kerteszsasa/kicad_user_lib/README.md

# kicad_user_lib

## Usage:
* Clone the repo to anywhere to your home folder
* Configure CUSTOM_SYMBOL_DIR, CUSTOM_FOOTPRINT_DIR, CUSTOM_3DMODEL_DIR paths at kicad
* Find the kicad configuration folder, mine is at /home/kerteszs/.config/kicad/9.0
* Extend the sym-lib-table with fp-lib-table-extension
* Extend the fp-lib-table table with fp-lib-table-extension
