kerteszsasa/kicad_user_lib/external_plugins/idata_release/idata_release.png

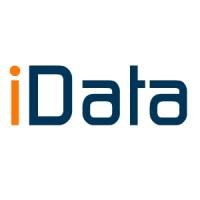
external_plugins/idata_release/idata_release.png
