kerteszsasa/kicad_user_lib/external_plugins/LCSC_import/LCSC_import.png

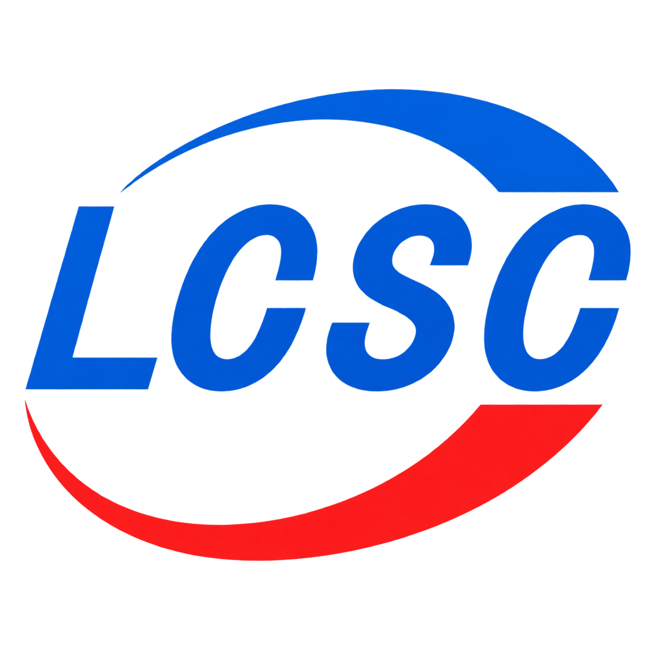
external_plugins/LCSC_import/LCSC_import.png
