kerteszsasa/kicad_user_lib/3dmodels/Rf_conn_SMB.stp

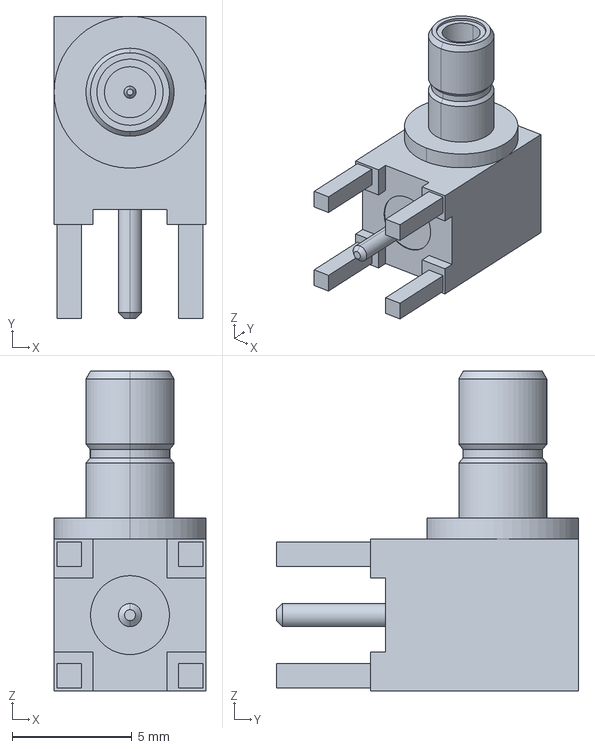
[picture p3: CAD file, 2026-07-15]
3dmodels/Rf_conn_SMB.stp
6.35 x 12.6 x 13.4 mm
