kerteszsasa/kicad_user_lib/3dmodels/CAP-SMD_L4.3-W4.3-H5.3-LS5.1.step

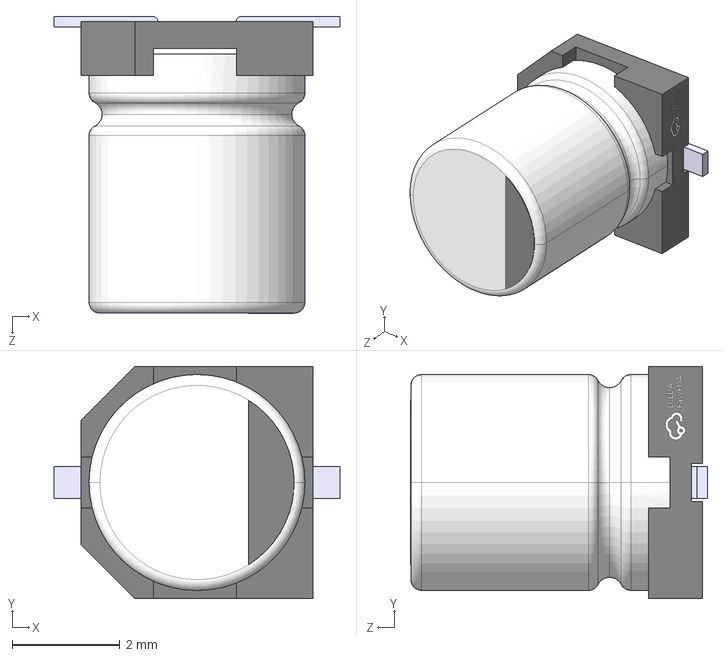
[picture p4: CAD file, 2026-04-13]
3dmodels/CAP-SMD_L4.3-W4.3-H5.3-LS5.1.step
5.30 x 4.30 x 5.51 mm
