kerteszsasa/kicad_user_lib/3dmodels/DC-IN-TH_DC-005-A200.step

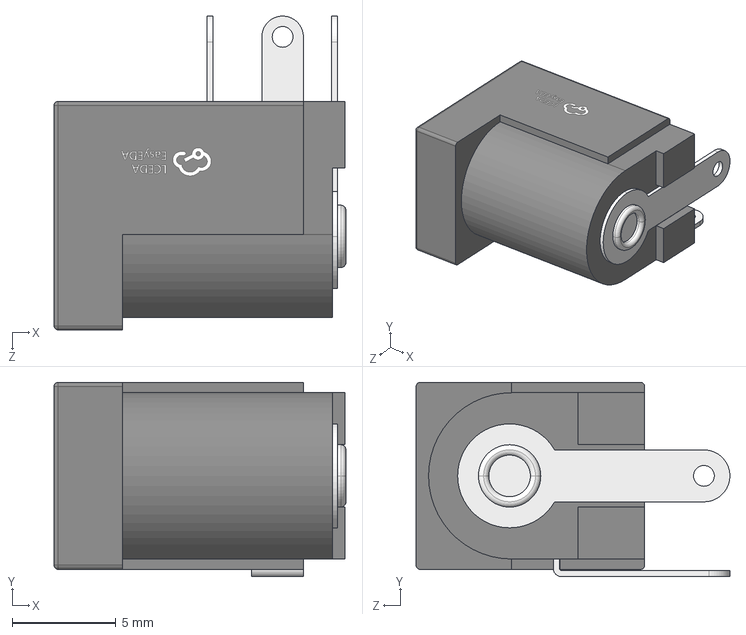
[picture p5: CAD file, 2026-04-13]
3dmodels/DC-IN-TH_DC-005-A200.step
14.1 x 9.35 x 15.1 mm
