kerteszsasa/kicad_user_lib/3dmodels/CAP-SMD_BD10.0-L10.3-W10.3-LS11.3-FD.step

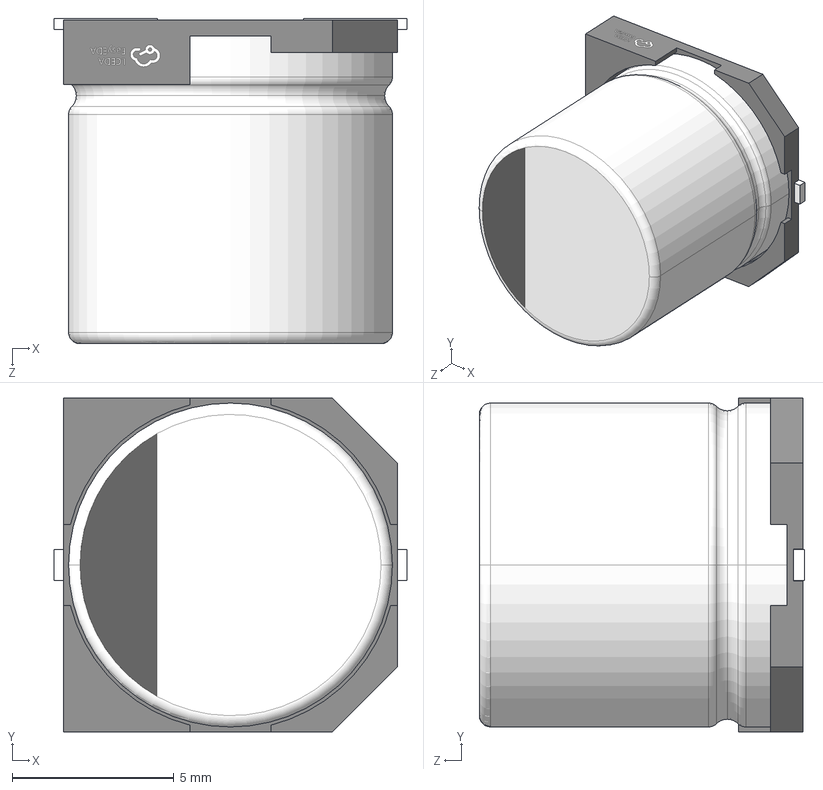
[picture p6: CAD file, 2026-04-13]
3dmodels/CAP-SMD_BD10.0-L10.3-W10.3-LS11.3-FD.step
10.9 x 10.3 x 10.1 mm
