kerteszsasa/kicad_user_lib/3dmodels/CAP-SMD_BD6.3-L6.6-W6.6-FD.step

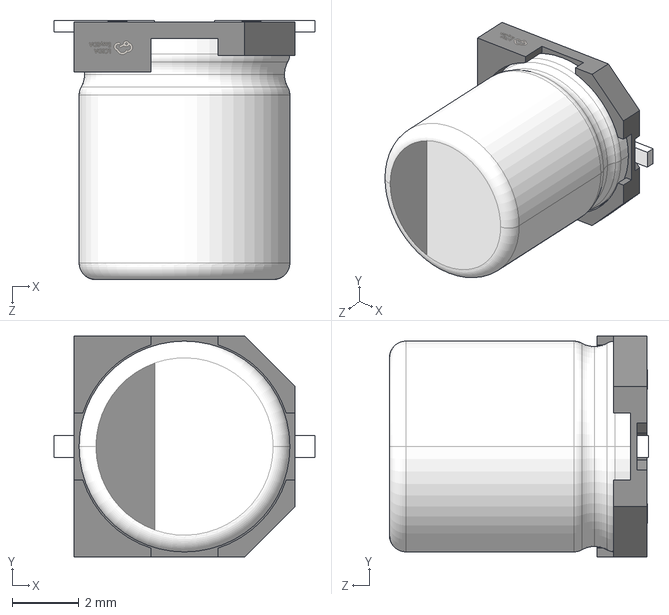
[picture p7: CAD file, 2026-04-13]
3dmodels/CAP-SMD_BD6.3-L6.6-W6.6-FD.step
7.80 x 6.60 x 7.75 mm
