kerteszsasa/kicad_user_lib/3dmodels/RJ11-TH_FRJ11008-1100K6K20.step

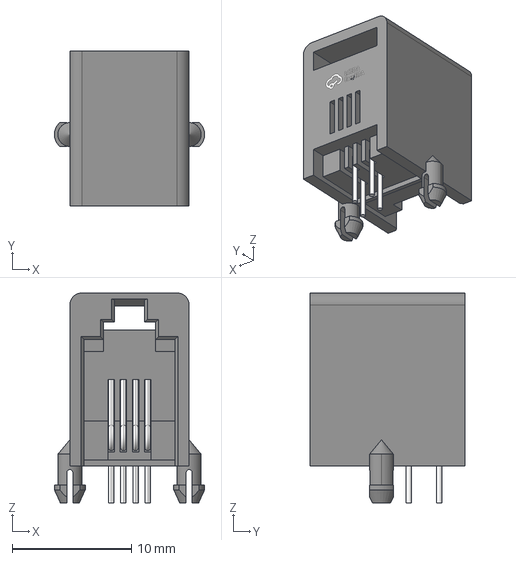
[picture p8: CAD file, 2026-04-13]
3dmodels/RJ11-TH_FRJ11008-1100K6K20.step
12.6 x 13.0 x 17.6 mm
