kerteszsasa/kicad_user_lib/3dmodels/ESP32-S3-Zero_v2.stp

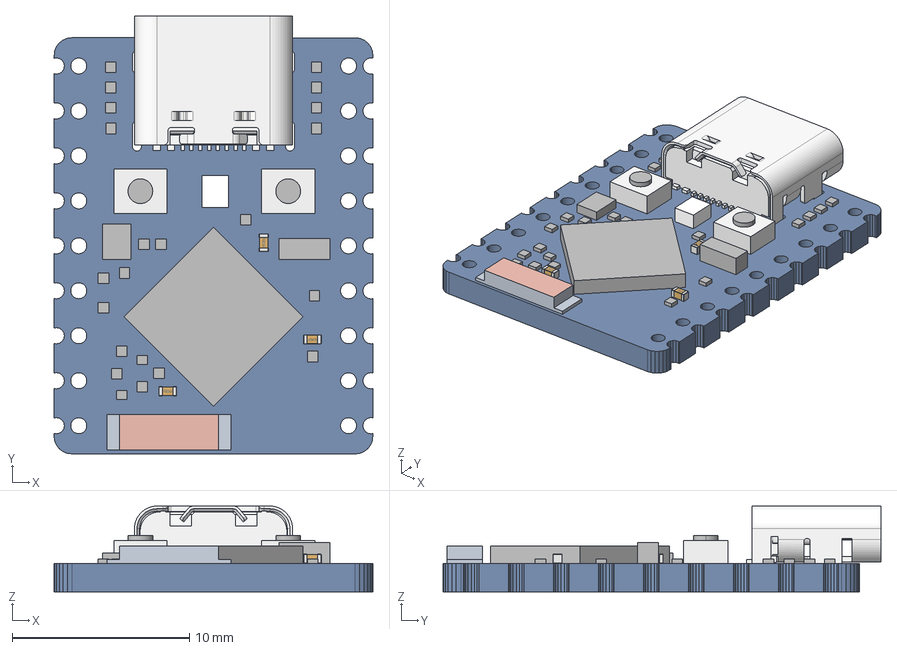
[picture p9: CAD file, 2026-02-24]
3dmodels/ESP32-S3-Zero_v2.stp
18.0 x 24.7 x 4.85 mm
BOARD
EXTRUDED-21020 x 13
EXTRUDED-21415 x 7
3_1_A x 3
EXTRUDED-58116 x 2
EXTRUDED-58651
EXTRUDED-59046
EXTRUDED-59609
TYPE-C_16PIN-9X3X7_3
PRT0001
C3
BUTTON-2X3XH1_5
