kerteszsasa/kicad_user_lib/3dmodels/Inductor_0805.step

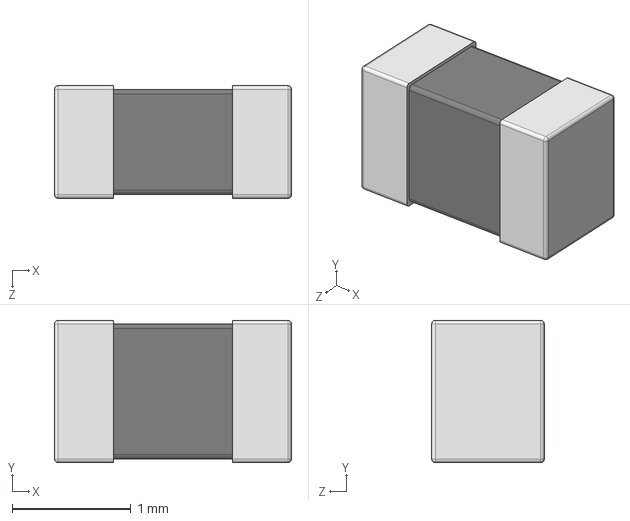
[picture p10: CAD file, 2026-02-13]
3dmodels/Inductor_0805.step
2.00 x 1.20 x 0.95 mm
