kerteszsasa/kicad_user_lib/3dmodels/SOT-23-5_L2.9-W1.6-P0.95-LS2.8-BL.step

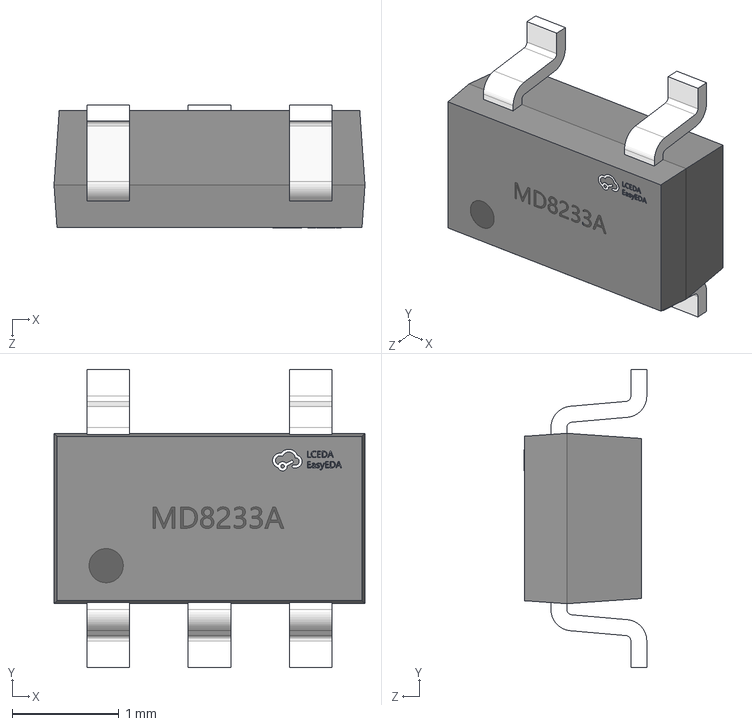
[picture p11: CAD file, 2026-02-13]
3dmodels/SOT-23-5_L2.9-W1.6-P0.95-LS2.8-BL.step
2.92 x 2.80 x 1.15 mm
