kerteszsasa/kicad_user_lib/3dmodels/P100-E2.STEP

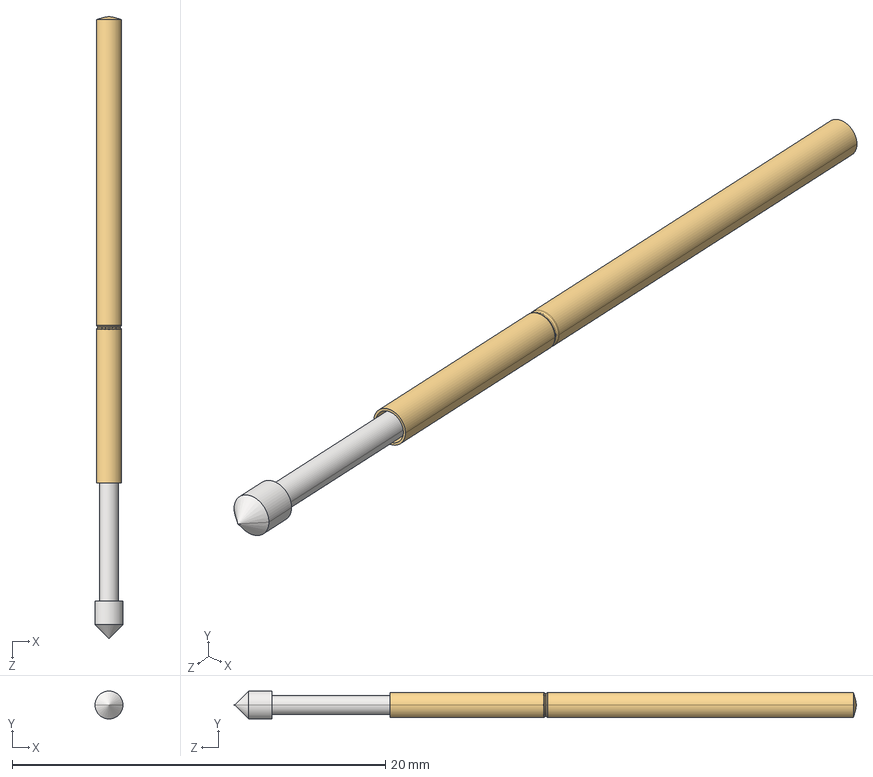
[picture p12: CAD file, 2026-01-14]
3dmodels/P100-E2.STEP
1.50 x 1.50 x 33.4 mm
Pogo_Base
Pogo_E2
Pogo_Vastago
