kerteszsasa/kicad_user_lib/3dmodels/KLS1-202E-06-S-B.step

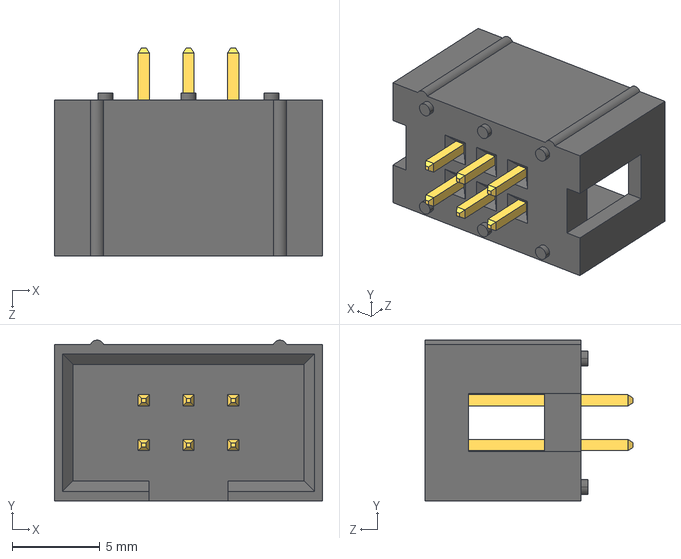
[picture p13: CAD file, 2026-01-09]
3dmodels/KLS1-202E-06-S-B.step
15.2 x 9.14 x 11.9 mm
