kerteszsasa/kicad_user_lib/3dmodels/SOP-16_L9.9-W3.9-H1.5-LS6.0-P1.27.step

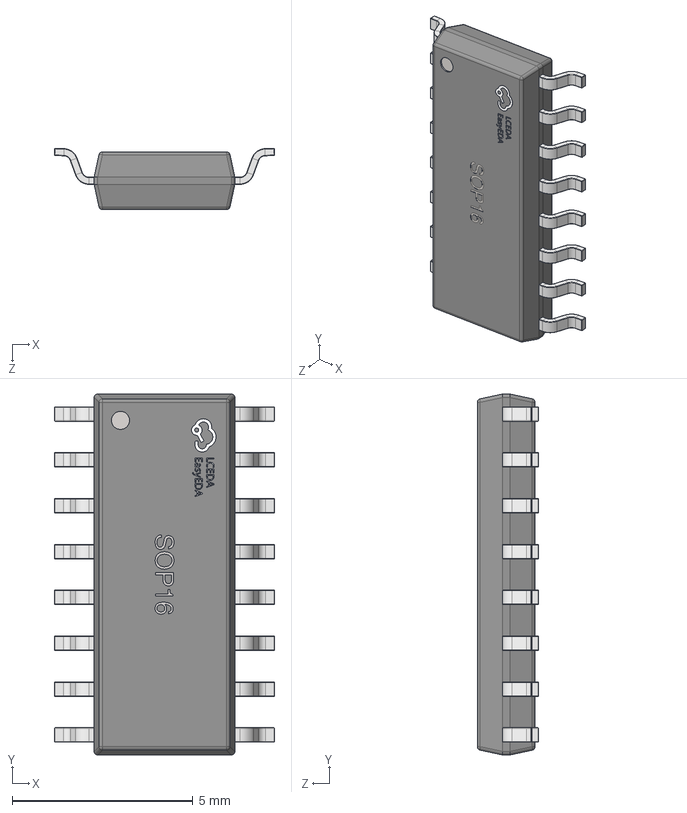
[picture p14: CAD file, 2026-01-09]
3dmodels/SOP-16_L9.9-W3.9-H1.5-LS6.0-P1.27.step
6.11 x 10.0 x 1.70 mm
