kerteszsasa/kicad_user_lib/3dmodels/SOT-23-6_L2.9-W1.6-H1.5-LS2.8-P0.95.step

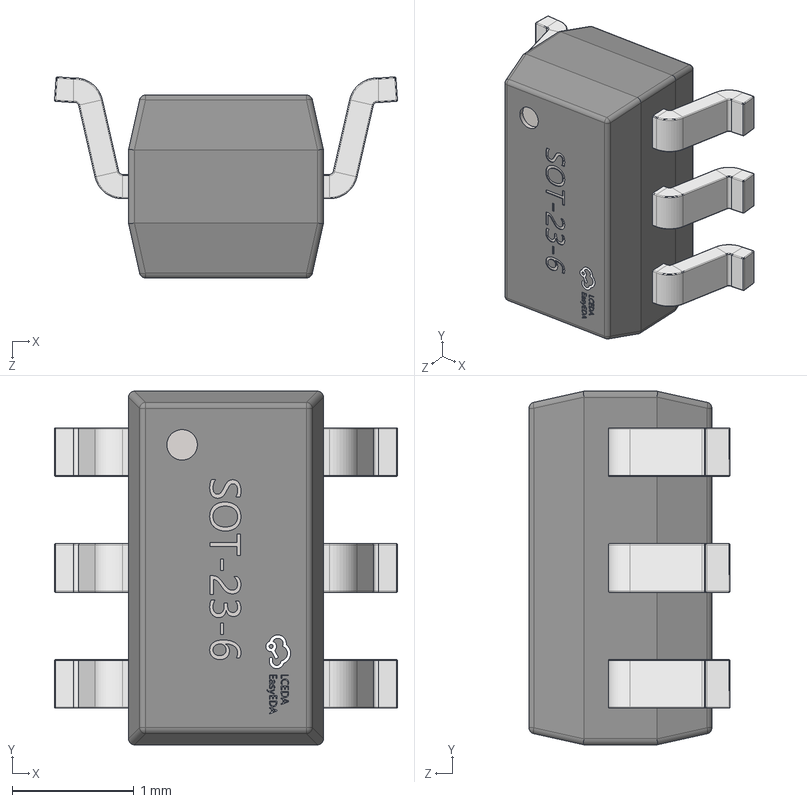
[picture p16: CAD file, 2025-12-18]
3dmodels/SOT-23-6_L2.9-W1.6-H1.5-LS2.8-P0.95.step
2.81 x 2.90 x 1.65 mm
