kerteszsasa/kicad_user_lib/3dmodels/SW-TH_EC12D1564402-L12.5-W11.7-H17.5-P11.1-LS14.1.step

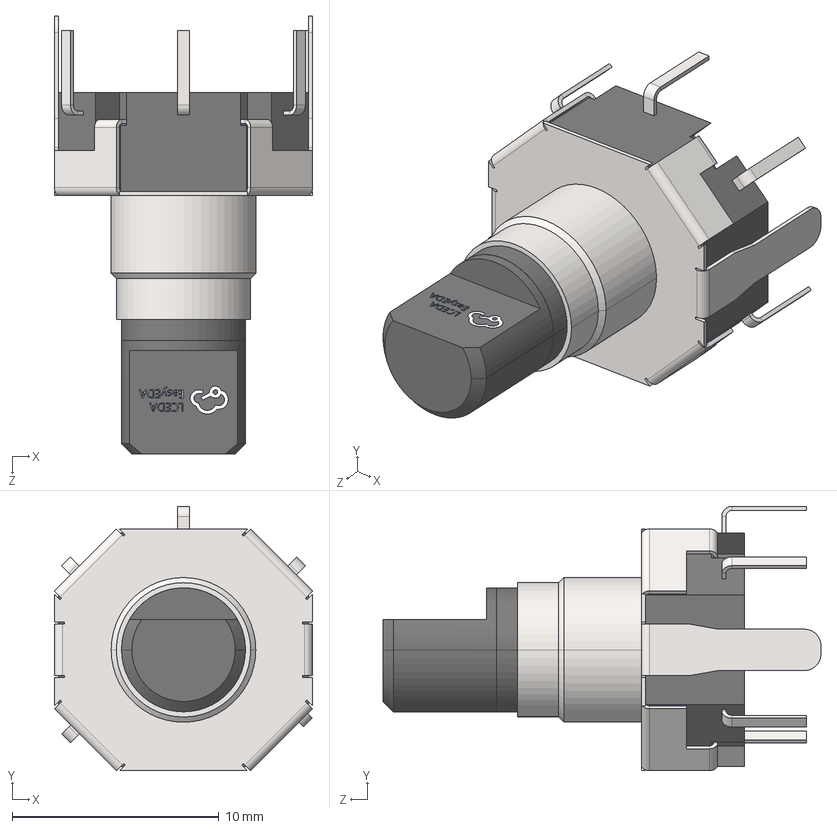
[picture p17: CAD file, 2025-12-18]
3dmodels/SW-TH_EC12D1564402-L12.5-W11.7-H17.5-P11.1-LS14.1.step
12.5 x 12.8 x 21.2 mm
