kerteszsasa/kicad_user_lib/3dmodels/SOT-23-5_L2.9-W1.6-P0.95-LS2.8-BR.step

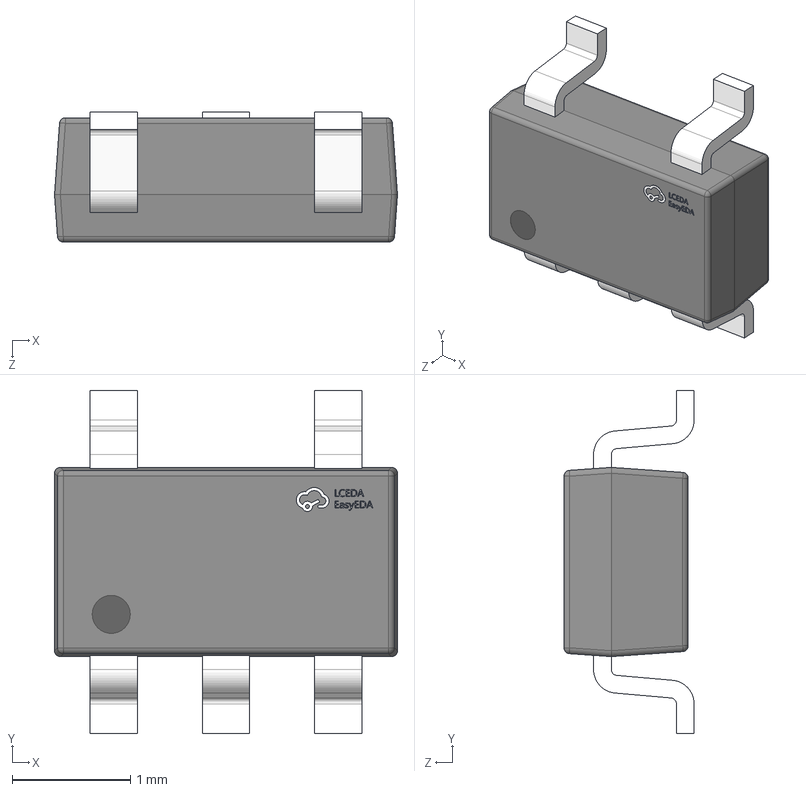
[picture p18: CAD file, 2025-12-18]
3dmodels/SOT-23-5_L2.9-W1.6-P0.95-LS2.8-BR.step
2.90 x 2.90 x 1.10 mm
