kerteszsasa/kicad_user_lib/3dmodels/ESOP-8_L4.9-W3.9-H1.6-LS6.0-P1.27.step

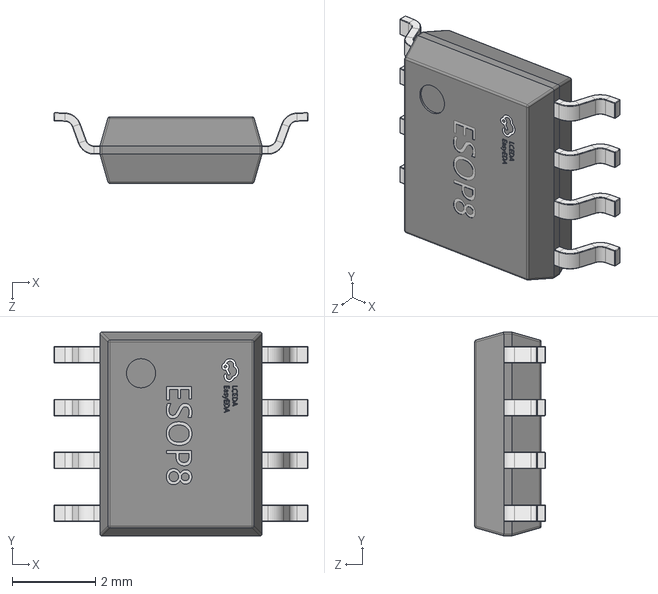
[picture p19: CAD file, 2025-12-18]
3dmodels/ESOP-8_L4.9-W3.9-H1.6-LS6.0-P1.27.step
6.11 x 4.90 x 1.70 mm
