kerteszsasa/kicad_user_lib/3dmodels/SW-TH_5P-L12.5-W13.4-P2.50-LS14.5.step

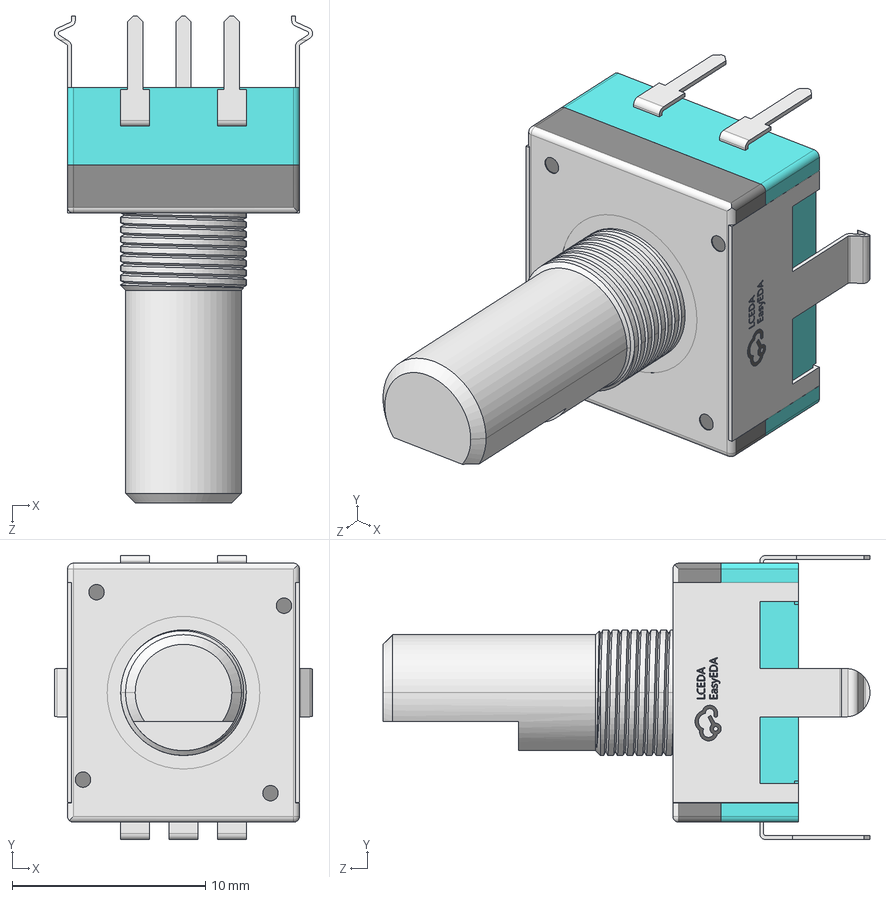
[picture p20: CAD file, 2025-12-03]
3dmodels/SW-TH_5P-L12.5-W13.4-P2.50-LS14.5.step
13.4 x 14.7 x 25.2 mm
