kerteszsasa/kicad_user_lib/3dmodels/SW-SMD_HX-TS-1101-C-W.step

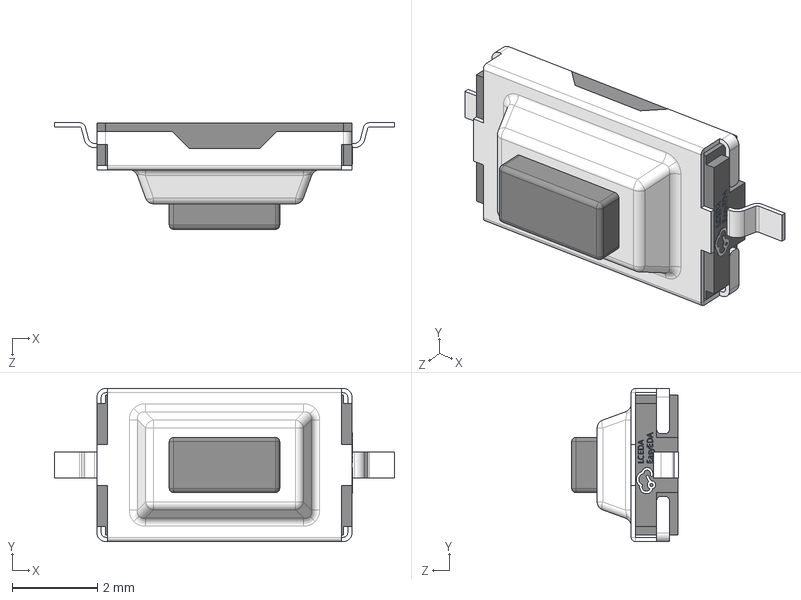
[picture p21: CAD file, 2025-12-03]
3dmodels/SW-SMD_HX-TS-1101-C-W.step
8.00 x 3.60 x 2.51 mm
