kerteszsasa/kicad_user_lib/3dmodels/LED-SMD_4P-L2.0-W1.8_XL-0807RGBC-WS2812B.step

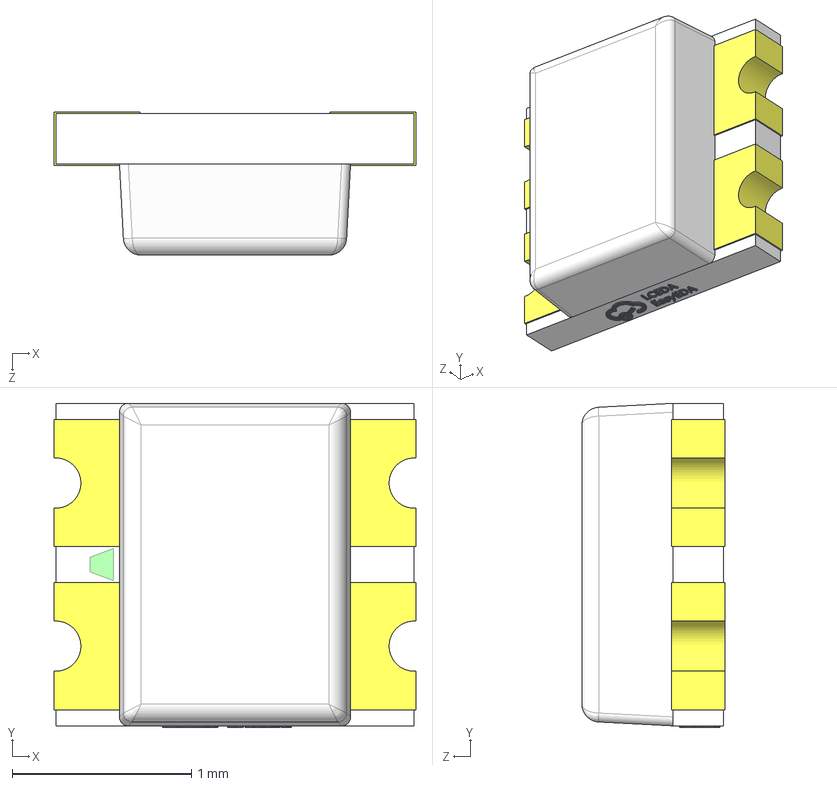
[picture p22: CAD file, 2025-12-03]
3dmodels/LED-SMD_4P-L2.0-W1.8_XL-0807RGBC-WS2812B.step
2.02 x 1.81 x 0.8 mm
