kerteszsasa/kicad_user_lib/3dmodels/CONN-TH_6P-P2.50_HC-XH-6AW-G.step

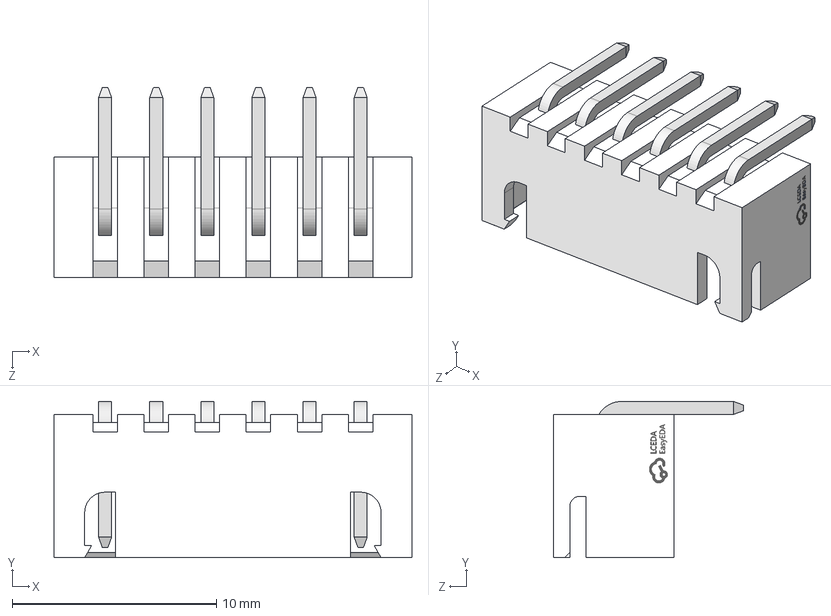
[picture p23: CAD file, 2025-10-06]
3dmodels/CONN-TH_6P-P2.50_HC-XH-6AW-G.step
17.5 x 7.64 x 9.30 mm
