kerteszsasa/kicad_user_lib/3dmodels/SOP-16_L9.9-W3.9-P1.27-LS6.1-BL.step

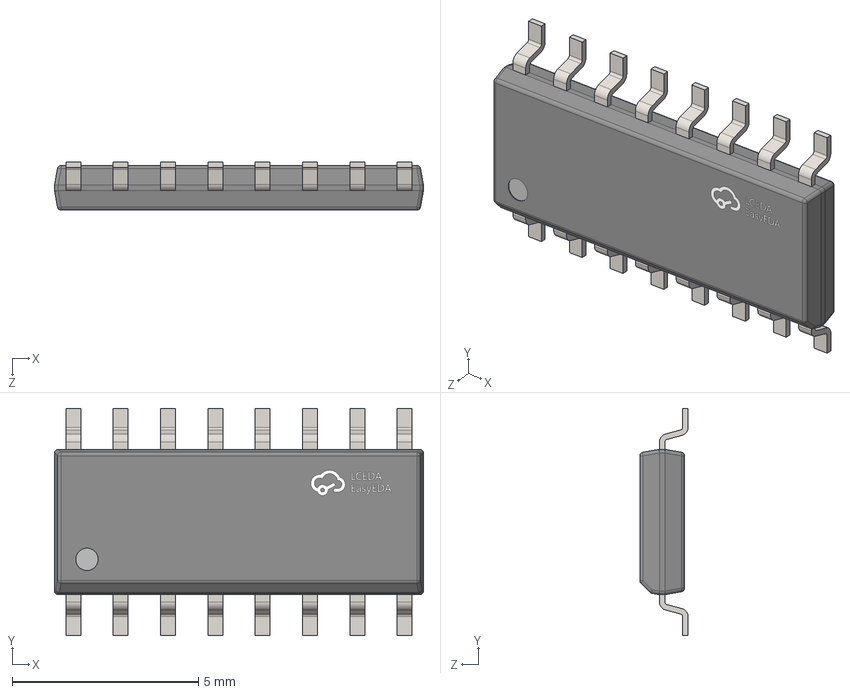
[picture p24: CAD file, 2025-08-15]
3dmodels/SOP-16_L9.9-W3.9-P1.27-LS6.1-BL.step
9.90 x 6.10 x 1.30 mm
