kerteszsasa/kicad_user_lib/3dmodels/SC-70-6_L2.0-W1.3-P0.65-LS2.1-BL.step

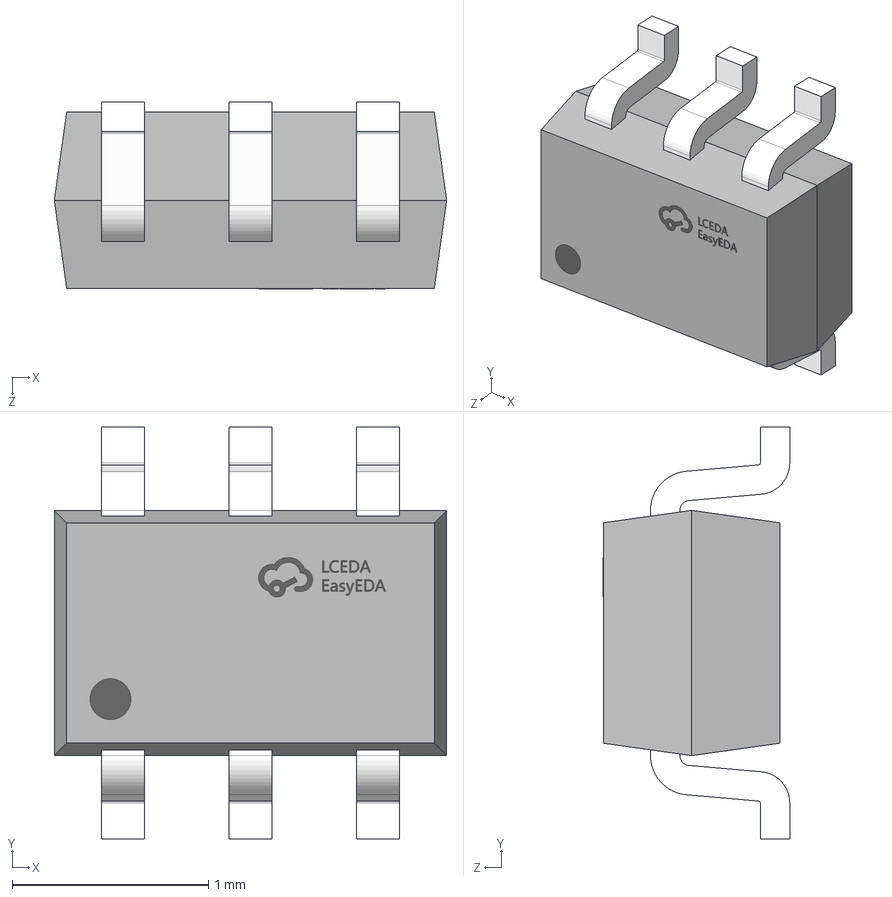
[picture p25: CAD file, 2025-08-15]
3dmodels/SC-70-6_L2.0-W1.3-P0.65-LS2.1-BL.step
2.00 x 2.10 x 0.951 mm
