kerteszsasa/kicad_user_lib/3dmodels/SOT-23-5_L2.9-W1.6-H1.1-LS2.8-P0.95.step

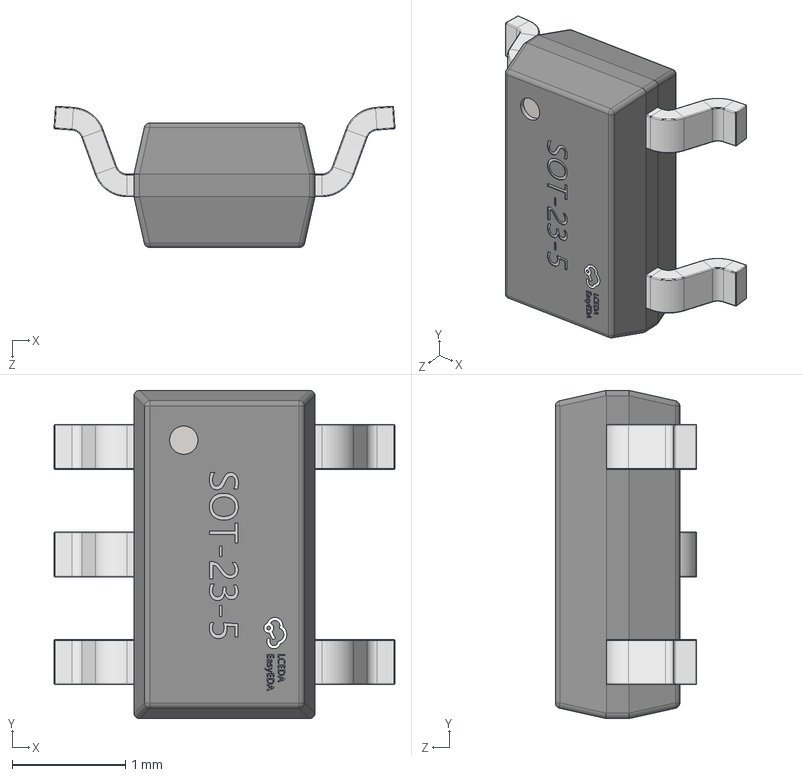
[picture p26: CAD file, 2025-08-15]
3dmodels/SOT-23-5_L2.9-W1.6-H1.1-LS2.8-P0.95.step
3.01 x 2.90 x 1.25 mm
