kerteszsasa/kicad_user_lib/3dmodels/ESP32-WROOM-32D-N4.STEP

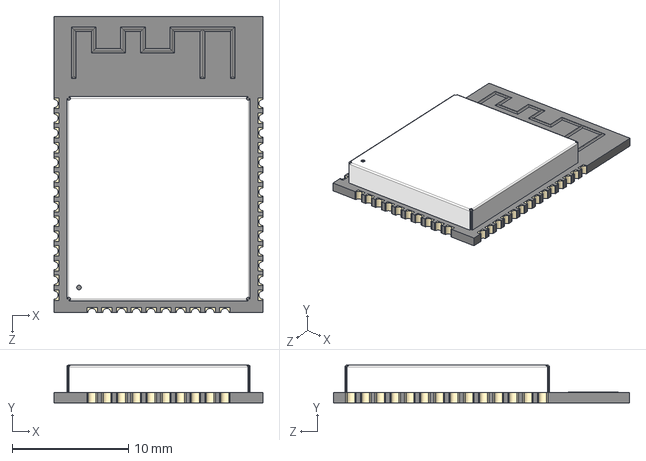
[picture p27: CAD file, 2025-07-17]
3dmodels/ESP32-WROOM-32D-N4.STEP
18.0 x 3.25 x 25.5 mm
