kerteszsasa/kicad_user_lib/3dmodels/QFN50P400X400X100-25N.STEP

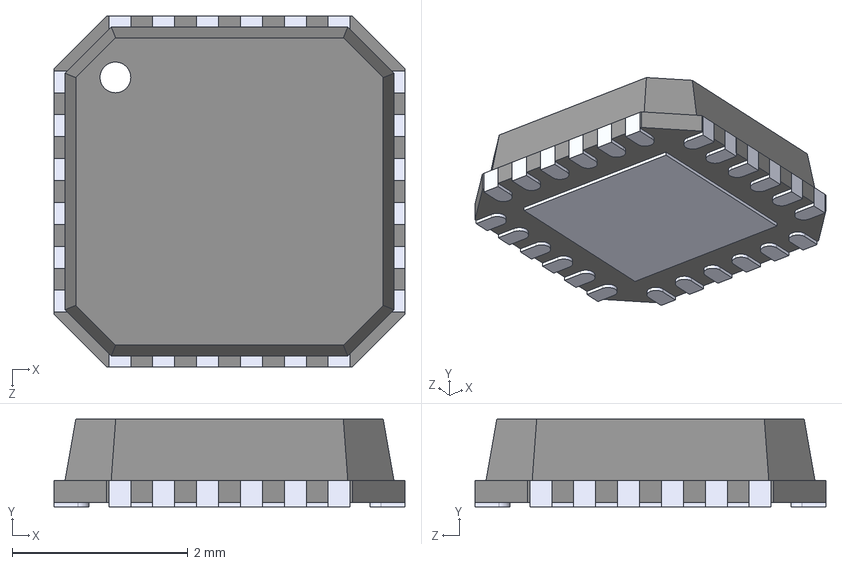
[picture p28: CAD file, 2025-07-17]
3dmodels/QFN50P400X400X100-25N.STEP
4.00 x 1.00 x 4.00 mm
