kerteszsasa/kicad_user_lib/3dmodels/CONN-SMD_4P-L6.0-W2.9-H4.3-P1.0.step

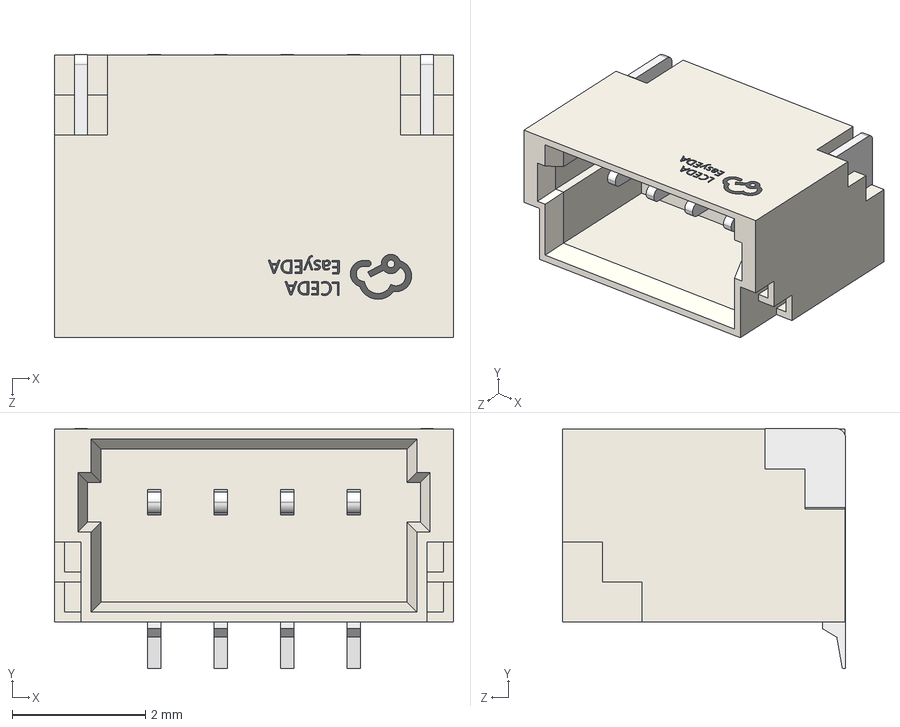
[picture p29: CAD file, 2025-07-17]
3dmodels/CONN-SMD_4P-L6.0-W2.9-H4.3-P1.0.step
6.00 x 3.61 x 4.26 mm
