kerteszsasa/kicad_user_lib/3dmodels/F1210_L3.2-W2.6-H0.6.step

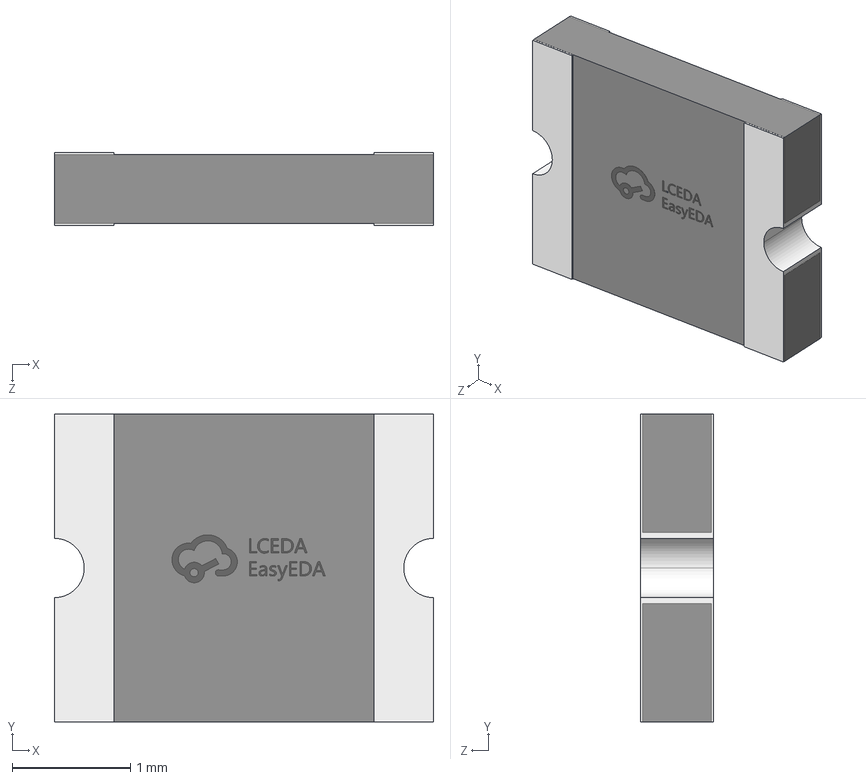
[picture p30: CAD file, 2025-07-13]
3dmodels/F1210_L3.2-W2.6-H0.6.step
3.20 x 2.60 x 0.62 mm
