kerteszsasa/kicad_user_lib/3dmodels/Ag9900.step

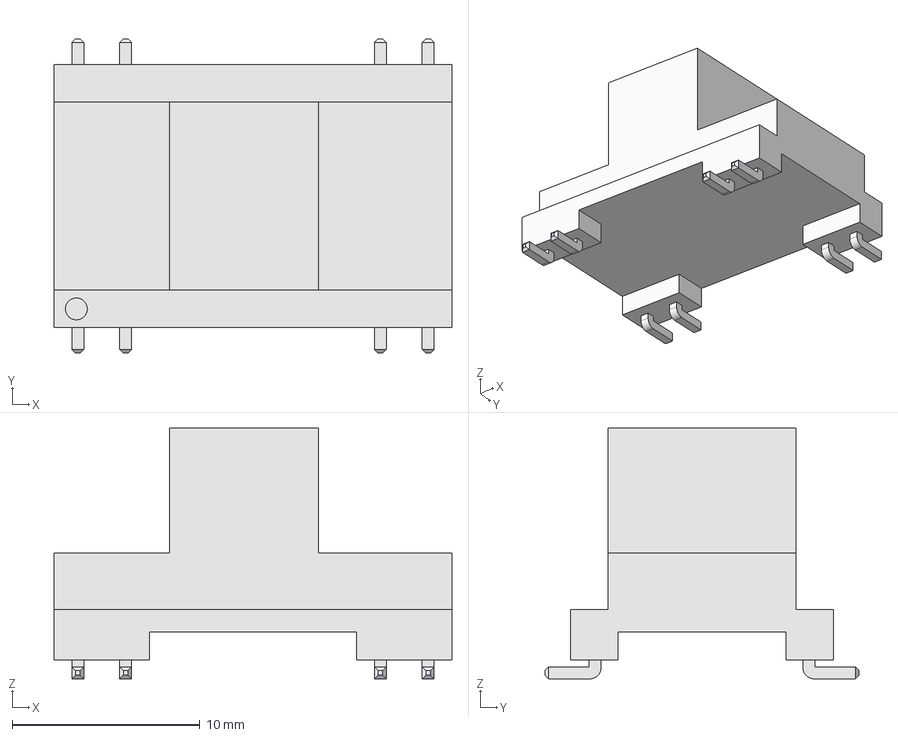
[picture p31: CAD file, 2025-07-13]
3dmodels/Ag9900.step
21.2 x 16.7 x 13.3 mm
