kerteszsasa/kicad_user_lib/3dmodels/SOD-323_L1.8-W1.3-LS2.5-RD.step

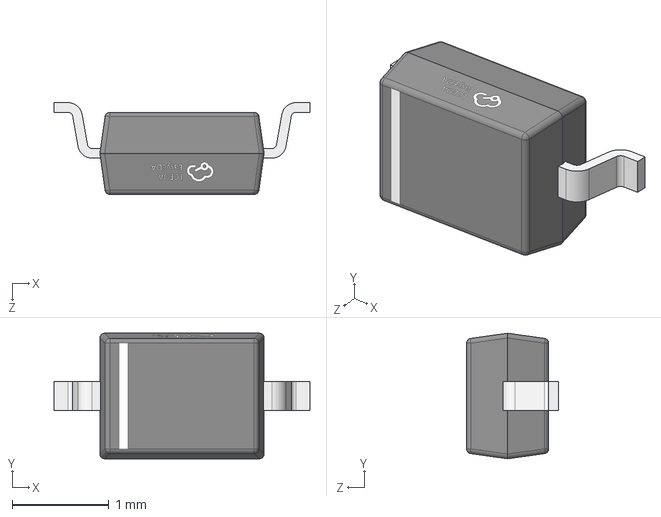
[picture p32: CAD file, 2025-07-12]
3dmodels/SOD-323_L1.8-W1.3-LS2.5-RD.step
2.65 x 1.30 x 0.95 mm
