kerteszsasa/kicad_user_lib/3dmodels/RELAY-TH_93.11.step

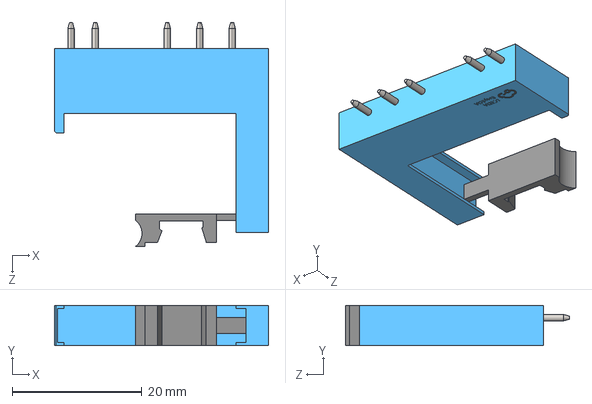
[picture p33: CAD file, 2025-07-10]
3dmodels/RELAY-TH_93.11.step
33.0 x 6.21 x 34.5 mm
