kerteszsasa/kicad_user_lib/3dmodels/LED-SMD_4P-L2.0-W1.8_CY-0807.step

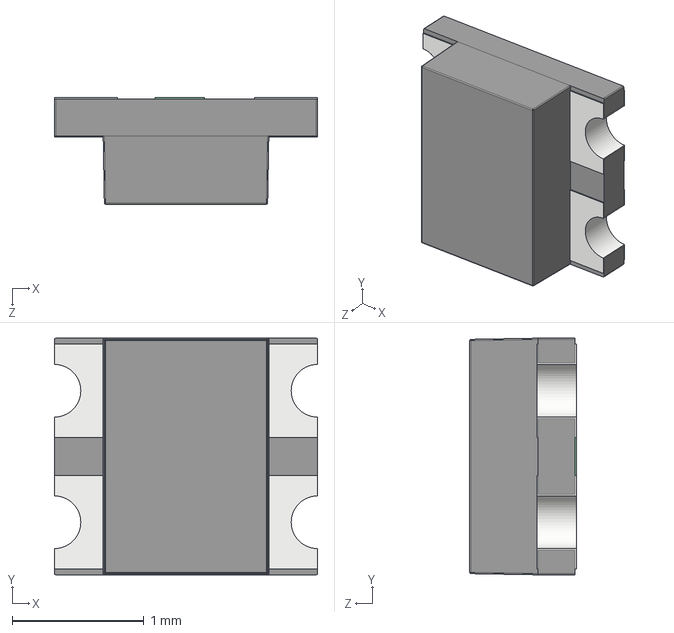
[picture p34: CAD file, 2025-07-10]
3dmodels/LED-SMD_4P-L2.0-W1.8_CY-0807.step
2.00 x 1.80 x 0.81 mm
