kerteszsasa/kicad_user_lib/3dmodels/LED-SMD_4P-L5.0-W5.0-H1.6-P3.2.step

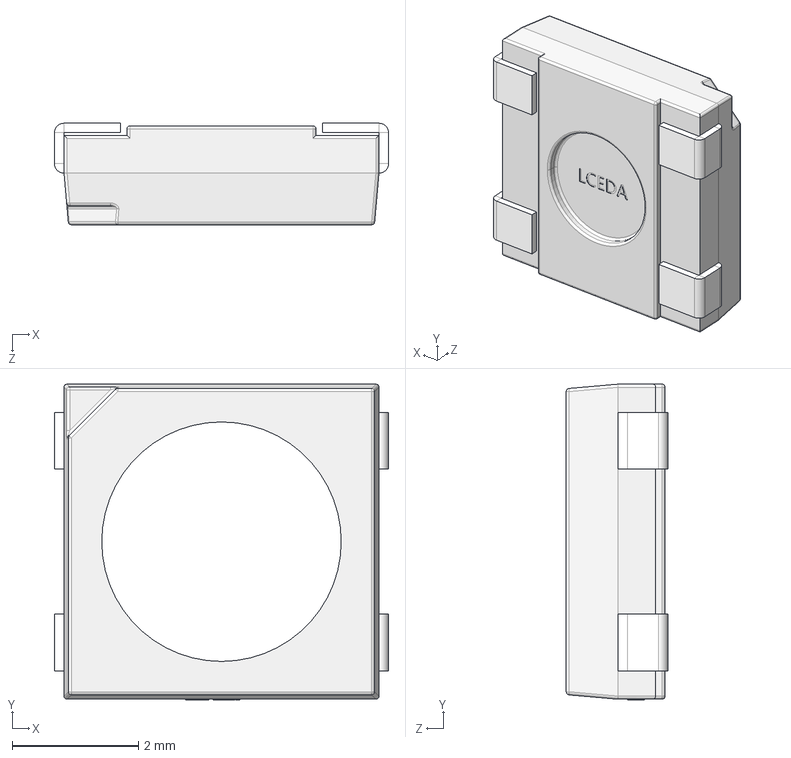
[picture p35: CAD file, 2025-07-10]
3dmodels/LED-SMD_4P-L5.0-W5.0-H1.6-P3.2.step
5.30 x 5.01 x 1.61 mm
