kerteszsasa/kicad_user_lib/3dmodels/CONN-TH_DB301V-3.5-3P-GN.step

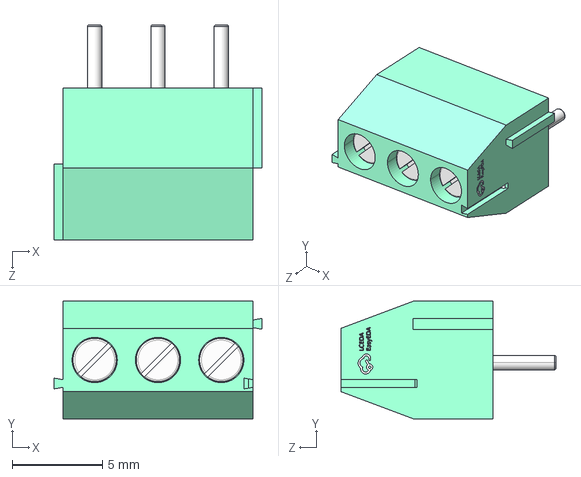
[picture p37: CAD file, 2025-07-10]
3dmodels/CONN-TH_DB301V-3.5-3P-GN.step
11.5 x 6.50 x 11.9 mm
