kerteszsasa/kicad_user_lib/3dmodels/HS91L02W2C01.stp

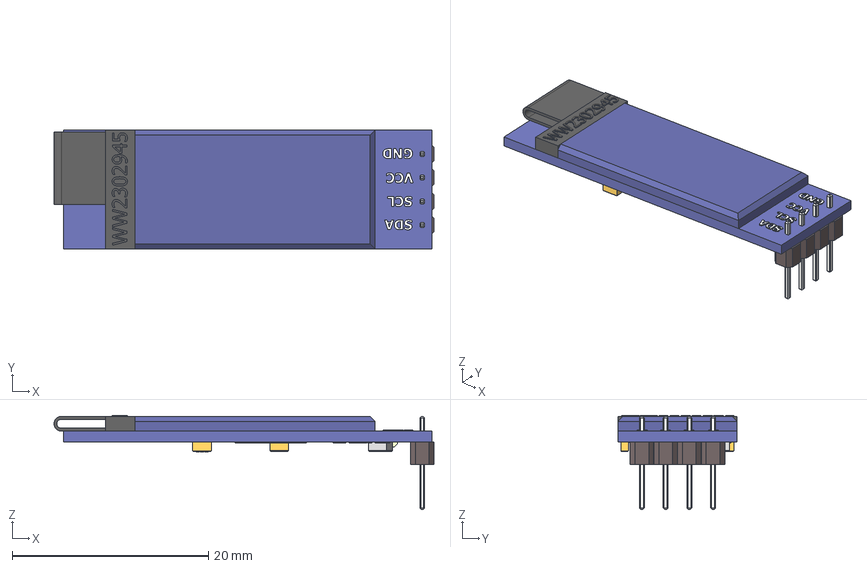
[picture p38: CAD file, 2025-07-01]
3dmodels/HS91L02W2C01.stp
38.7 x 12.1 x 9.60 mm
