kerteszsasa/kicad_user_lib/3dmodels/TF-01A.step

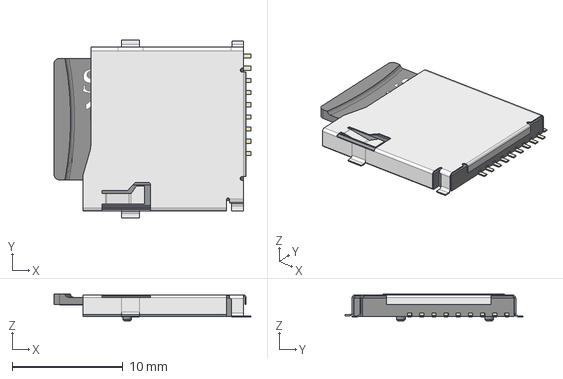
[picture p39: CAD file, 2025-06-27]
3dmodels/TF-01A.step
17.8 x 16.1 x 2.40 mm
