kerteszsasa/kicad_user_lib/3dmodels/IND-SMD_L2.5-W2.0-H1.2.step

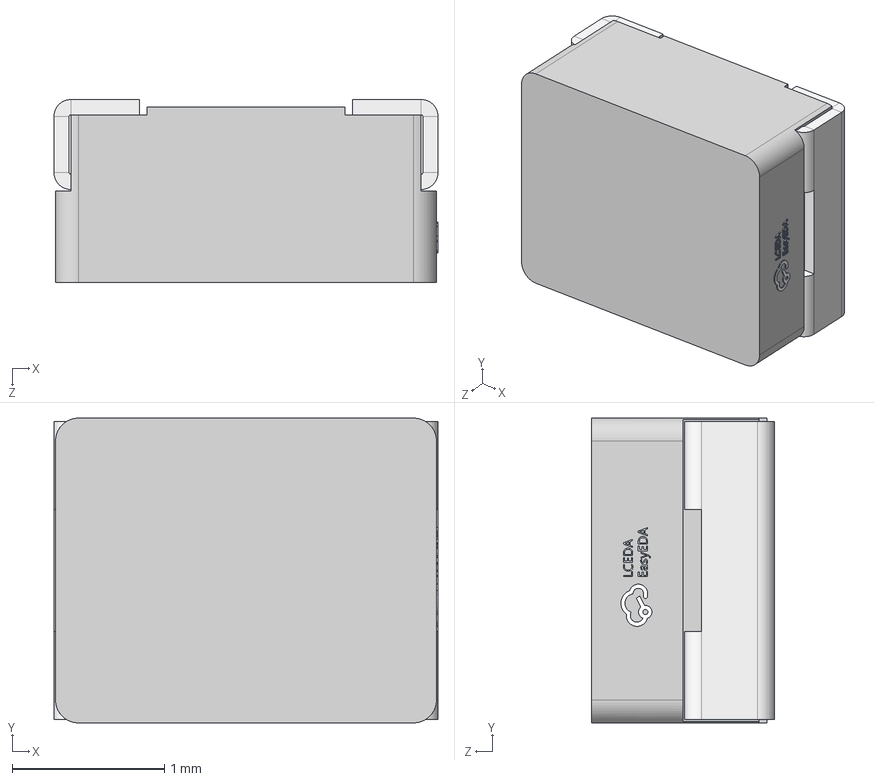
[picture p40: CAD file, 2025-06-27]
3dmodels/IND-SMD_L2.5-W2.0-H1.2.step
2.52 x 2.00 x 1.20 mm
