kerteszsasa/kicad_user_lib/3dmodels/SOT-23-3P_L2.9-W1.3-H1.0-LS2.4-P0.95.step

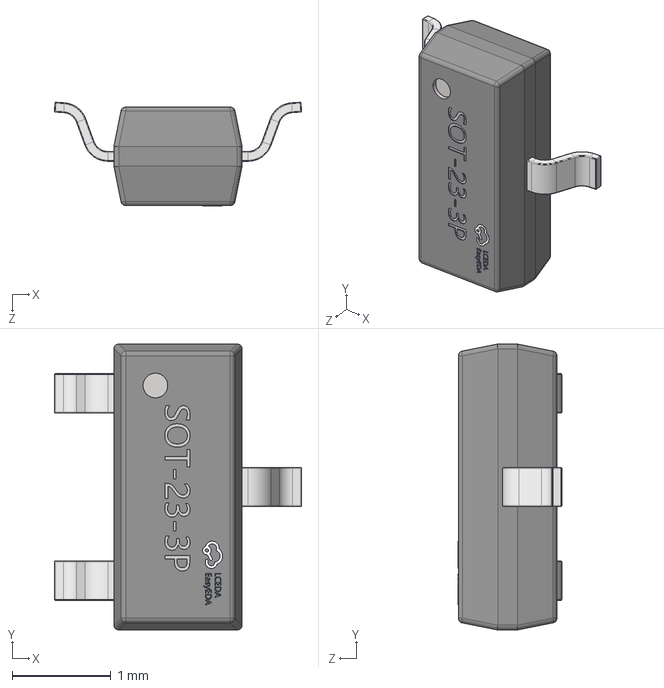
[picture p41: CAD file, 2025-06-26]
3dmodels/SOT-23-3P_L2.9-W1.3-H1.0-LS2.4-P0.95.step
2.51 x 2.90 x 1.05 mm
