kerteszsasa/kicad_user_lib/3dmodels/SOT-23-3L_L2.9-W1.6-H1.1-LS2.8-P0.95.step

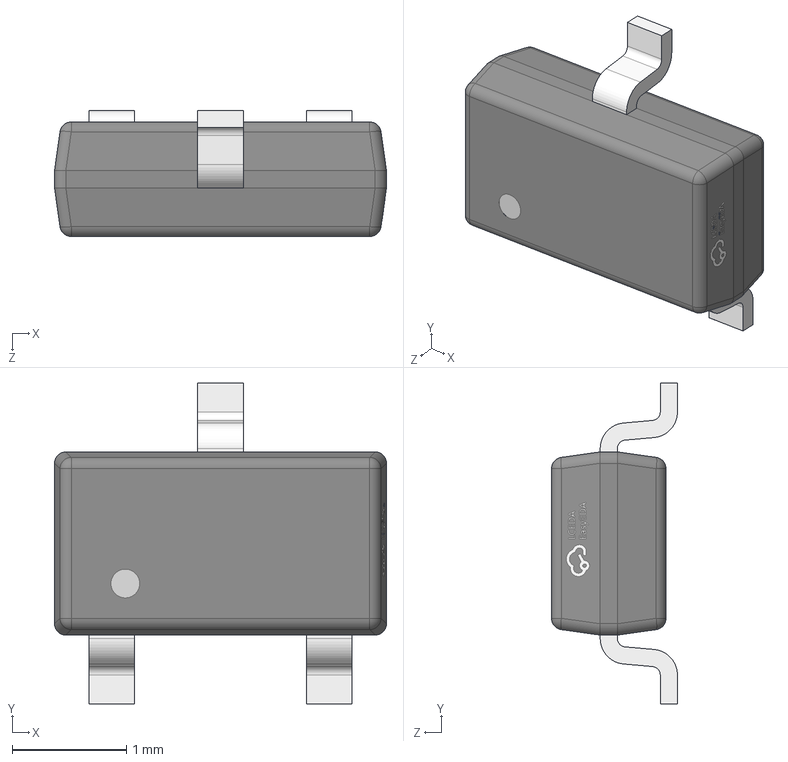
[picture p42: CAD file, 2025-06-26]
3dmodels/SOT-23-3L_L2.9-W1.6-H1.1-LS2.8-P0.95.step
2.90 x 2.80 x 1.10 mm
