kerteszsasa/kicad_user_lib/3dmodels/TSSOP-8_L3.0-W3.0-H1.1-LS4.9-P0.65.step

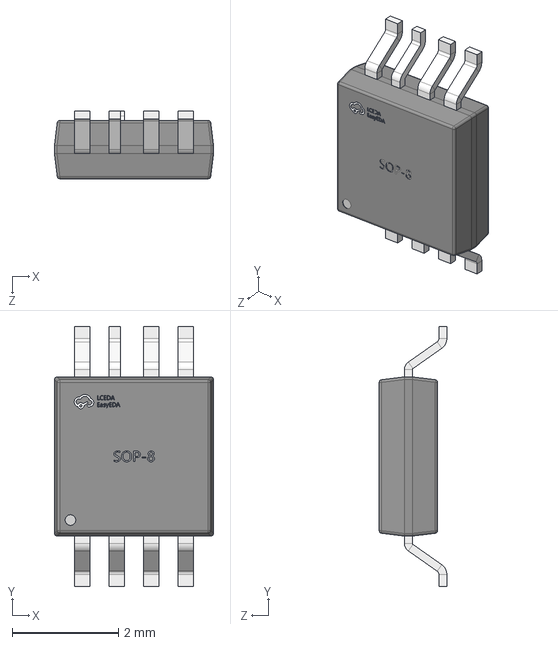
[picture p43: CAD file, 2025-06-26]
3dmodels/TSSOP-8_L3.0-W3.0-H1.1-LS4.9-P0.65.step
3.00 x 4.90 x 1.28 mm
