kerteszsasa/kicad_user_lib/3dmodels/OSC-SMD_L3.2-W1.5-H0.8.step

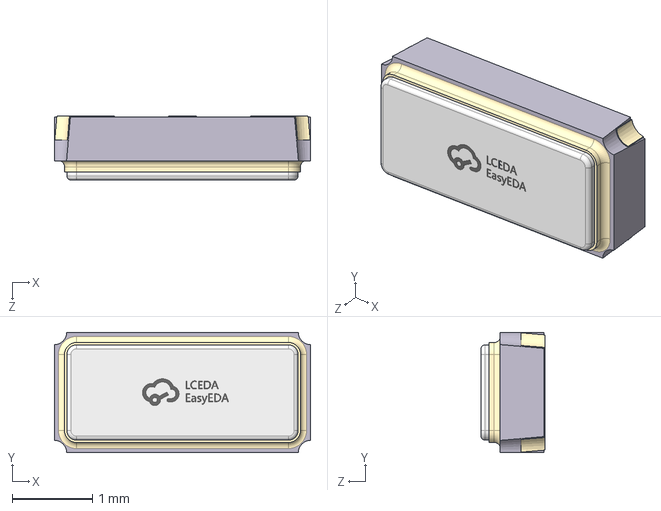
[picture p44: CAD file, 2025-06-26]
3dmodels/OSC-SMD_L3.2-W1.5-H0.8.step
3.20 x 1.50 x 0.801 mm
