kerteszsasa/kicad_user_lib/3dmodels/BAT-TH_MY-1220-01.step

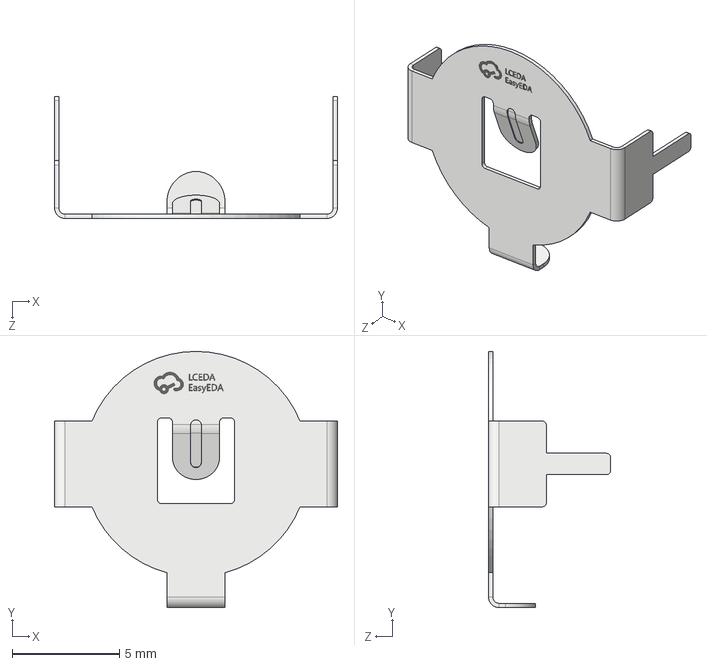
[picture p45: CAD file, 2025-06-26]
3dmodels/BAT-TH_MY-1220-01.step
13.2 x 11.9 x 5.71 mm
