kerteszsasa/kicad_user_lib/3dmodels/BAT-SMD_CR2032-3V.step

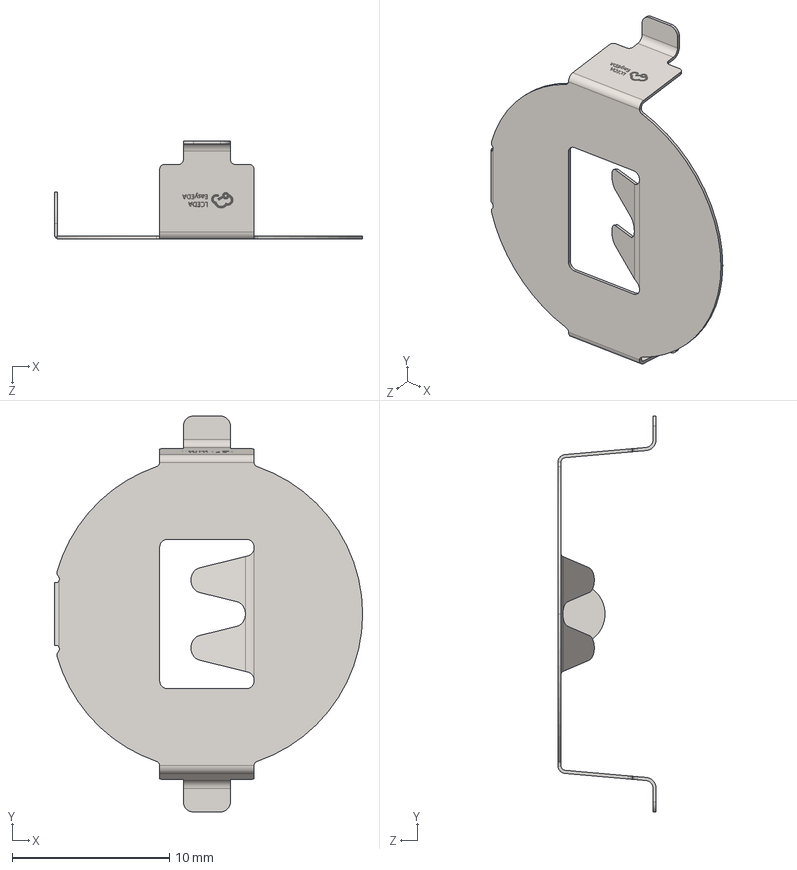
[picture p46: CAD file, 2025-06-26]
3dmodels/BAT-SMD_CR2032-3V.step
19.6 x 25.2 x 6.25 mm
