kerteszsasa/kicad_user_lib/3dmodels/TSOT-23-6_L2.9-W1.6-H1.1-LS2.8-P0.95.step

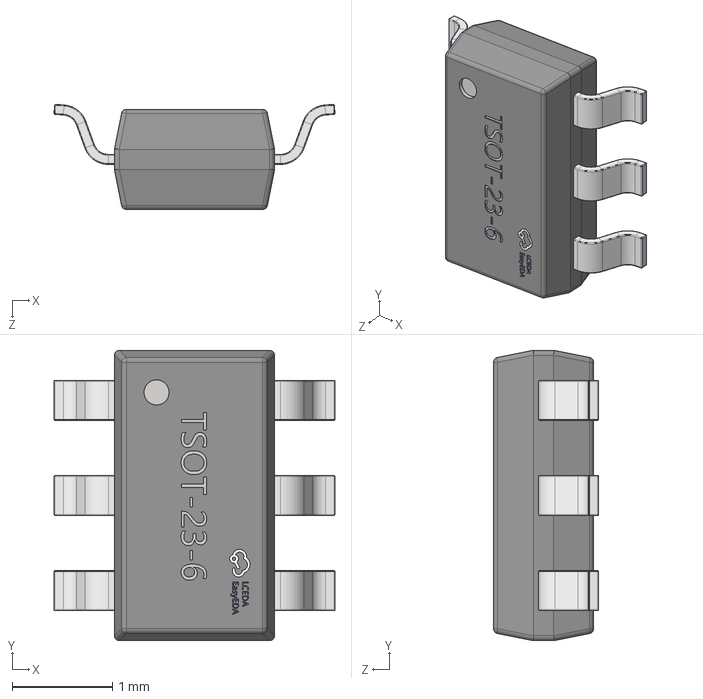
[picture p47: CAD file, 2025-06-26]
3dmodels/TSOT-23-6_L2.9-W1.6-H1.1-LS2.8-P0.95.step
2.81 x 2.90 x 1.05 mm
