kerteszsasa/kicad_user_lib/3dmodels/R0805.step

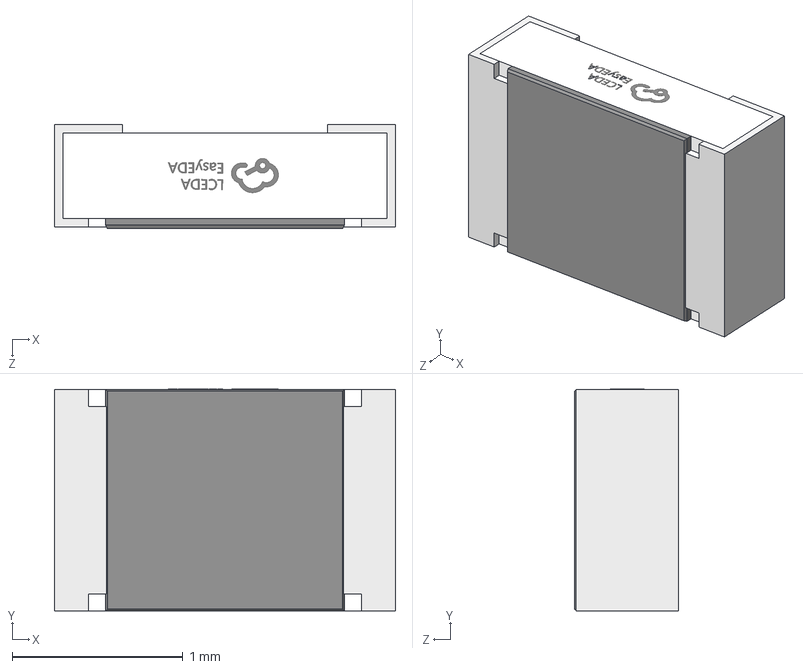
[picture p48: CAD file, 2025-06-26]
3dmodels/R0805.step
2.00 x 1.30 x 0.61 mm
