kerteszsasa/kicad_user_lib/3dmodels/R1206.step

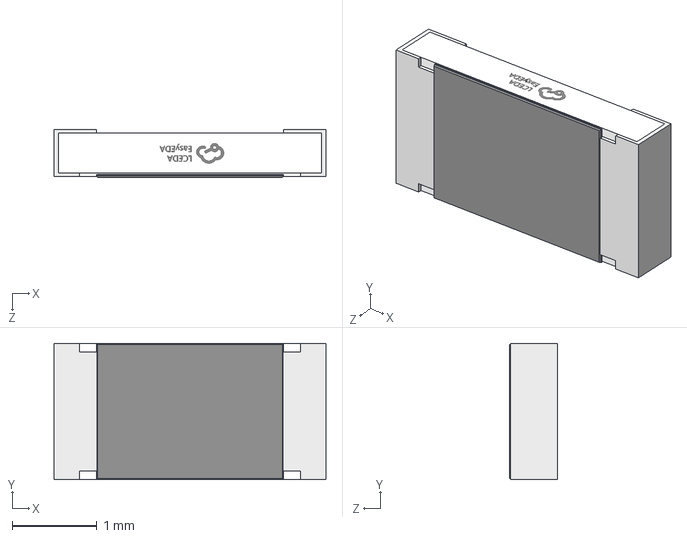
[picture p49: CAD file, 2025-06-26]
3dmodels/R1206.step
3.20 x 1.60 x 0.56 mm
