kerteszsasa/kicad_user_lib/3dmodels/C0805.step

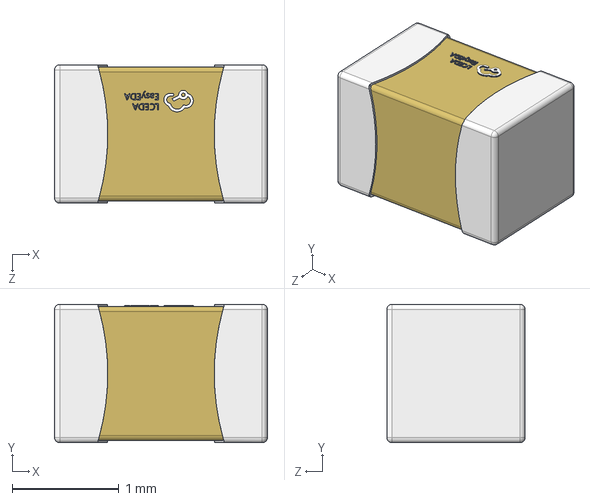
[picture p50: CAD file, 2025-06-26]
3dmodels/C0805.step
2.00 x 1.30 x 1.30 mm
