kerteszsasa/kicad_user_lib/3dmodels/C1206.step

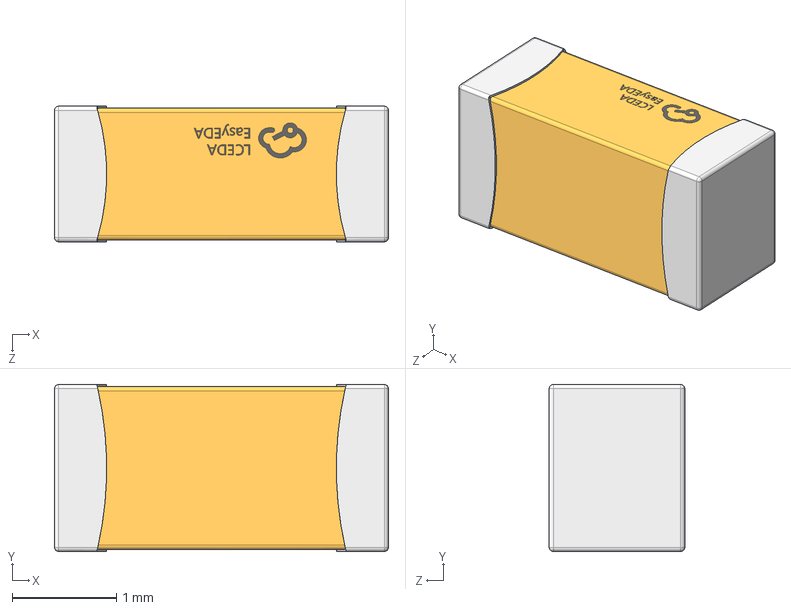
[picture p51: CAD file, 2025-06-26]
3dmodels/C1206.step
3.20 x 1.60 x 1.30 mm
