kerteszsasa/kicad_user_lib/3dmodels/R0402.step

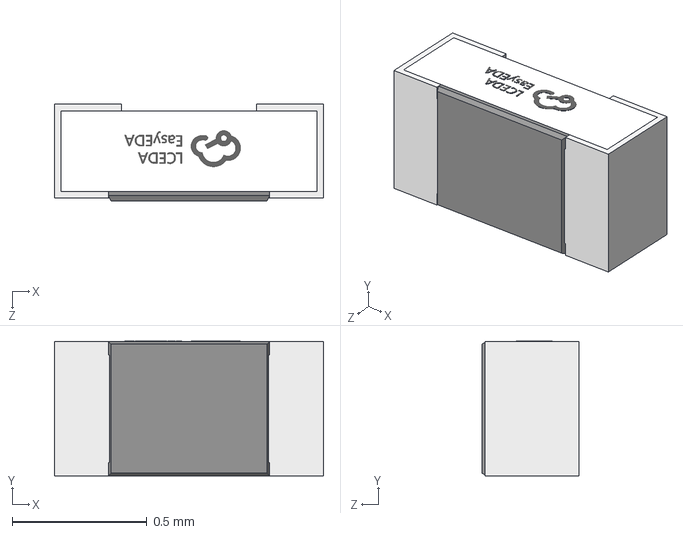
[picture p52: CAD file, 2025-06-26]
3dmodels/R0402.step
1.00 x 0.501 x 0.36 mm
