kerteszsasa/kicad_user_lib/3dmodels/C0402.step

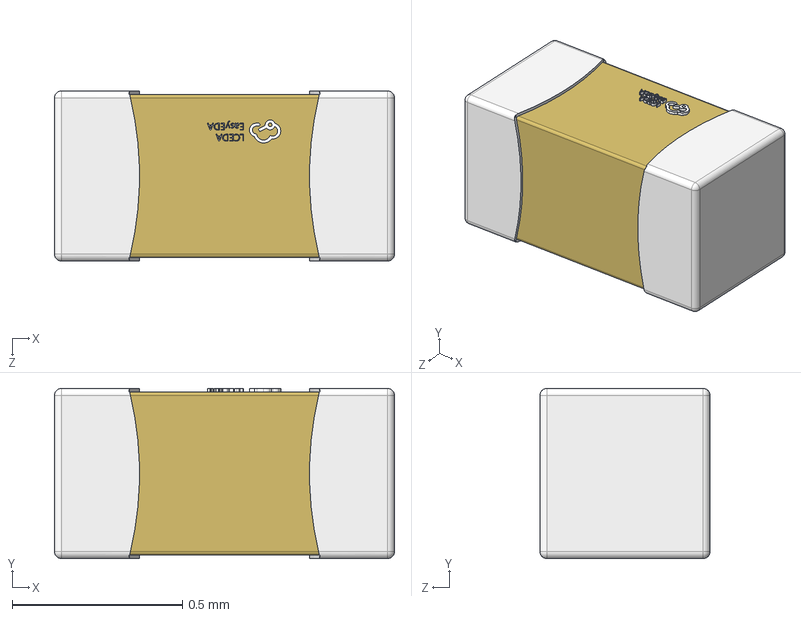
[picture p53: CAD file, 2025-06-26]
3dmodels/C0402.step
1.00 x 0.5 x 0.5 mm
