kerteszsasa/kicad_user_lib/3dmodels/SOD-523_L1.2-W0.8-LS1.6-BI.step

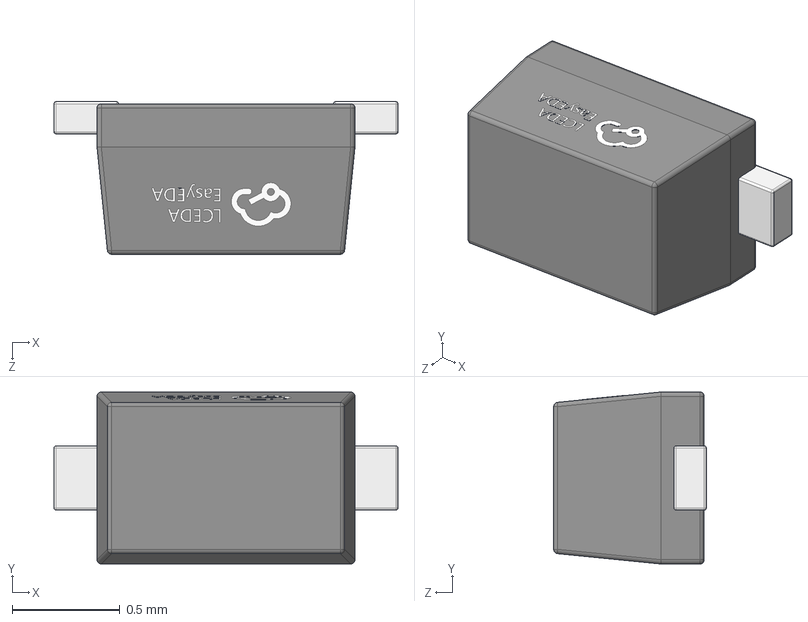
[picture p54: CAD file, 2025-06-25]
3dmodels/SOD-523_L1.2-W0.8-LS1.6-BI.step
1.60 x 0.8 x 0.71 mm
