kerteszsasa/kicad_user_lib/3dmodels/C0603.step

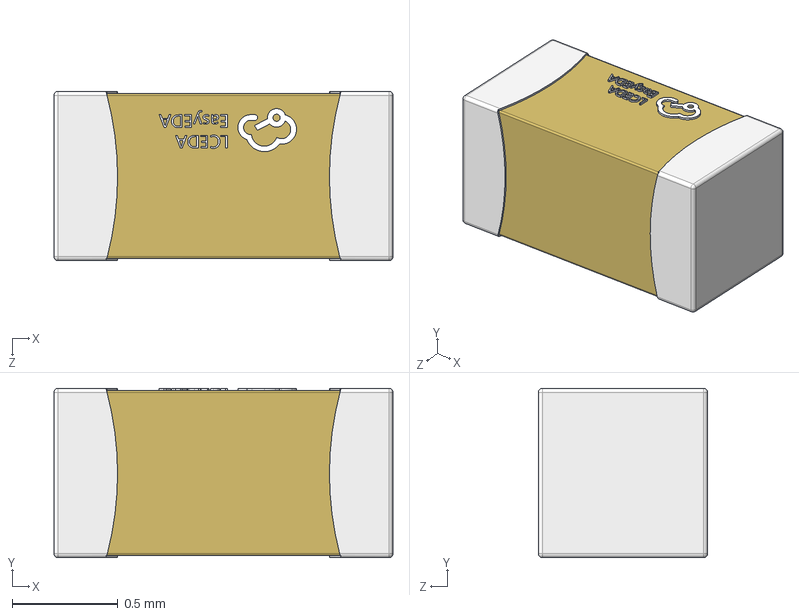
[picture p55: CAD file, 2025-06-24]
3dmodels/C0603.step
1.60 x 0.8 x 0.8 mm
