kerteszsasa/kicad_user_lib/3dmodels/R0603.step

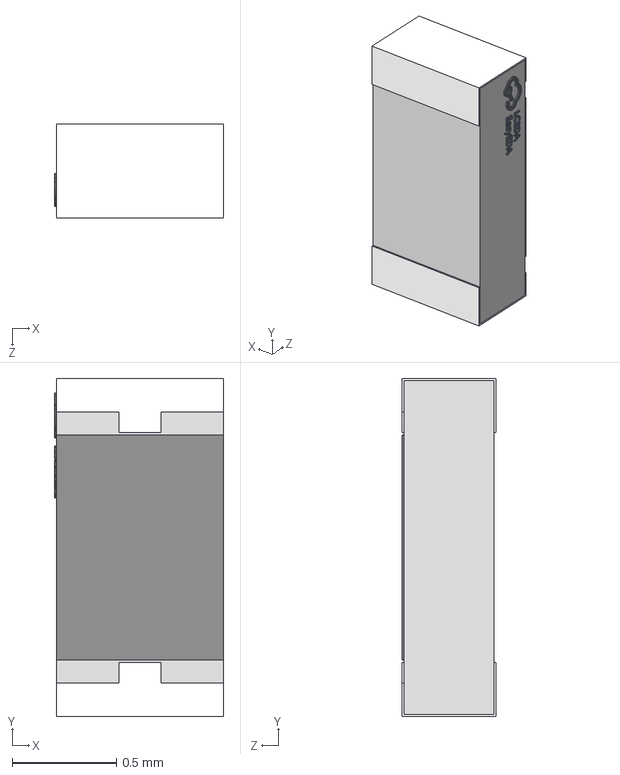
[picture p56: CAD file, 2025-06-24]
3dmodels/R0603.step
0.81 x 1.62 x 0.45 mm
