kerteszsasa/kicad_user_lib/3dmodels/CRYSTAL-SMD_4P-L3.2-W2.5-BL.step

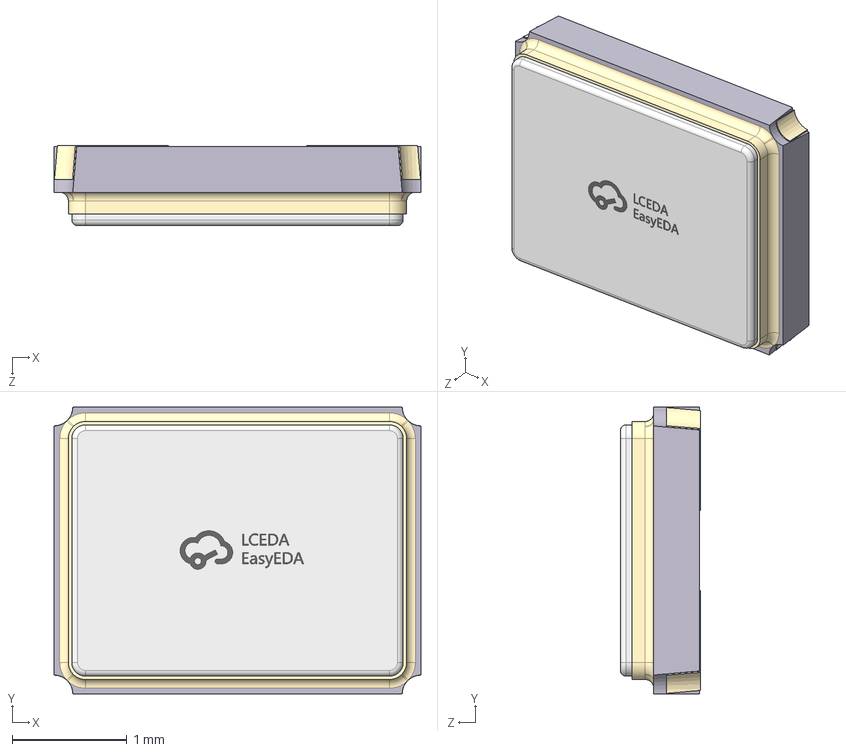
[picture p58: CAD file, 2025-06-24]
3dmodels/CRYSTAL-SMD_4P-L3.2-W2.5-BL.step
3.20 x 2.50 x 0.701 mm
