kerteszsasa/kicad_user_lib/3dmodels/SOIC-14_L8.6-W3.9-H1.8-LS6.0-P1.27.step

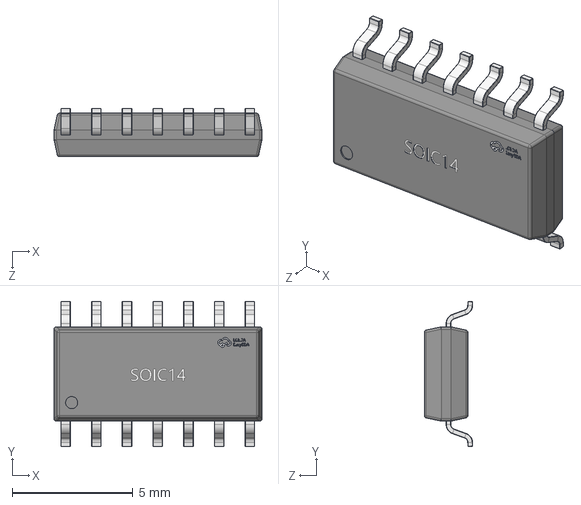
[picture p59: CAD file, 2025-06-24]
3dmodels/SOIC-14_L8.6-W3.9-H1.8-LS6.0-P1.27.step
8.60 x 6.01 x 2.00 mm
