kerteszsasa/kicad_user_lib/3dmodels/IPEX-SMD_BWIPX-1-001E.step

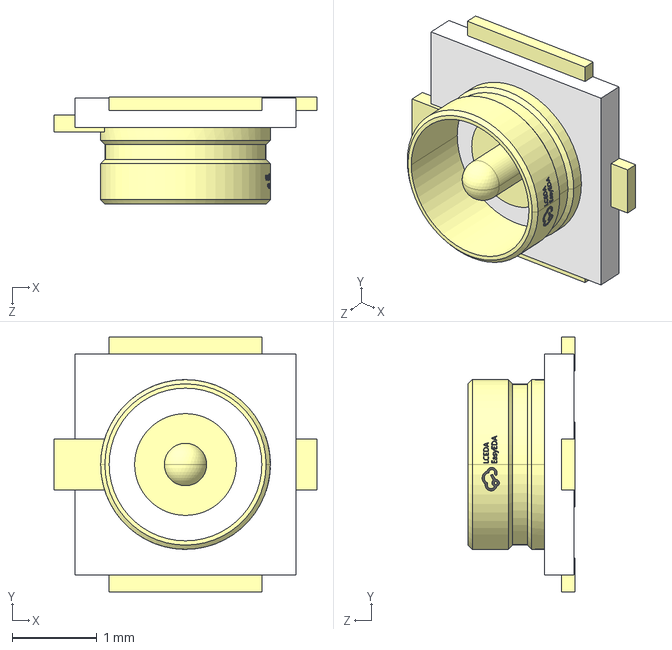
[picture p60: CAD file, 2025-06-24]
3dmodels/IPEX-SMD_BWIPX-1-001E.step
3.10 x 3.00 x 1.26 mm
