kerteszsasa/kicad_user_lib/3dmodels/TF-SMD_TF-02.step

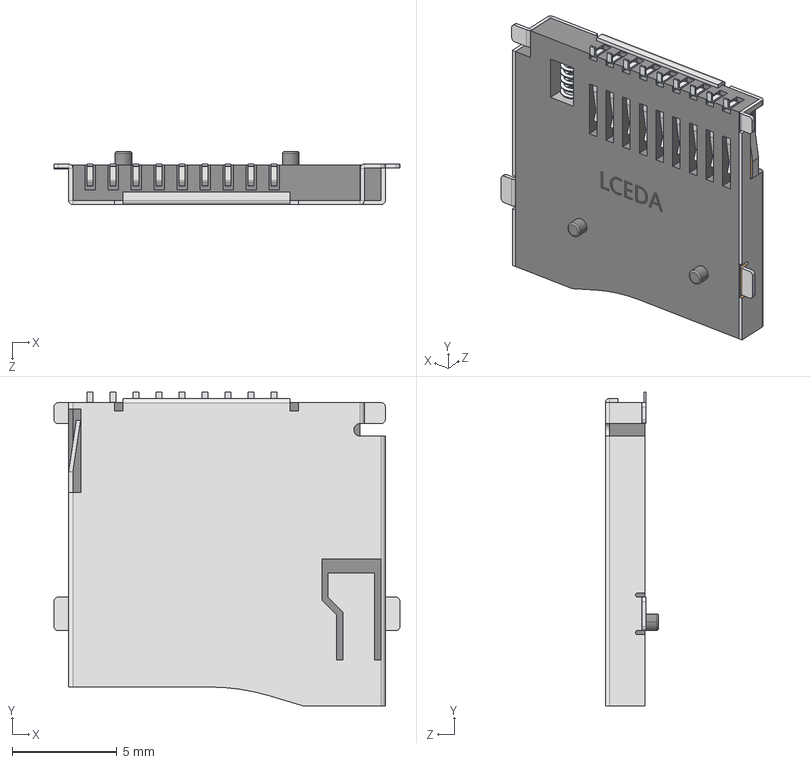
[picture p61: CAD file, 2025-06-24]
3dmodels/TF-SMD_TF-02.step
16.6 x 15.0 x 2.55 mm
