kerteszsasa/kicad_user_lib/3dmodels/LGA-14_L2.5-W3.0-H0.9-P0.50.step

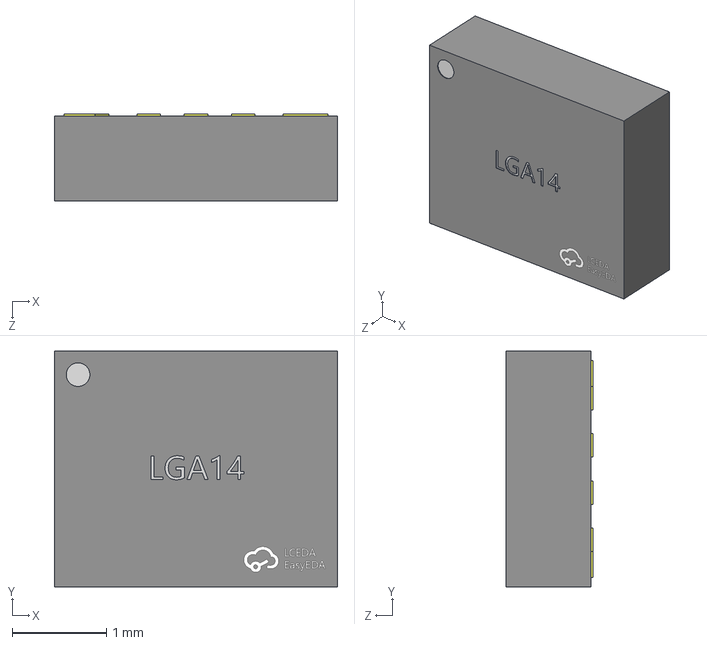
[picture p62: CAD file, 2025-06-24]
3dmodels/LGA-14_L2.5-W3.0-H0.9-P0.50.step
3.00 x 2.50 x 0.921 mm
