kerteszsasa/kicad_user_lib/3dmodels/OLED-TH_L38.0-W12.0_HS91L02W2C01.step

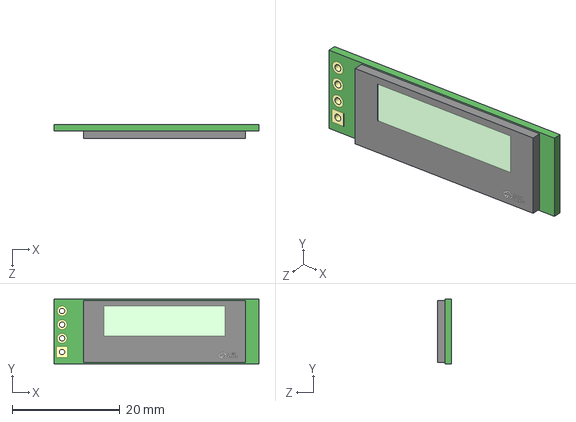
[picture p63: CAD file, 2025-06-24]
3dmodels/OLED-TH_L38.0-W12.0_HS91L02W2C01.step
38.0 x 12.0 x 2.62 mm
