kerteszsasa/kicad_user_lib/3dmodels/SW-SMD_8P-L7.0-W7.0-P1.40-LS7.4-TL.step

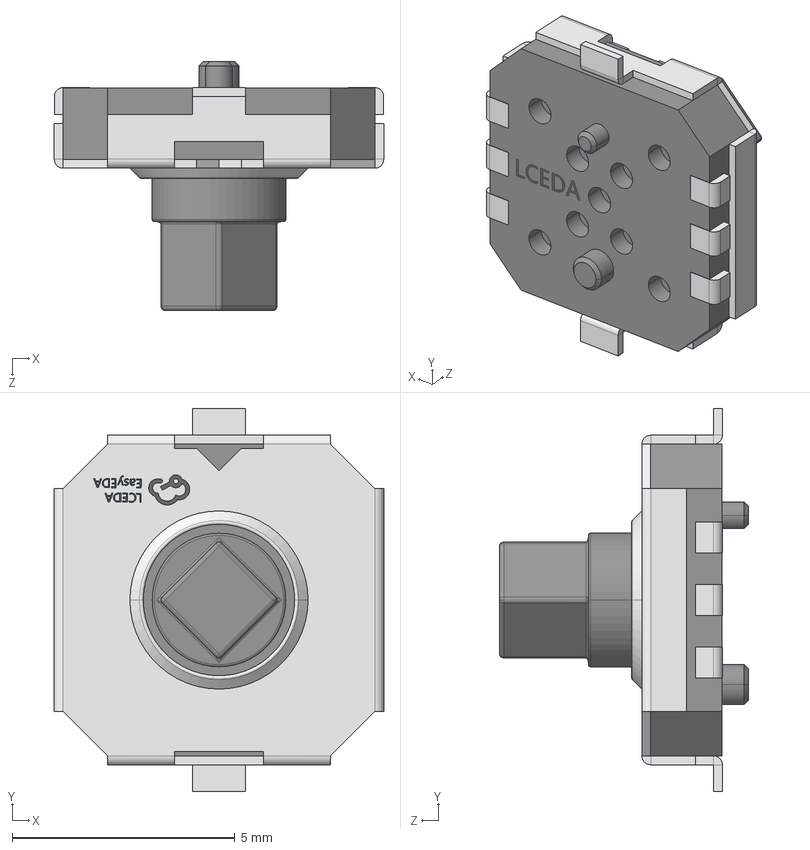
[picture p64: CAD file, 2025-06-23]
3dmodels/SW-SMD_8P-L7.0-W7.0-P1.40-LS7.4-TL.step
7.40 x 8.60 x 5.60 mm
