kerteszsasa/kicad_user_lib/3dmodels/CONN-TH_DB5.00-LI-2P-126.step

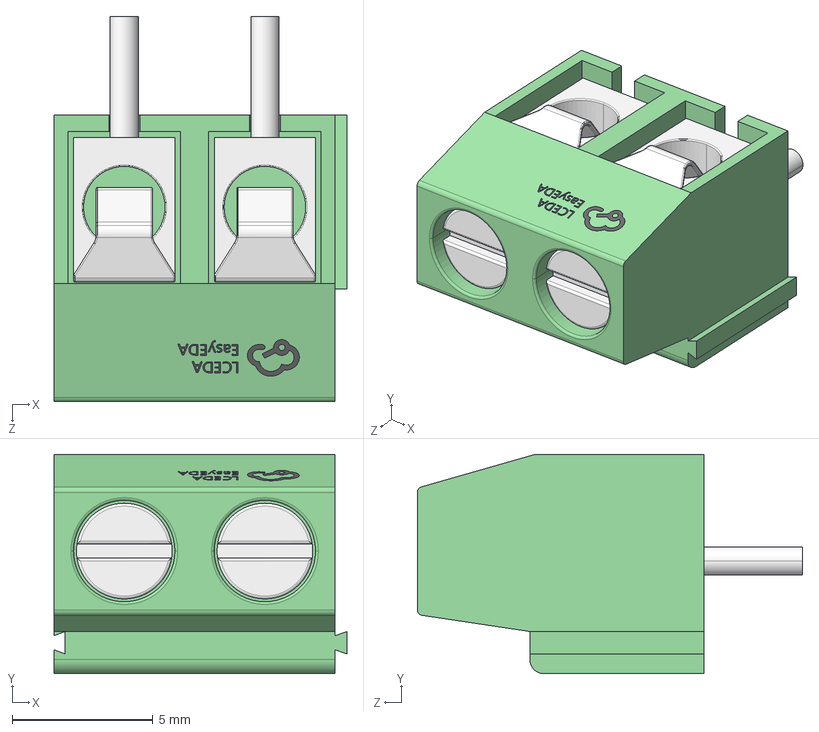
[picture p65: CAD file, 2025-06-23]
3dmodels/CONN-TH_DB5.00-LI-2P-126.step
10.4 x 7.80 x 13.7 mm
