kerteszsasa/kicad_user_lib/3dmodels/CONN-TH_WJ5.00-LI-3P-126.step

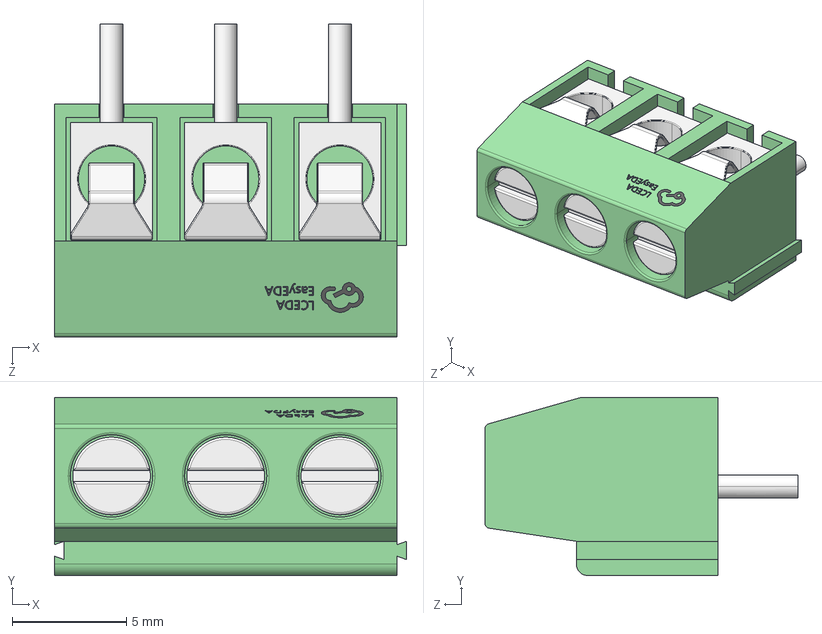
[picture p66: CAD file, 2025-06-23]
3dmodels/CONN-TH_WJ5.00-LI-3P-126.step
15.4 x 7.80 x 13.7 mm
