kerteszsasa/kicad_user_lib/3dmodels/LA 3366_bc.STEP

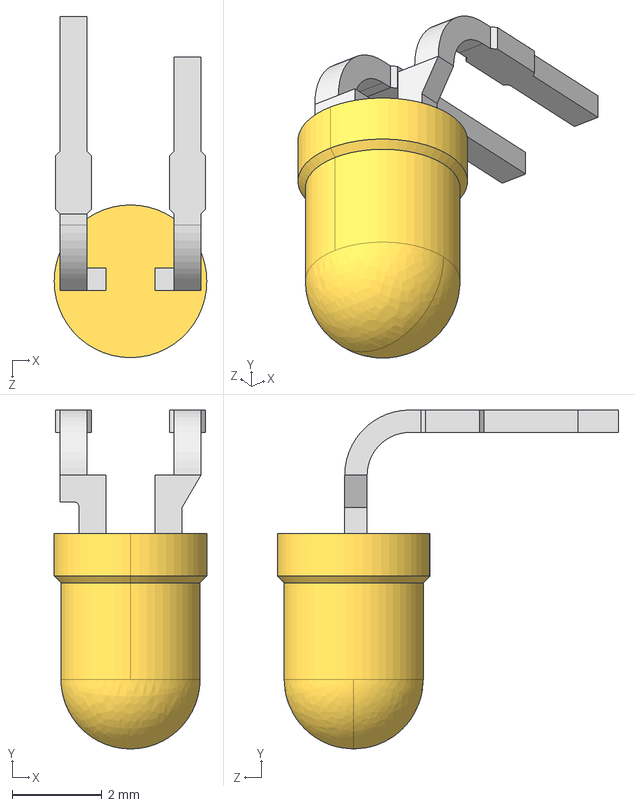
[picture p67: CAD file, 2025-06-11]
3dmodels/LA 3366_bc.STEP
3.40 x 7.55 x 7.60 mm
User Library-LA 3366_bc_LEAD K1_bend
User Library-LA 3366_bc_LEAD K2_bendcut
User Library-LA 3366_bc_LEAD K3_bend
User Library-LA 3366_bc_LEAD A2_bendcut
User Library-LA 3366_bc_LEAD A1_bend
User Library-LA 3366_bc_BODY_amber
