kerteszsasa/kicad_user_lib/3dmodels/Header_40P_box.stp

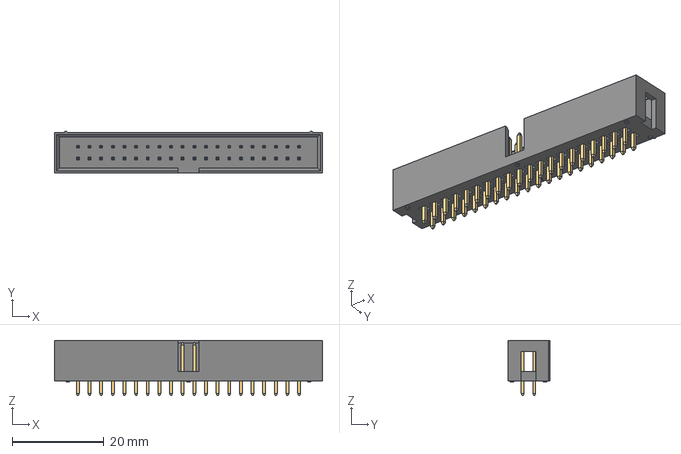
[picture p68: CAD file, 2025-06-11]
3dmodels/Header_40P_box.stp
58.5 x 9.10 x 12.1 mm
