kerteszsasa/kicad_user_lib/3dmodels/LED_5mm_clear.STEP

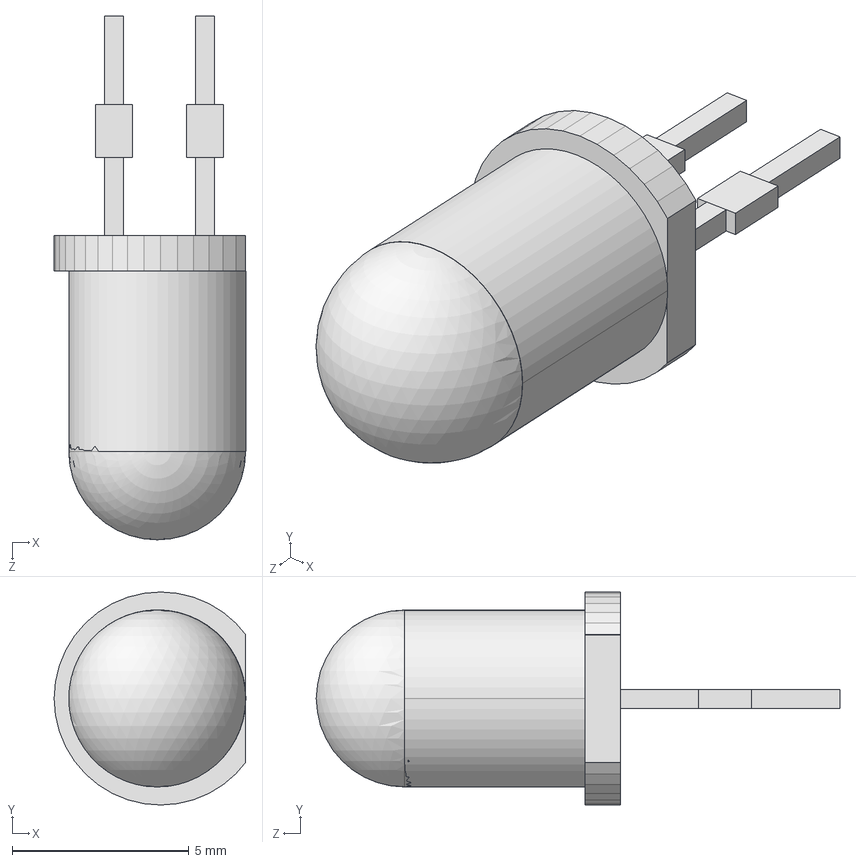
[picture p69: CAD file, 2025-06-11]
3dmodels/LED_5mm_clear.STEP
5.42 x 6.02 x 14.8 mm
SW3dPS-LEDd5C_Extruded3 x 2
SW3dPS-LEDd5C_Extruded x 2
SW3dPS-LEDd5C_Extruded1
SW3dPS-LEDd5C_Extruded4
SW3dPS-LEDd5C_Sphere
SW3dPS-LEDd5C_Extruded2
SW3dPS-LEDd5C_Cylinder
