kerteszsasa/kicad_user_lib/3dmodels/Digital_TSSOP14.step

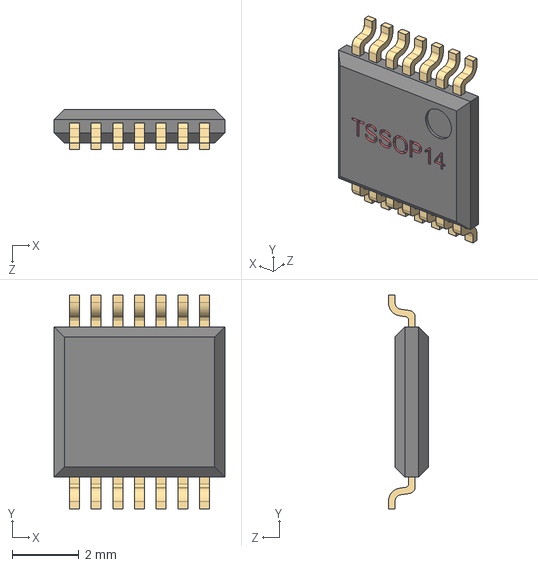
[picture p70: CAD file, 2025-06-11]
3dmodels/Digital_TSSOP14.step
5.10 x 6.40 x 1.20 mm
