kerteszsasa/kicad_user_lib/3dmodels/User Library-LQFP100-3.STEP

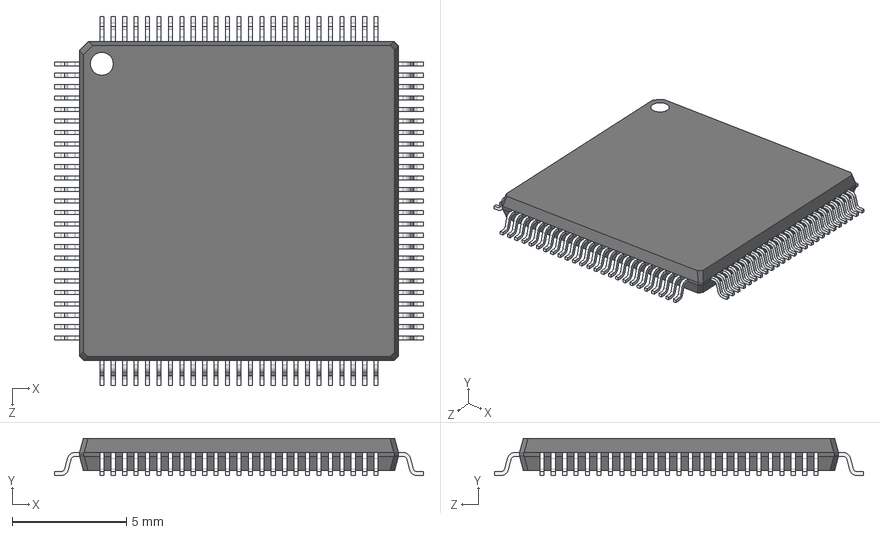
[picture p71: CAD file, 2025-06-11]
3dmodels/User Library-LQFP100-3.STEP
16.1 x 1.63 x 16.1 mm
User Library-LQFP100-3_case
User Library-LQFP100-3_pin x 100
User Library-LQFP100-3_circle
