kerteszsasa/kicad_user_lib/3dmodels/DIode-SOD-323.step

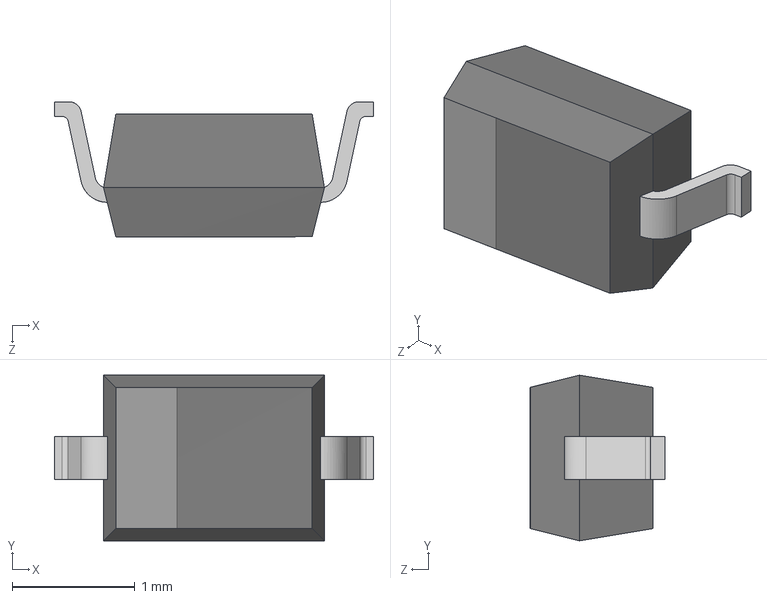
[picture p72: CAD file, 2025-06-11]
3dmodels/DIode-SOD-323.step
2.60 x 1.35 x 1.10 mm
