kerteszsasa/kicad_user_lib/3dmodels/SWITCH_TACT DIP 6X6.step

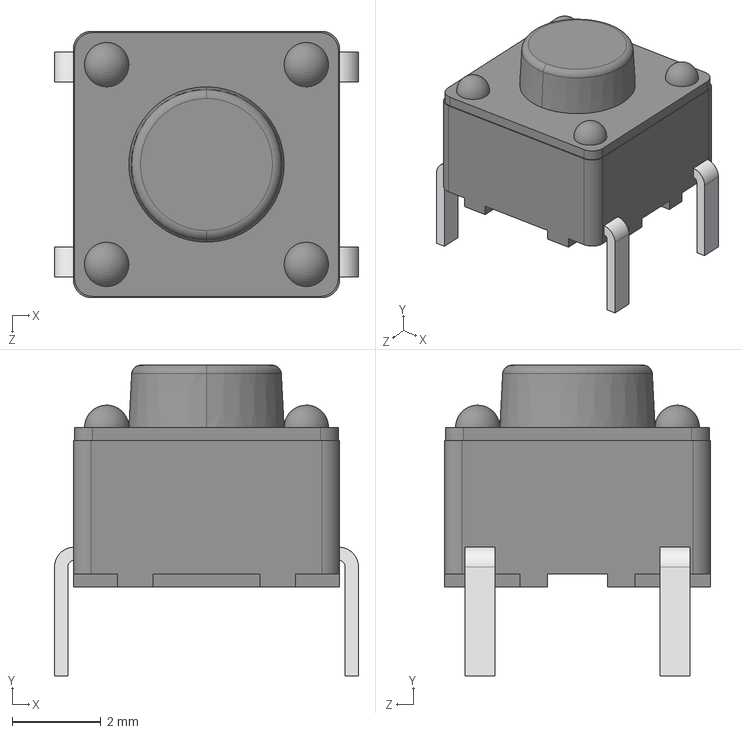
[picture p73: CAD file, 2025-06-11]
3dmodels/SWITCH_TACT DIP 6X6.step
6.85 x 7.00 x 6.00 mm
