kerteszsasa/kicad_user_lib/3dmodels/CAP_TANTAL-CaseB_3528-21.step

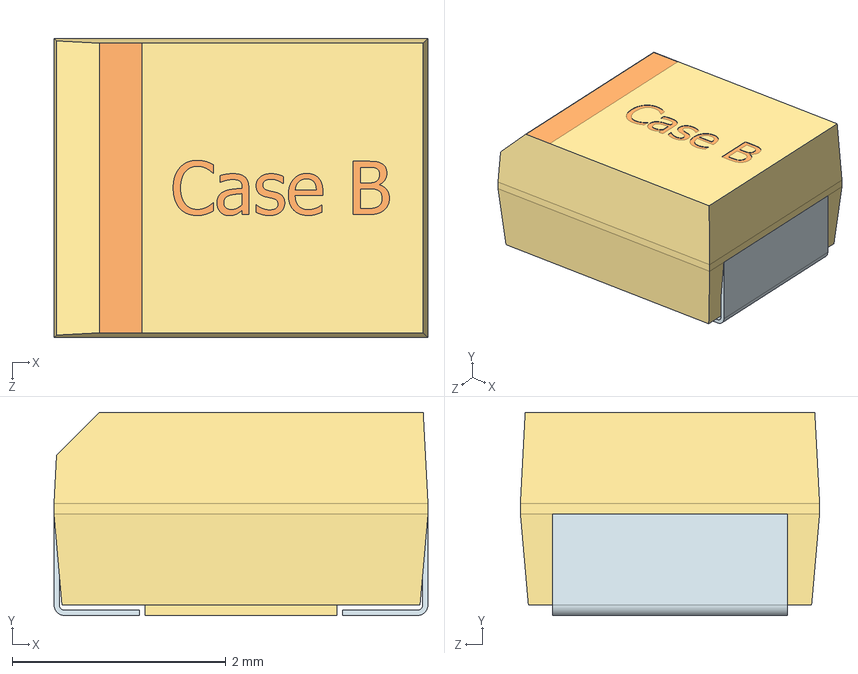
[picture p74: CAD file, 2025-06-11]
3dmodels/CAP_TANTAL-CaseB_3528-21.step
3.50 x 1.90 x 2.80 mm
