kerteszsasa/kicad_user_lib/3dmodels/MBS.step

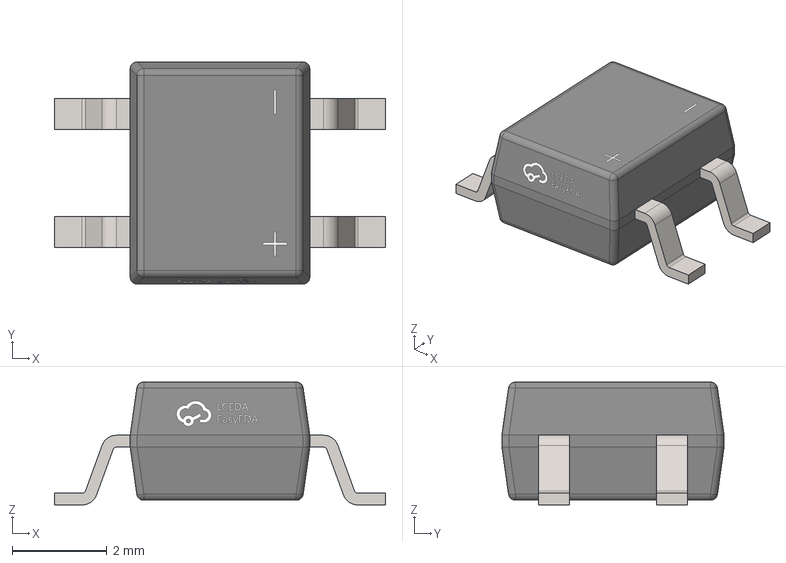
[picture p75: CAD file, 2025-06-11]
3dmodels/MBS.step
6.99 x 4.70 x 2.60 mm
