kerteszsasa/kicad_user_lib/3dmodels/CON_NC3FAH1.stp

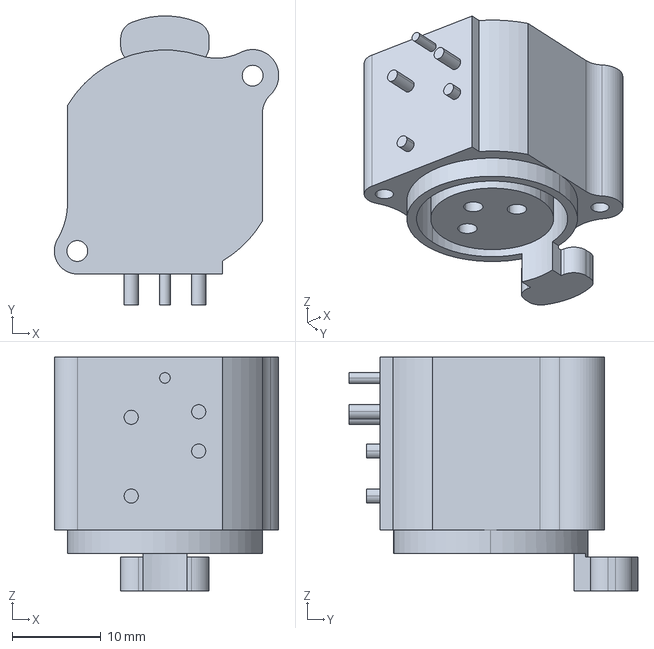
[picture p76: CAD file, 2025-06-11]
3dmodels/CON_NC3FAH1.stp
25.3 x 32.6 x 26.4 mm
