kerteszsasa/kicad_user_lib/3dmodels/Header_F_2.54mm_1x2.step

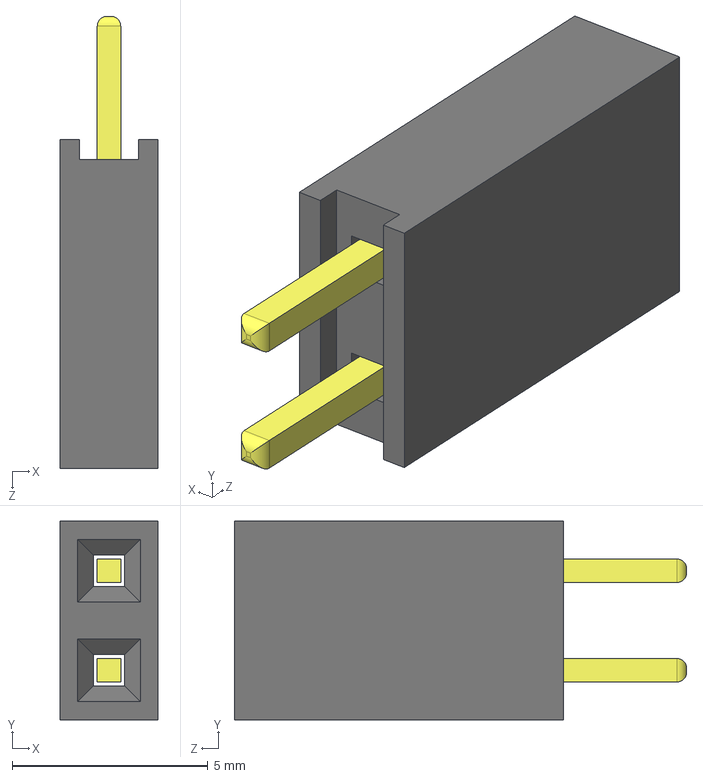
[picture p77: CAD file, 2025-06-11]
3dmodels/Header_F_2.54mm_1x2.step
2.50 x 5.08 x 11.6 mm
