kerteszsasa/kicad_user_lib/3dmodels/Diode - MELF DO-213AB.step

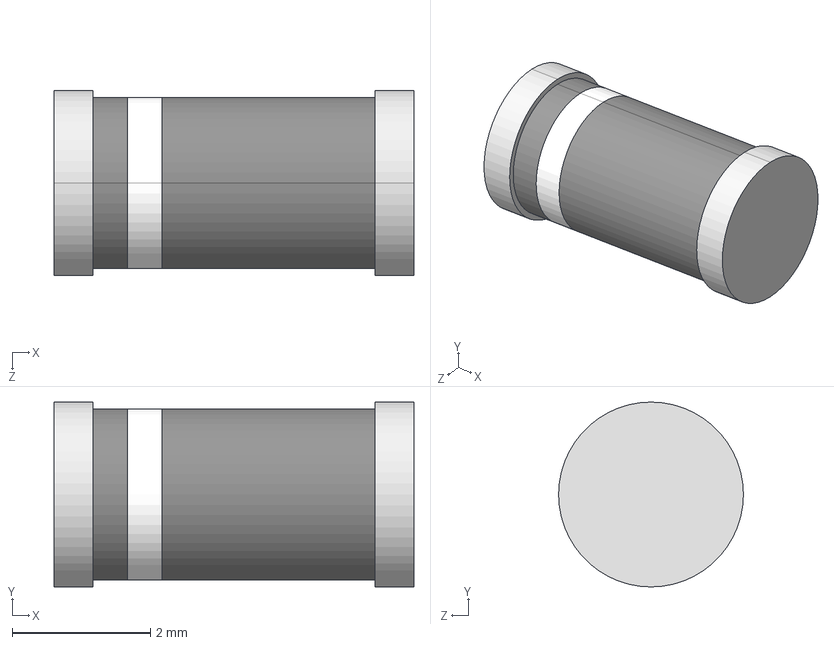
[picture p78: CAD file, 2025-06-11]
3dmodels/Diode - MELF DO-213AB.step
5.20 x 2.67 x 2.67 mm
