kerteszsasa/kicad_user_lib/3dmodels/MSOP-8.STEP

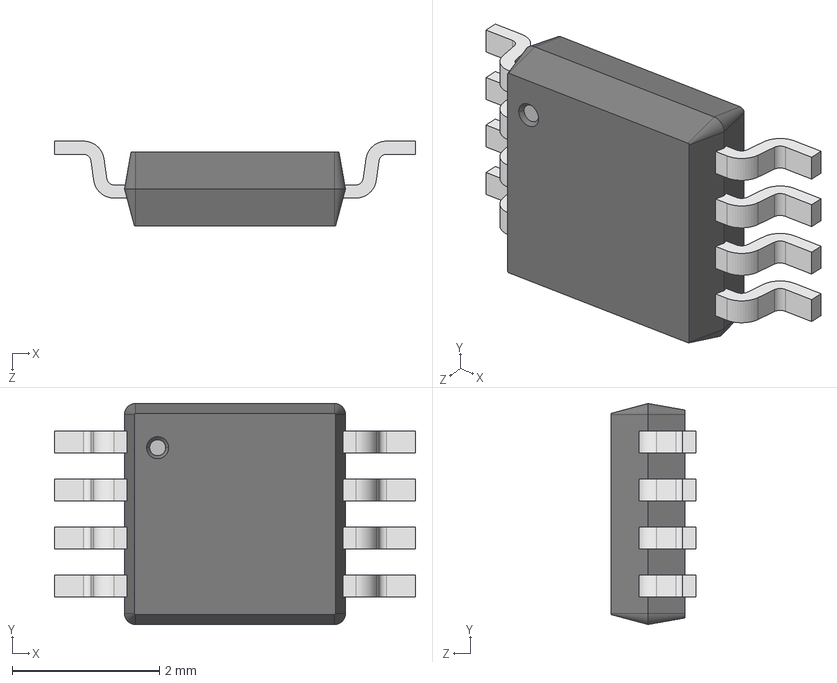
[picture p79: CAD file, 2025-06-11]
3dmodels/MSOP-8.STEP
4.90 x 3.00 x 1.15 mm
