kerteszsasa/kicad_user_lib/3dmodels/RESISTOR_3W.step

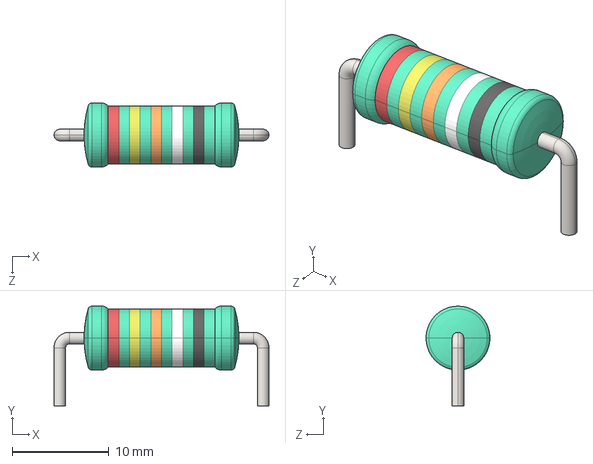
[picture p80: CAD file, 2025-06-11]
3dmodels/RESISTOR_3W.step
22.2 x 10.3 x 6.60 mm
