kerteszsasa/kicad_user_lib/3dmodels/RES_2512.step

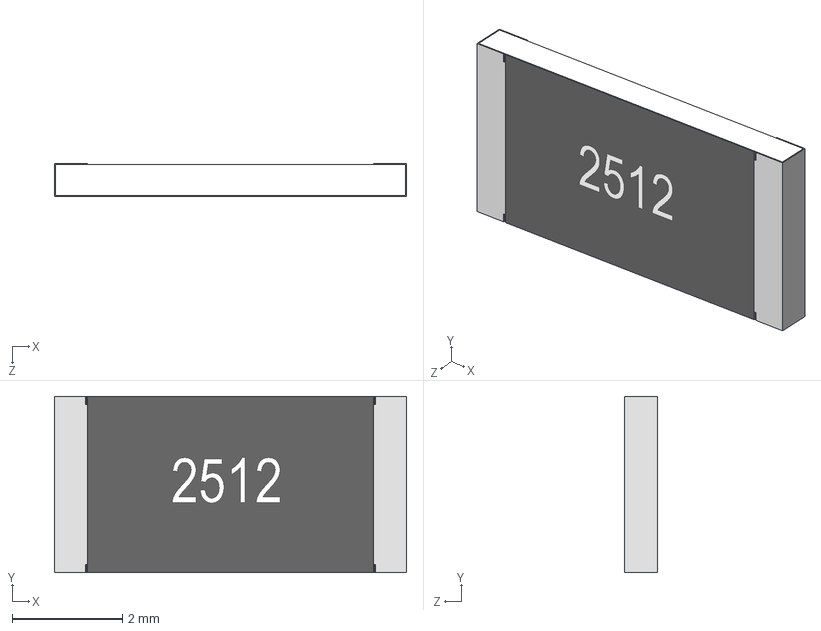
[picture p81: CAD file, 2025-06-11]
3dmodels/RES_2512.step
6.40 x 3.20 x 0.6 mm
