kerteszsasa/kicad_user_lib/3dmodels/Cristal-3225.step

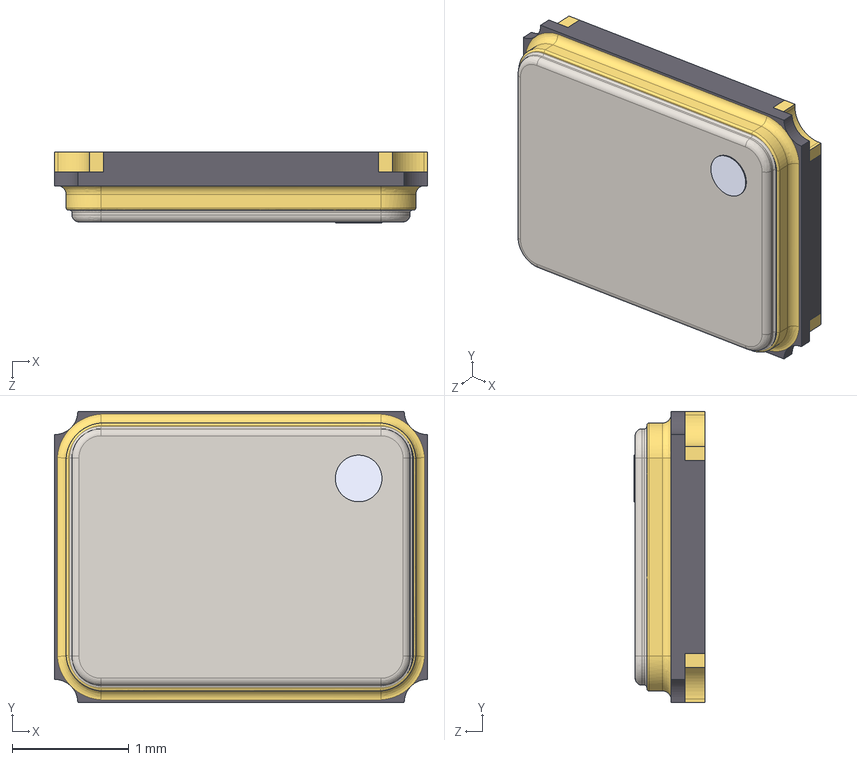
[picture p82: CAD file, 2025-06-11]
3dmodels/Cristal-3225.step
3.20 x 2.50 x 0.61 mm
