kerteszsasa/kicad_user_lib/3dmodels/molex_5050060812.stp

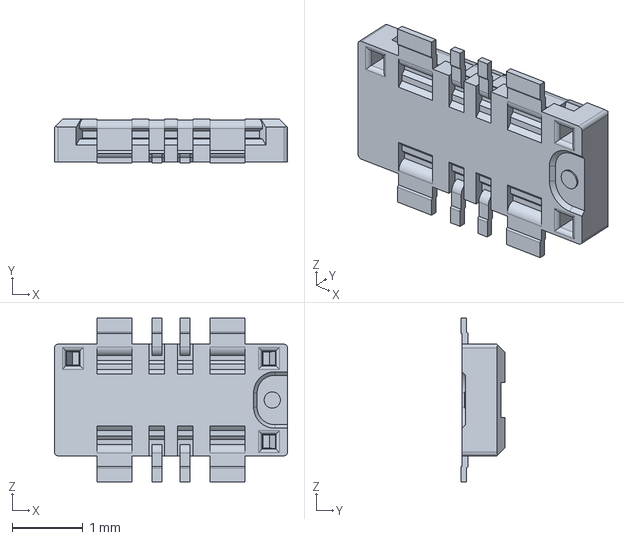
[picture p83: CAD file, 2025-06-11]
3dmodels/molex_5050060812.stp
3.30 x 0.63 x 2.32 mm
