kerteszsasa/kicad_user_lib/3dmodels/Capacitor_supercapac_5F_2V5.step

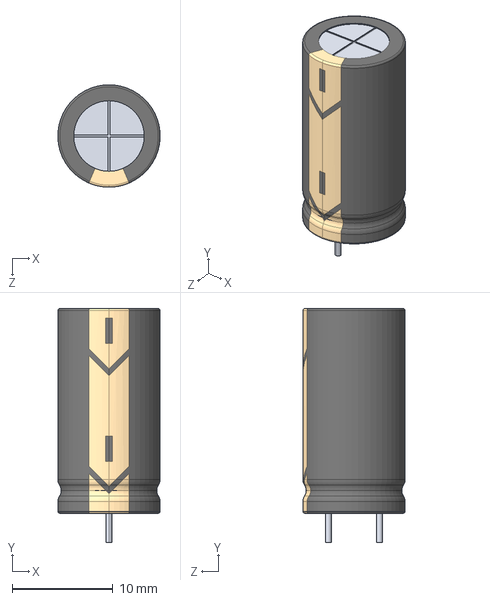
[picture p84: CAD file, 2025-06-11]
3dmodels/Capacitor_supercapac_5F_2V5.step
10.1 x 23.2 x 10.2 mm
