kerteszsasa/kicad_user_lib/3dmodels/Connector_SIM5060-6-0-26-01-A.STEP

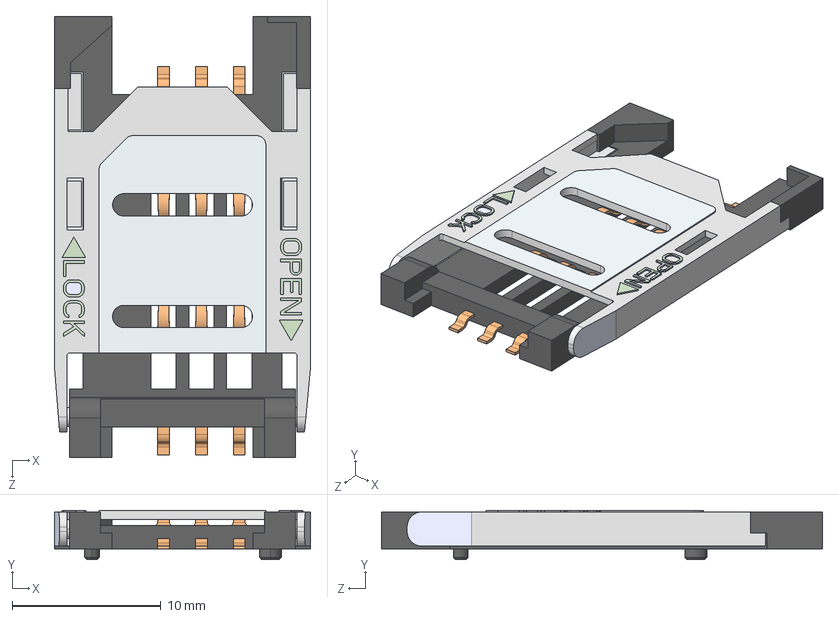
[picture p85: CAD file, 2025-06-11]
3dmodels/Connector_SIM5060-6-0-26-01-A.STEP
17.2 x 3.30 x 29.6 mm
User Library-SIM5060-6-0-26-01-A_6-base-with-1
User Library-SIM5060-6-0-26-01-A_C703COVER-1
User Library-SIM5060-6-0-26-01-A_C703DATA-1
User Library-SIM5060-6-0-26-01-A_C703DATA_1-1
User Library-SIM5060-6-0-26-01-A_C703DATA_2-1
User Library-SIM5060-6-0-26-01-A_C703DATA_3-1
User Library-SIM5060-6-0-26-01-A_C703DATA_4-1
User Library-SIM5060-6-0-26-01-A_C703DATA_5-1
