kerteszsasa/kicad_user_lib/3dmodels/Connector_stereo_jack.stp

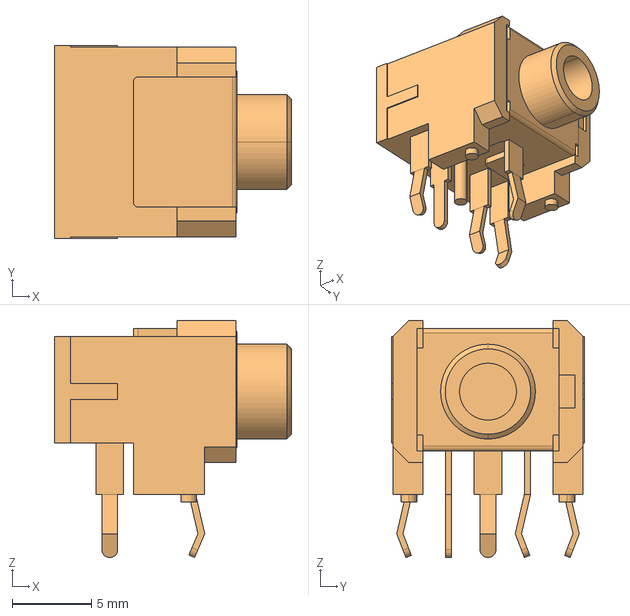
[picture p86: CAD file, 2025-06-11]
3dmodels/Connector_stereo_jack.stp
15.0 x 12.2 x 15.0 mm
