kerteszsasa/kicad_user_lib/3dmodels/SMA PCB Bulkhead.step

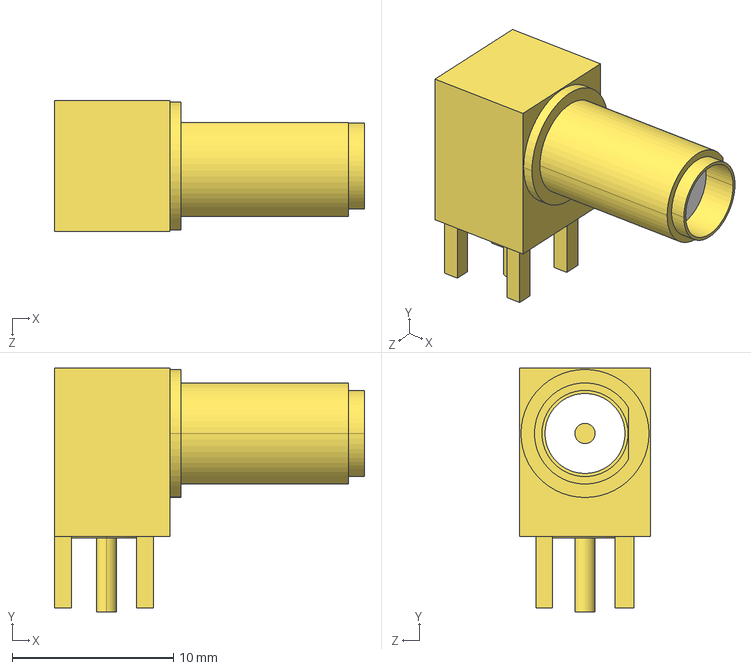
[picture p87: CAD file, 2025-06-11]
3dmodels/SMA PCB Bulkhead.step
19.2 x 15.1 x 8.11 mm
