kerteszsasa/kicad_user_lib/3dmodels/Capacitor_Wima_RM31,5x11x21.step

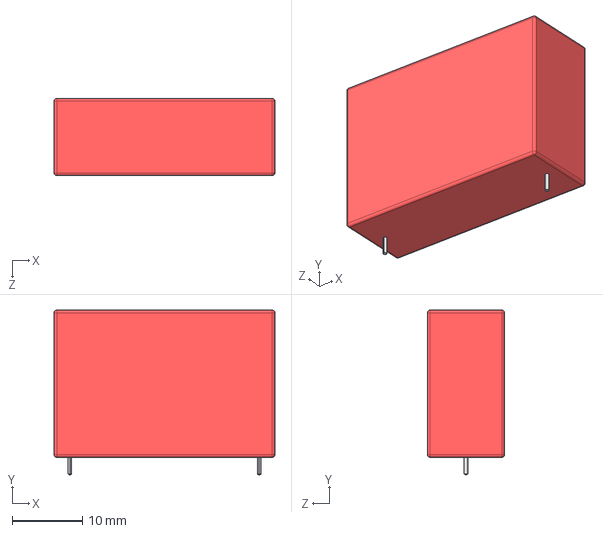
[picture p88: CAD file, 2025-06-11]
3dmodels/Capacitor_Wima_RM31,5x11x21.step
31.5 x 23.5 x 11.0 mm
