kerteszsasa/kicad_user_lib/3dmodels/Quartz ABRACON ABM2.STEP

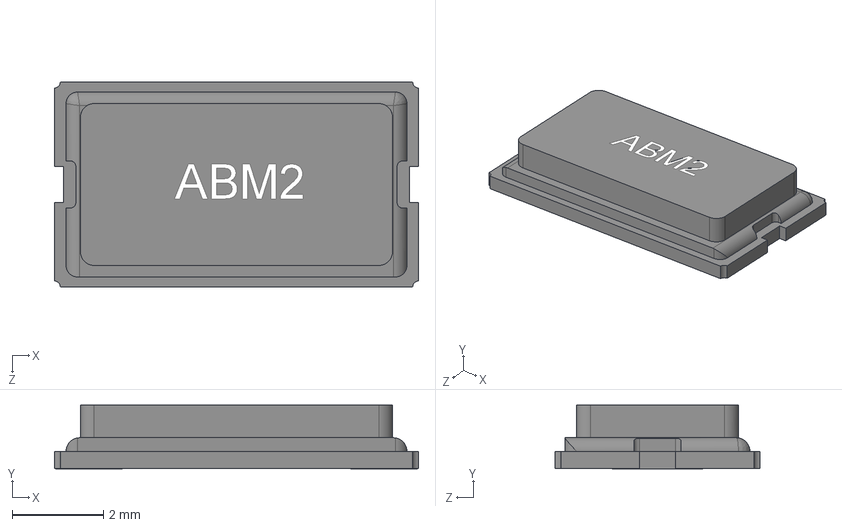
[picture p89: CAD file, 2025-06-11]
3dmodels/Quartz ABRACON ABM2.STEP
8.00 x 1.40 x 4.50 mm
