kerteszsasa/kicad_user_lib/3dmodels/DIP-8.step

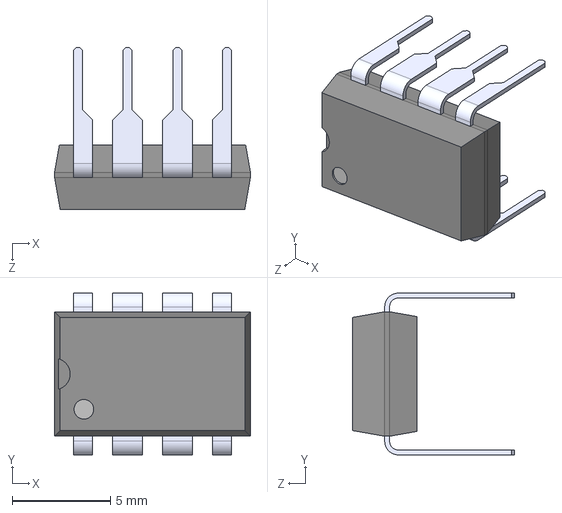
[picture p90: CAD file, 2025-06-11]
3dmodels/DIP-8.step
10.0 x 8.26 x 8.28 mm
