kerteszsasa/kicad_user_lib/3dmodels/Molex_sim_socket_473883001.stp

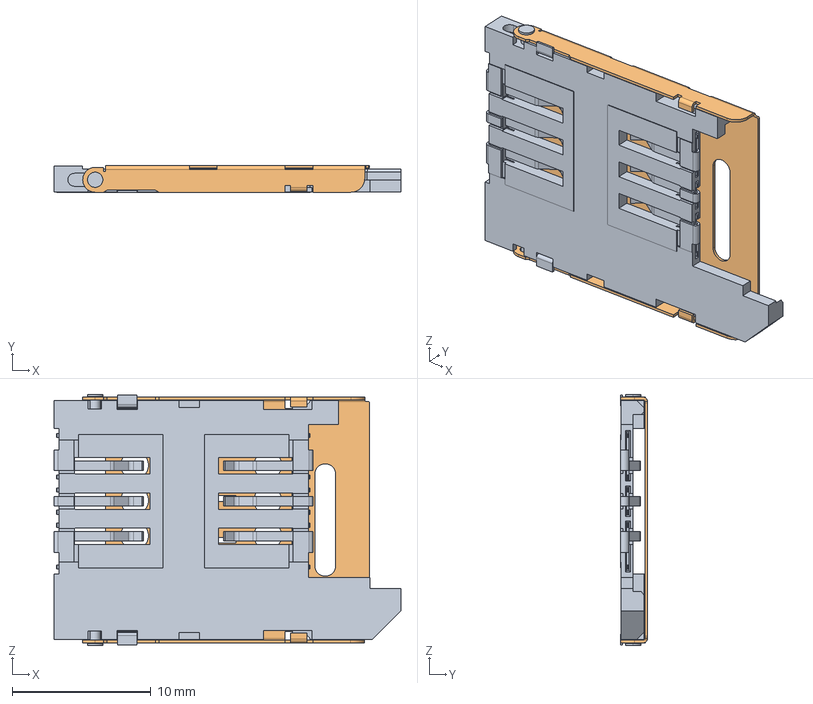
[picture p91: CAD file, 2025-06-11]
3dmodels/Molex_sim_socket_473883001.stp
25.0 x 1.95 x 18.1 mm
