kerteszsasa/kicad_user_lib/3dmodels/Connector_telefon_molex_85502-5005.stp

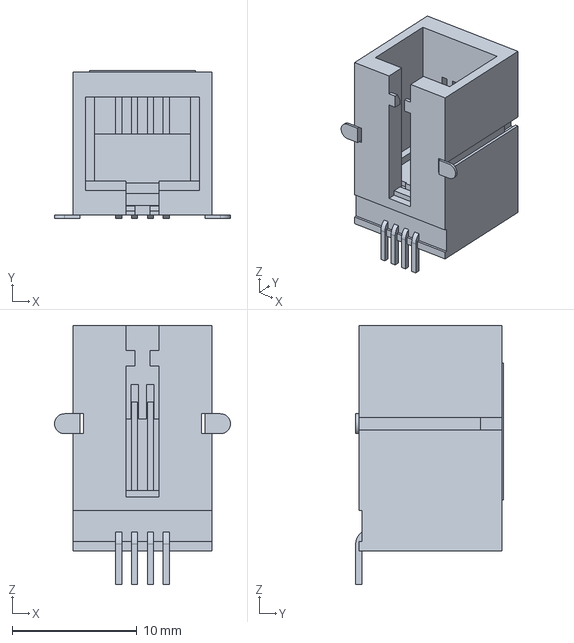
[picture p92: CAD file, 2025-06-11]
3dmodels/Connector_telefon_molex_85502-5005.stp
14.1 x 11.8 x 20.8 mm
