kerteszsasa/kicad_user_lib/3dmodels/CAP_supercap_Ctype.step

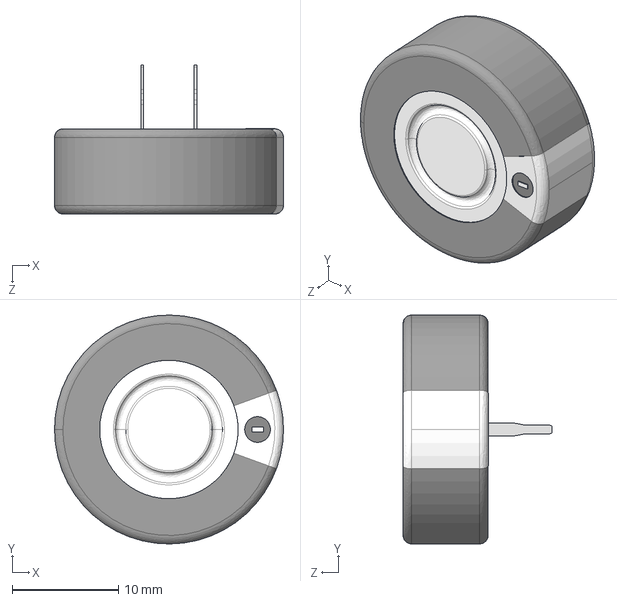
[picture p93: CAD file, 2025-06-11]
3dmodels/CAP_supercap_Ctype.step
21.5 x 21.5 x 14.0 mm
