kerteszsasa/kicad_user_lib/3dmodels/Fuse 1812.step

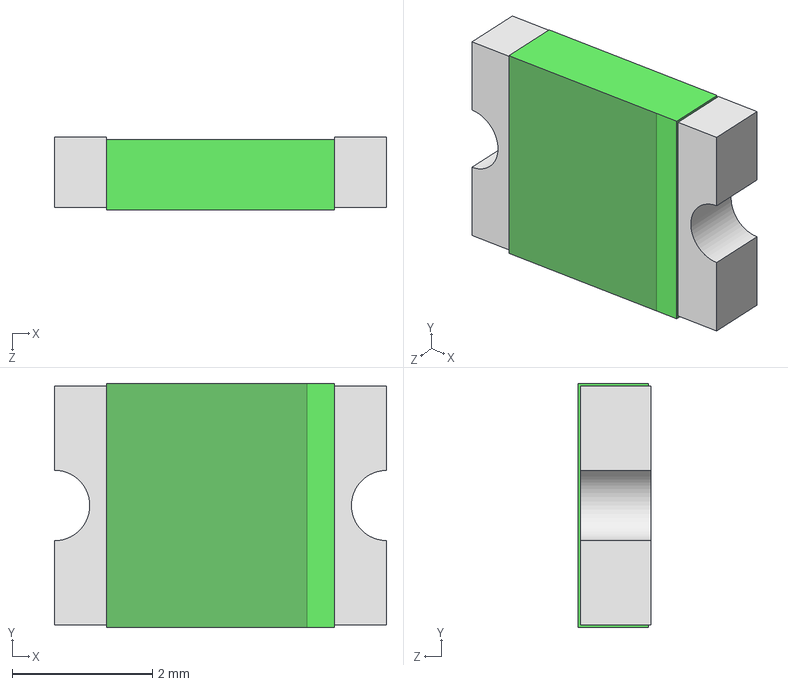
[picture p94: CAD file, 2025-06-11]
3dmodels/Fuse 1812.step
4.74 x 3.48 x 1.04 mm
