kerteszsasa/kicad_user_lib/3dmodels/Capacitor electro 5x11x2mm.step

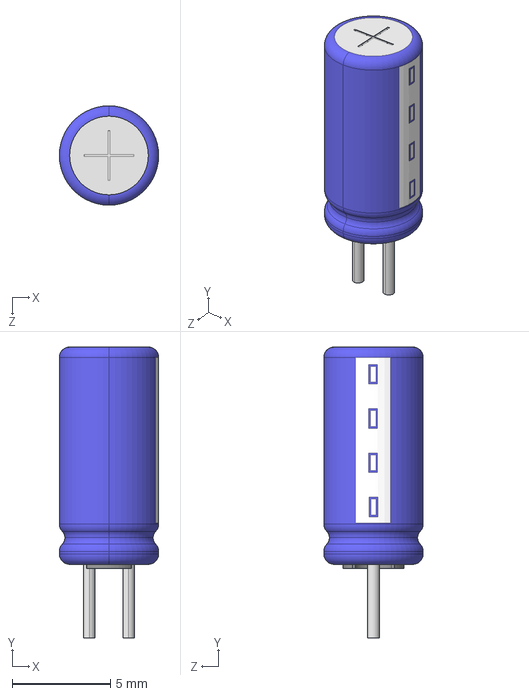
[picture p95: CAD file, 2025-06-11]
3dmodels/Capacitor electro 5x11x2mm.step
5.05 x 14.8 x 5.05 mm
