kerteszsasa/kicad_user_lib/3dmodels/RGB LED SMD 5x5mm.step

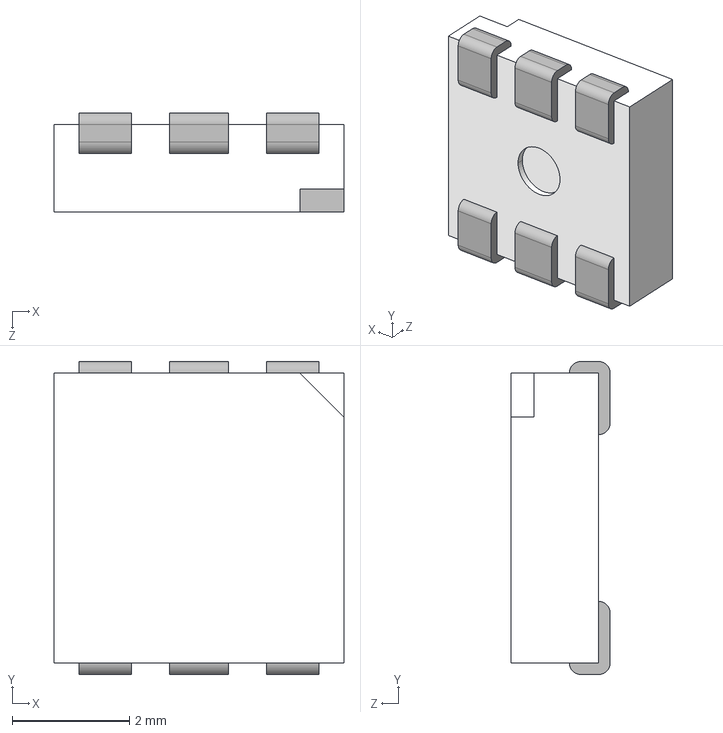
[picture p96: CAD file, 2025-06-11]
3dmodels/RGB LED SMD 5x5mm.step
4.95 x 5.35 x 1.70 mm
