kerteszsasa/kicad_user_lib/3dmodels/RES_Trimpot Vertical.step

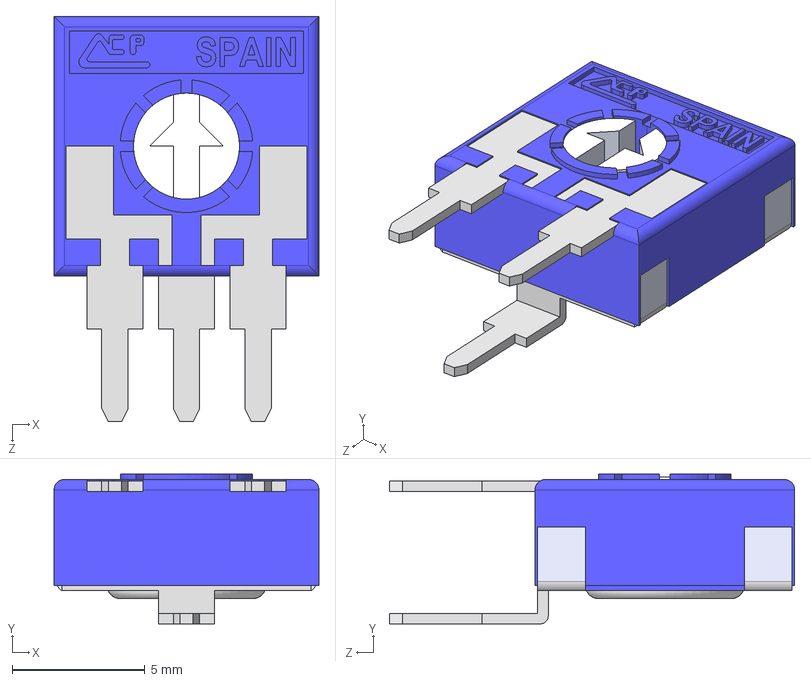
[picture p97: CAD file, 2025-06-11]
3dmodels/RES_Trimpot Vertical.step
10.0 x 5.65 x 15.3 mm
