kerteszsasa/kicad_user_lib/3dmodels/Connector-Cheramic-GPS-YDRA-A25-1575.step

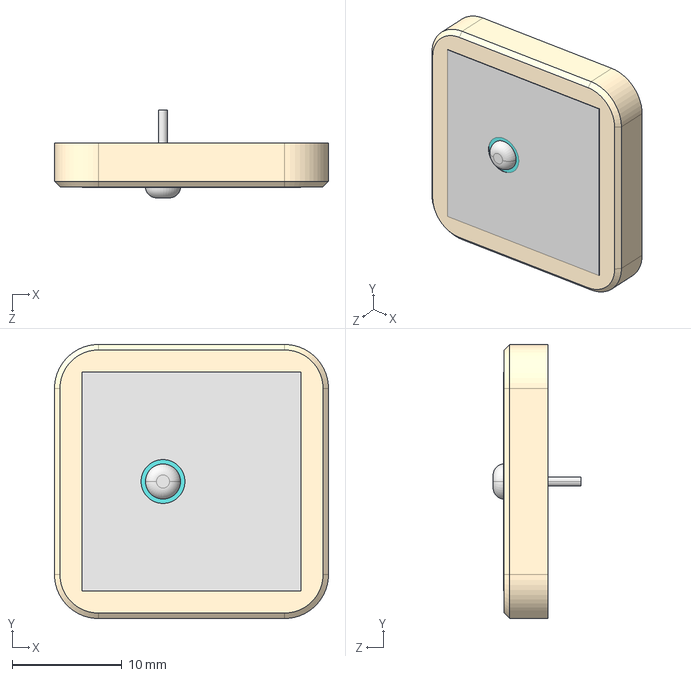
[picture p98: CAD file, 2025-06-11]
3dmodels/Connector-Cheramic-GPS-YDRA-A25-1575.step
25.0 x 25.0 x 8.00 mm
