kerteszsasa/kicad_user_lib/3dmodels/Resistor, 5W.STEP

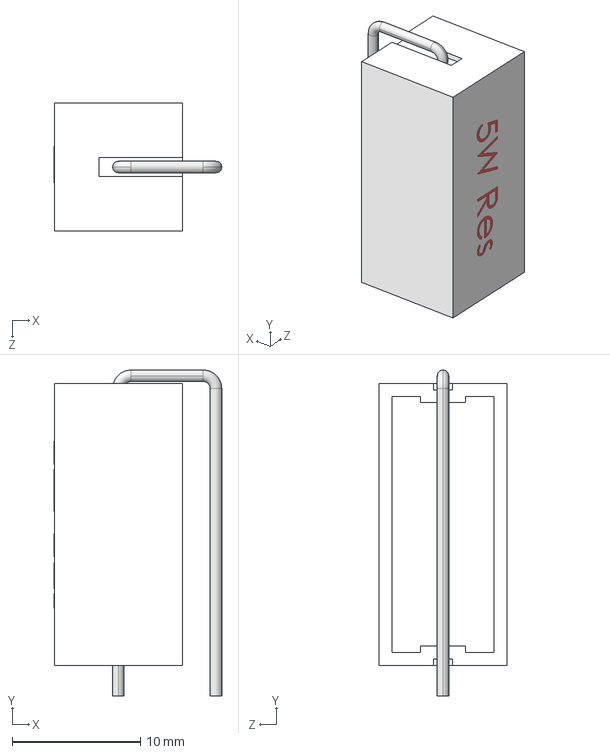
[picture p99: CAD file, 2025-06-11]
3dmodels/Resistor, 5W.STEP
13.1 x 25.4 x 10.0 mm
