kerteszsasa/kicad_user_lib/3dmodels/Capacitor ceramico 0_2in pitch.STEP

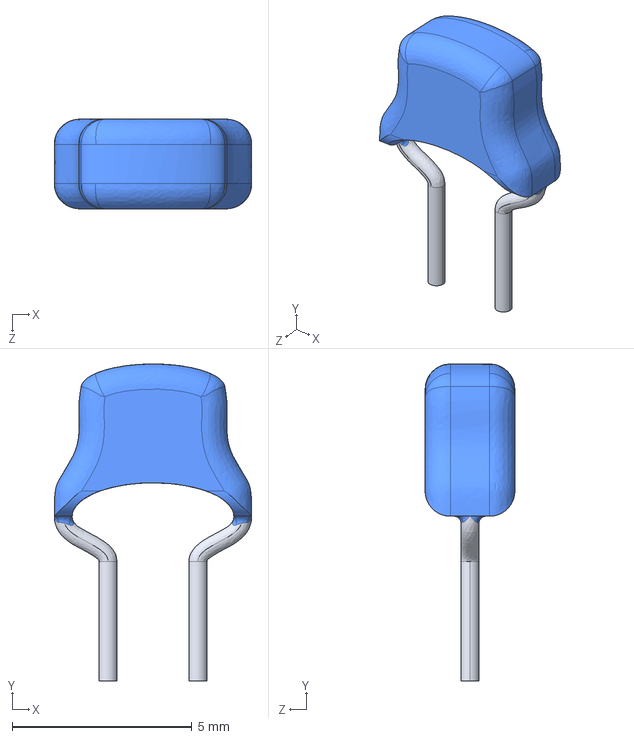
[picture p100: CAD file, 2025-06-11]
3dmodels/Capacitor ceramico 0_2in pitch.STEP
5.50 x 8.83 x 2.50 mm
