kerteszsasa/kicad_user_lib/3dmodels/OSC_DIP-8.step

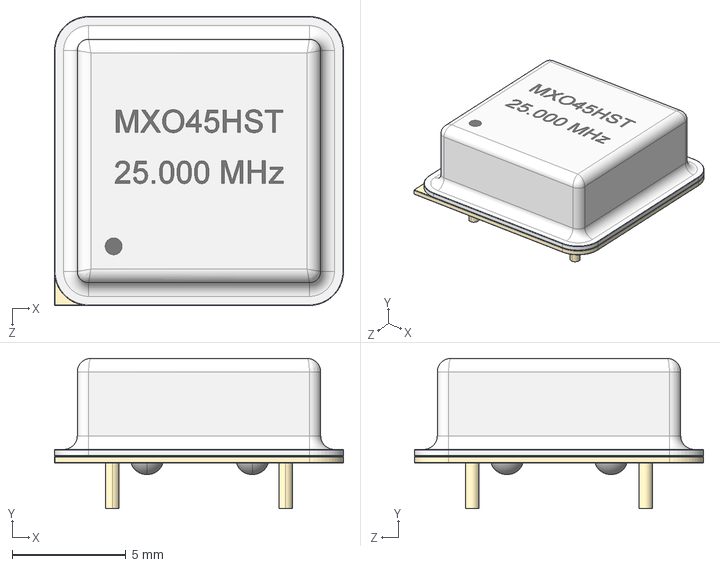
[picture p101: CAD file, 2025-06-11]
3dmodels/OSC_DIP-8.step
12.7 x 6.60 x 12.7 mm
