kerteszsasa/kicad_user_lib/3dmodels/TH_Inductor 10x12 (200 mils).STEP

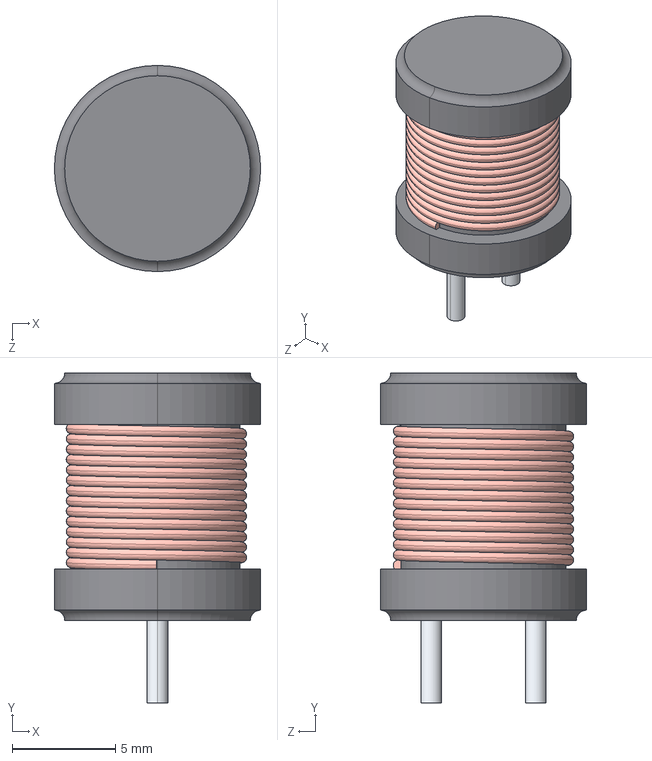
[picture p102: CAD file, 2025-06-11]
3dmodels/TH_Inductor 10x12 (200 mils).STEP
10.0 x 16.0 x 10.0 mm
User Library-Inductor 10x12 (200 mils)_Inductor 10x12 (200 mils) Bobina_Valor predeterminado
User Library-Inductor 10x12 (200 mils)_Inductor 10x12 (200 mils) Ferrite_Valor predeterminado
