kerteszsasa/kicad_user_lib/3dmodels/0402 SMD Resistor.step

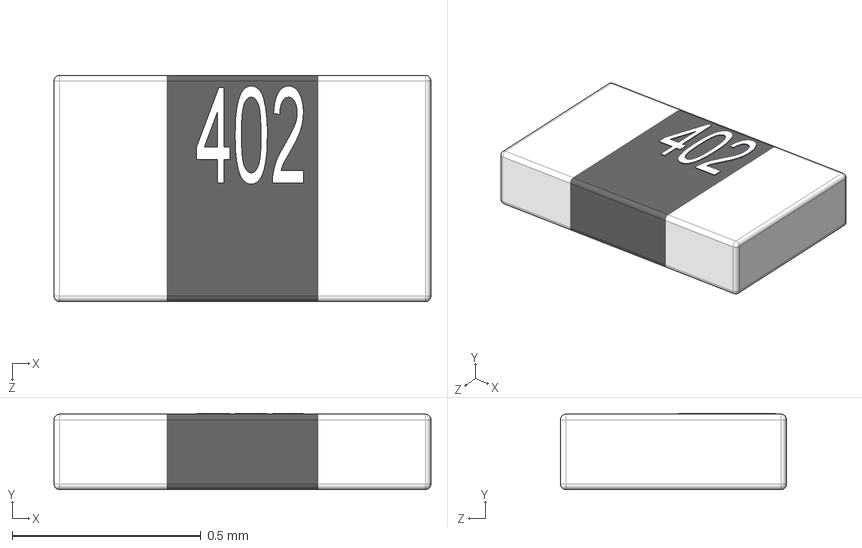
[picture p103: CAD file, 2025-06-11]
3dmodels/0402 SMD Resistor.step
1.00 x 0.202 x 0.6 mm
