kerteszsasa/kicad_user_lib/3dmodels/Cap alu elko SMD 10x10,5.step

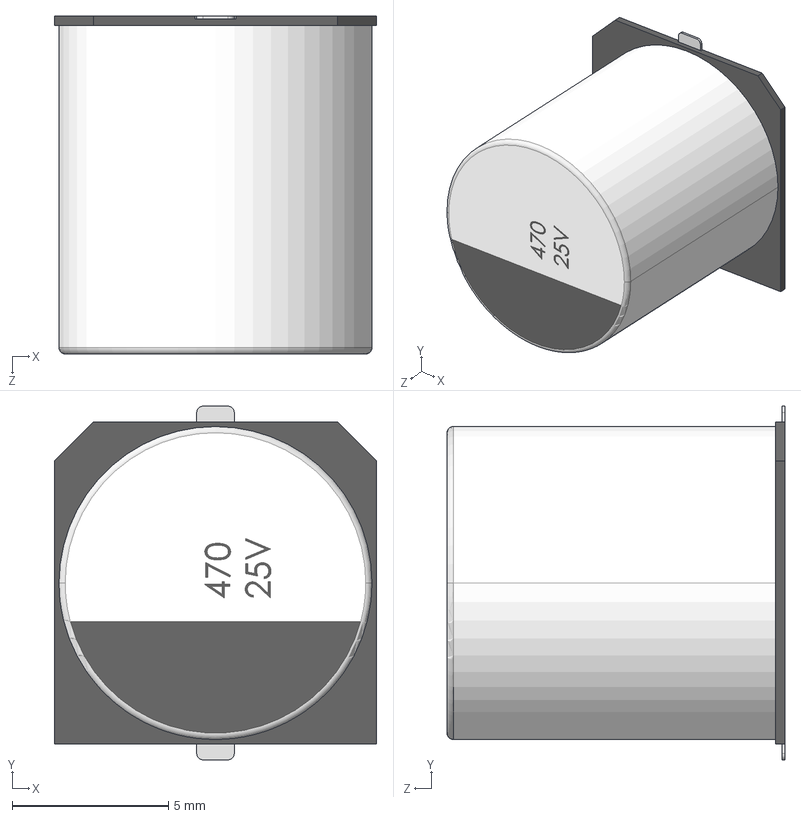
[picture p104: CAD file, 2025-06-11]
3dmodels/Cap alu elko SMD 10x10,5.step
10.3 x 11.3 x 10.8 mm
