kerteszsasa/kicad_user_lib/3dmodels/TH_LED_3mm_Y.STEP

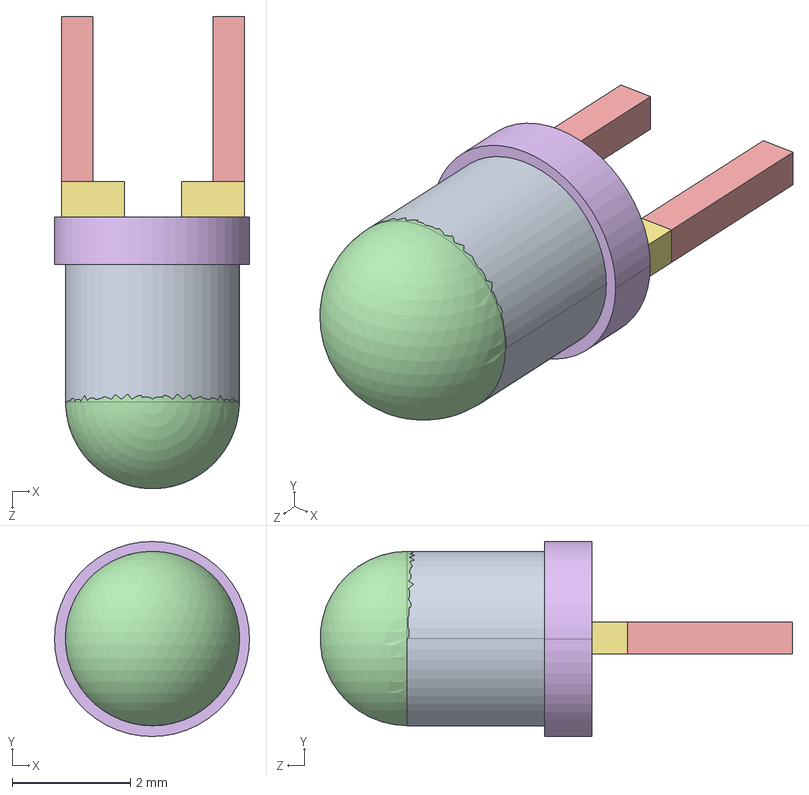
[picture p105: CAD file, 2025-06-11]
3dmodels/TH_LED_3mm_Y.STEP
3.30 x 3.30 x 8.00 mm
SW3dPS-LEDd3Y_Cylinder1
SW3dPS-LEDd3Y_Extruded2 x 2
SW3dPS-LEDd3Y_Extruded4 x 2
SW3dPS-LEDd3Y_Sphere
SW3dPS-LEDd3Y_Extruded x 2
SW3dPS-LEDd3Y_Cylinder
SW3dPS-LEDd3Y_Extruded5 x 2
SW3dPS-LEDd3Y_Extruded1
SW3dPS-LEDd3Y_Extruded3
