kerteszsasa/kicad_user_lib/3dmodels/LED_Osram_PLCC2.STEP

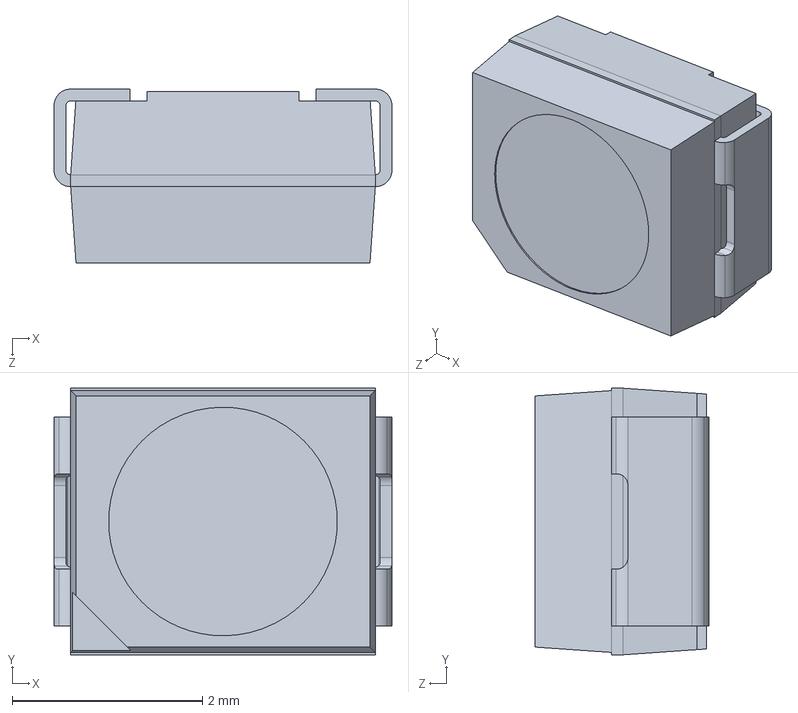
[picture p106: CAD file, 2025-06-11]
3dmodels/LED_Osram_PLCC2.STEP
3.55 x 2.80 x 1.83 mm
