kerteszsasa/kicad_user_lib/3dmodels/User Library-DTSM-2.step

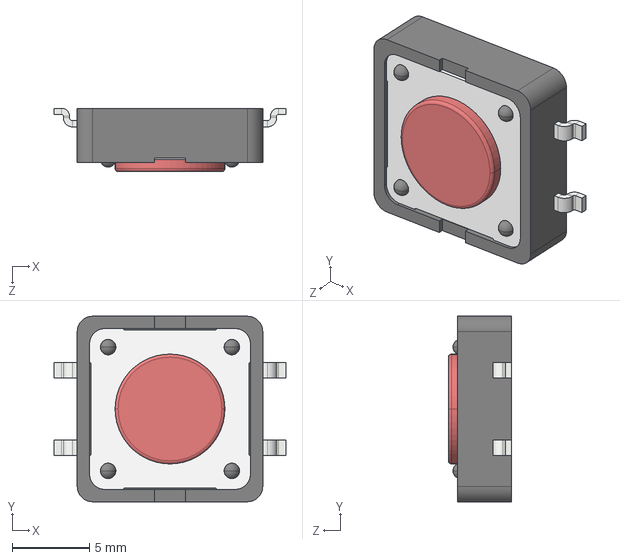
[picture p107: CAD file, 2025-06-11]
3dmodels/User Library-DTSM-2.step
15.0 x 12.0 x 4.10 mm
