kerteszsasa/kicad_user_lib/3dmodels/Sensor-HALL SENSOR DIP.step

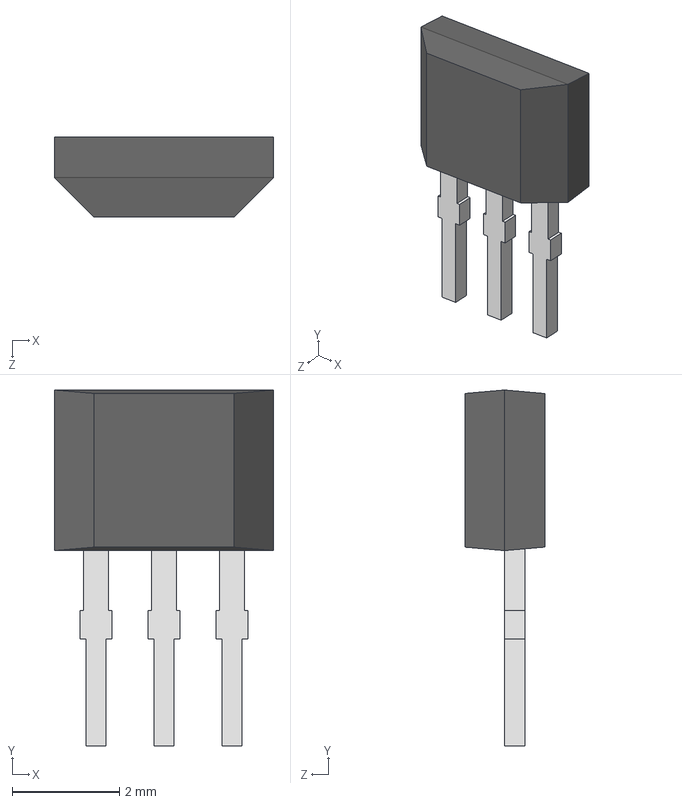
[picture p108: CAD file, 2025-06-11]
3dmodels/Sensor-HALL SENSOR DIP.step
4.10 x 6.65 x 1.50 mm
