kerteszsasa/kicad_user_lib/3dmodels/Diode-SOD-123_DiodesInc.step

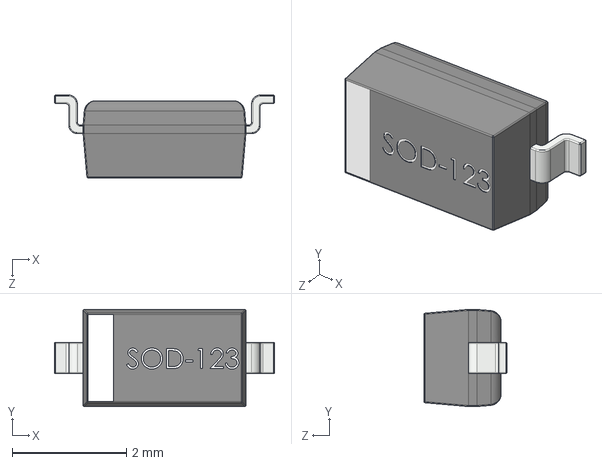
[picture p109: CAD file, 2025-06-11]
3dmodels/Diode-SOD-123_DiodesInc.step
3.85 x 1.70 x 1.45 mm
