kerteszsasa/kicad_user_lib/3dmodels/TE_1-2834015-6.stp

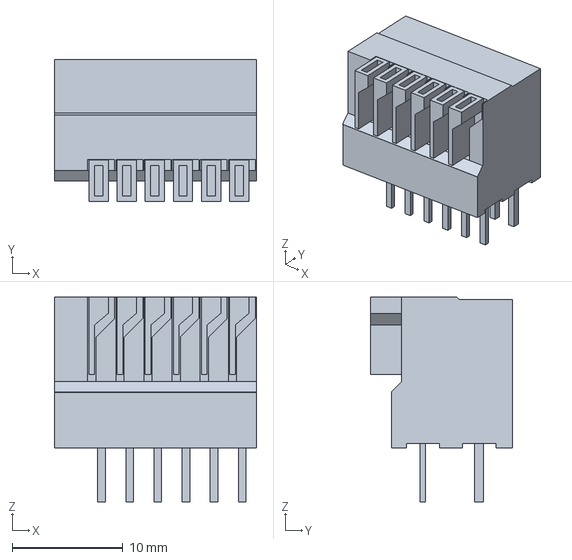
[picture p110: CAD file, 2025-06-11]
3dmodels/TE_1-2834015-6.stp
18.2 x 12.8 x 18.5 mm
