kerteszsasa/kicad_user_lib/3dmodels/RJ45_TH_90.step

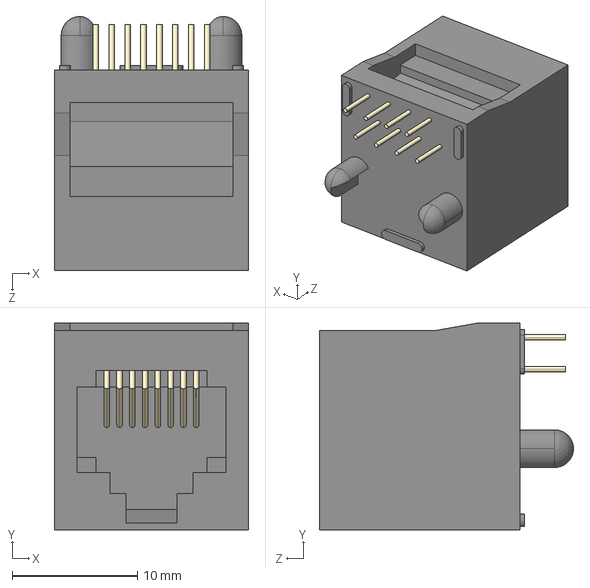
[picture p111: CAD file, 2025-06-11]
3dmodels/RJ45_TH_90.step
15.5 x 16.5 x 20.3 mm
