kerteszsasa/kicad_user_lib/3dmodels/H1102NLT.step

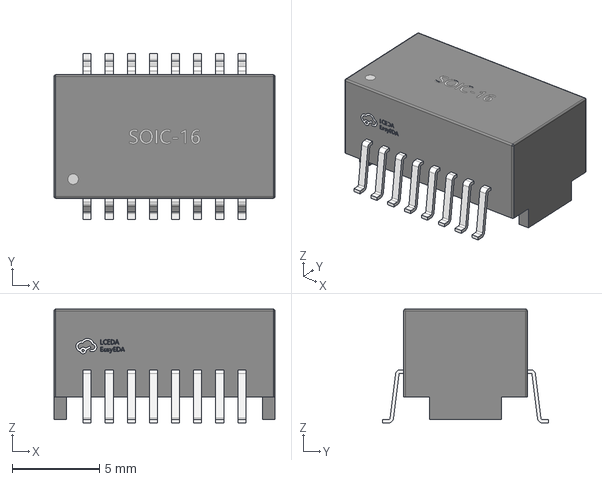
[picture p112: CAD file, 2025-06-11]
3dmodels/H1102NLT.step
12.7 x 9.53 x 6.55 mm
