kerteszsasa/kicad_user_lib/3dmodels/wago-2060-402.stp

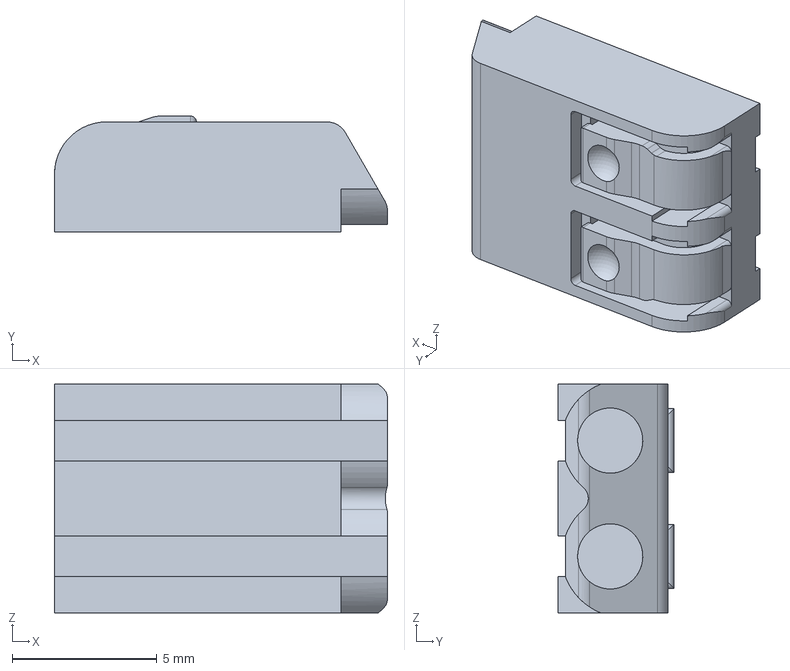
[picture p113: CAD file, 2025-06-11]
3dmodels/wago-2060-402.stp
11.5 x 4.00 x 7.90 mm
