kerteszsasa/kicad_user_lib/3dmodels/Cap alu elko SMD 6,3x7,7.step

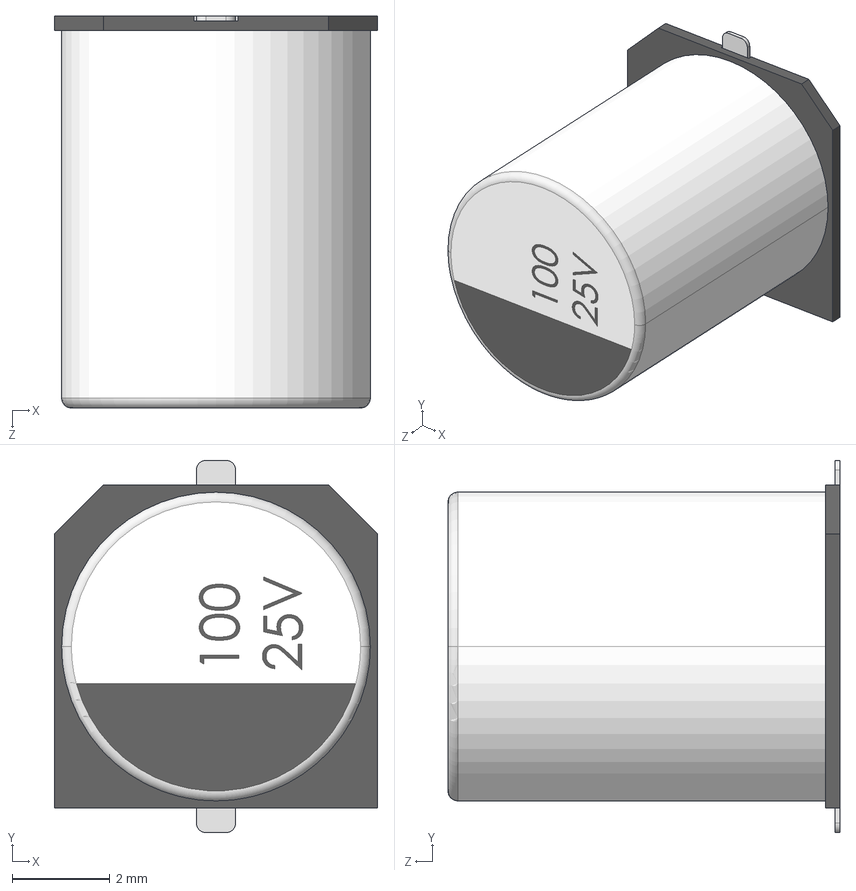
[picture p114: CAD file, 2025-06-11]
3dmodels/Cap alu elko SMD 6,3x7,7.step
6.60 x 7.60 x 8.00 mm
