kerteszsasa/kicad_user_lib/3dmodels/SD.STEP

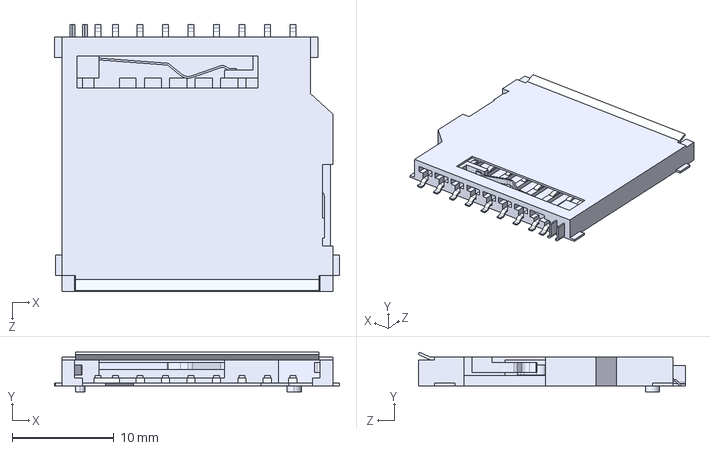
[picture p115: CAD file, 2025-06-11]
3dmodels/SD.STEP
28.0 x 3.90 x 26.3 mm
