kerteszsasa/kicad_user_lib/3dmodels/SOIC18-300.step

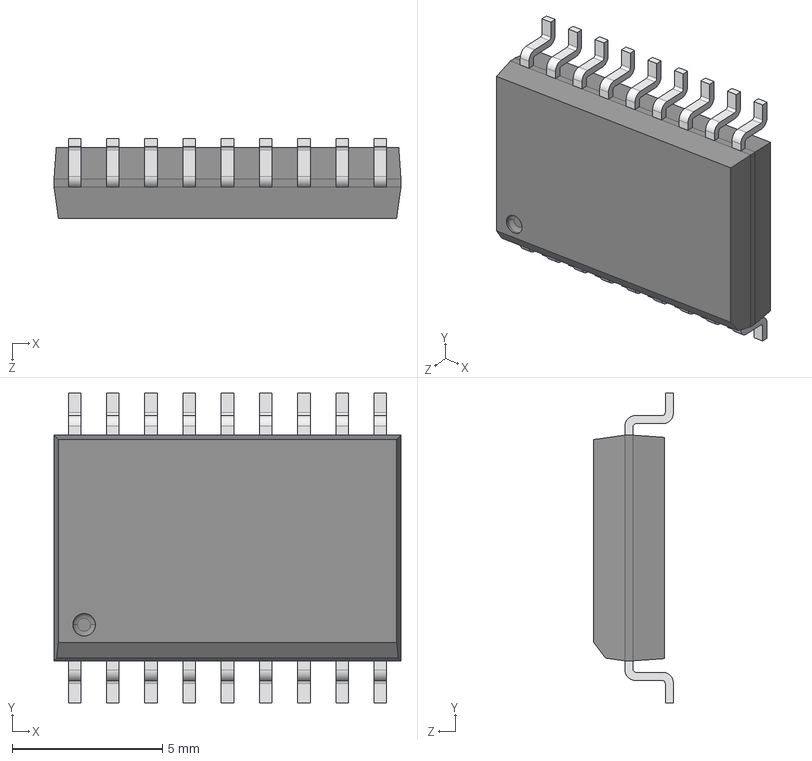
[picture p116: CAD file, 2025-06-11]
3dmodels/SOIC18-300.step
11.5 x 10.3 x 2.65 mm
