kerteszsasa/kicad_user_lib/3dmodels/Switch_slide_dpdt.stp

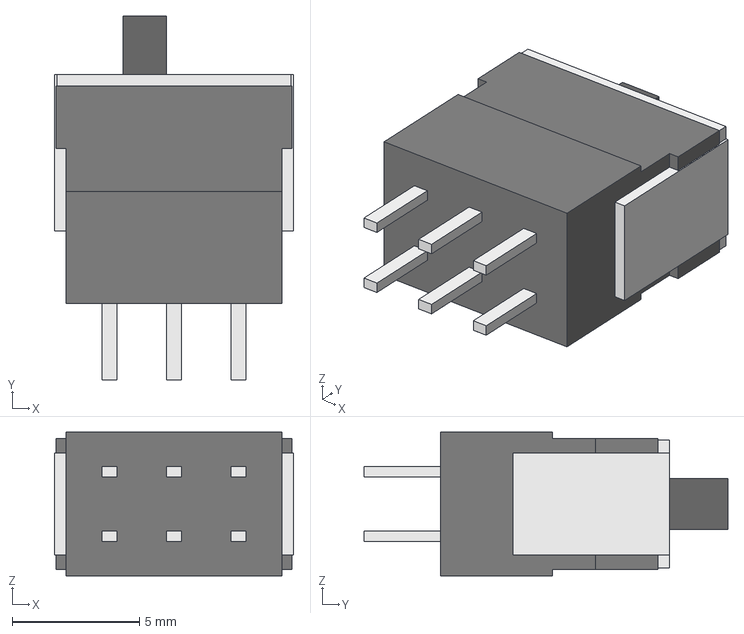
[picture p117: CAD file, 2025-06-11]
3dmodels/Switch_slide_dpdt.stp
9.40 x 14.3 x 5.65 mm
