kerteszsasa/kicad_user_lib/3dmodels/Connector_DF40C-90DS-0_4V_51.stp

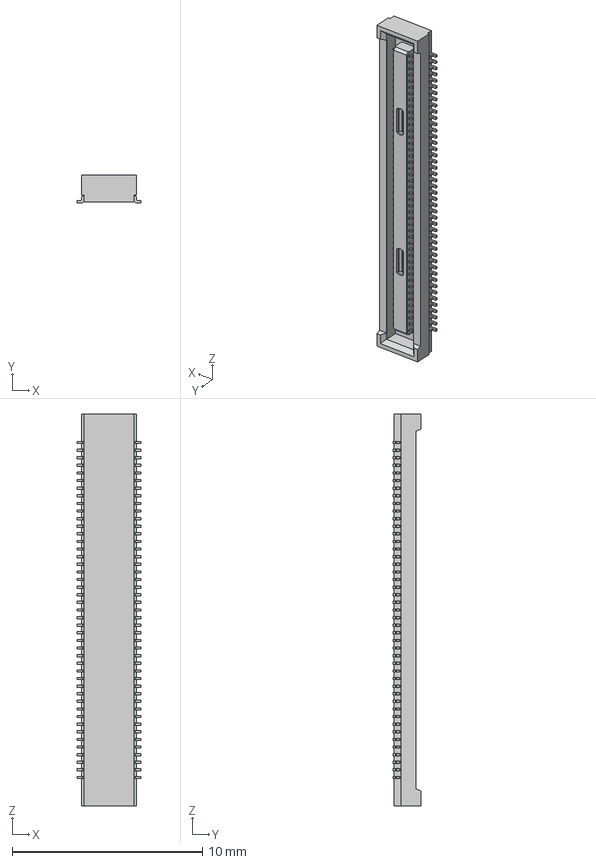
[picture p118: CAD file, 2025-06-11]
3dmodels/Connector_DF40C-90DS-0_4V_51.stp
3.38 x 1.45 x 20.6 mm
