kerteszsasa/kicad_user_lib/3dmodels/825-22-003-10-001101.stp

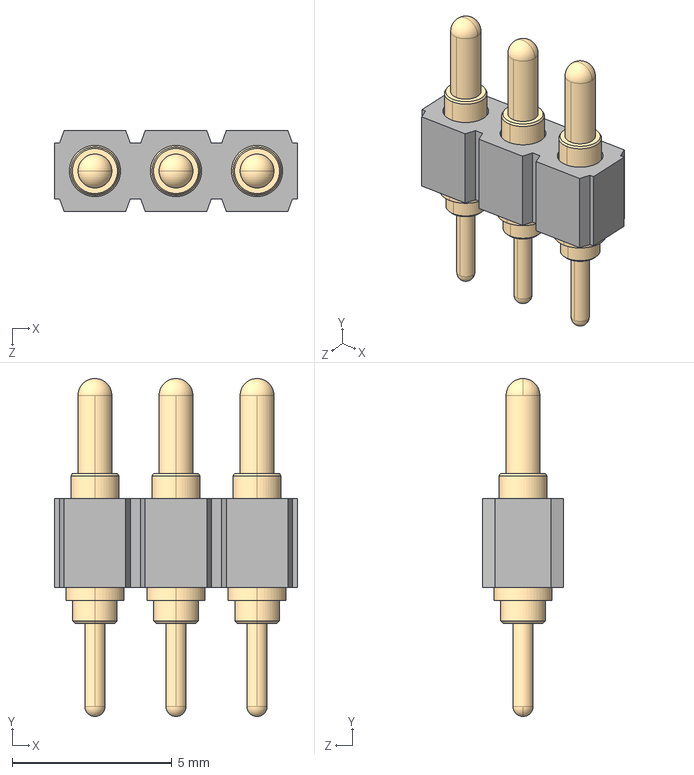
[picture p119: CAD file, 2025-06-11]
3dmodels/825-22-003-10-001101.stp
7.62 x 10.6 x 2.54 mm
mill-max-825-22-003-10-001101_P3XX-18-010-00-090000(P303-18-010-00-090000)
mill-max-825-22-003-10-001101_0914 x 3
