kerteszsasa/kicad_user_lib/3dmodels/Connector_molex_436501012.stp

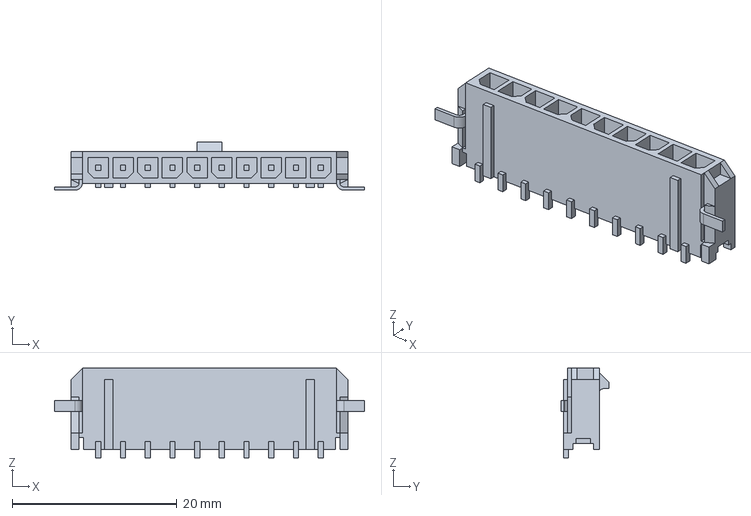
[picture p120: CAD file, 2025-06-11]
3dmodels/Connector_molex_436501012.stp
37.7 x 5.87 x 10.9 mm
