kerteszsasa/kicad_user_lib/3dmodels/RES_helipot.step

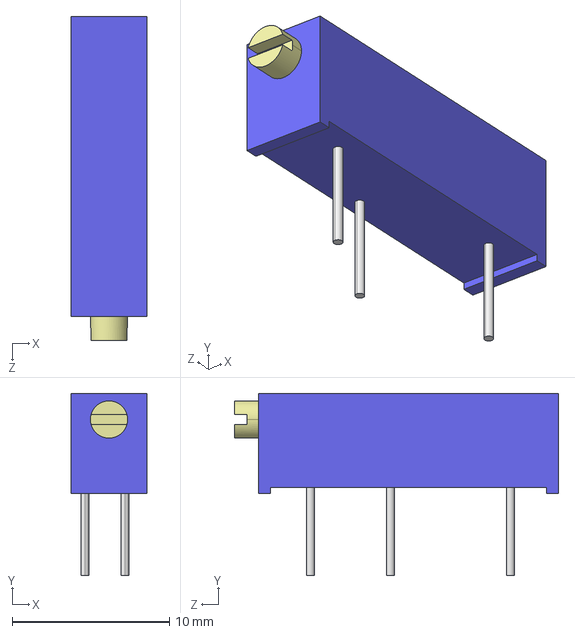
[picture p121: CAD file, 2025-06-11]
3dmodels/RES_helipot.step
4.83 x 11.6 x 20.6 mm
