kerteszsasa/kicad_user_lib/3dmodels/HEADER_2.54MM_M_2x10_box.STEP

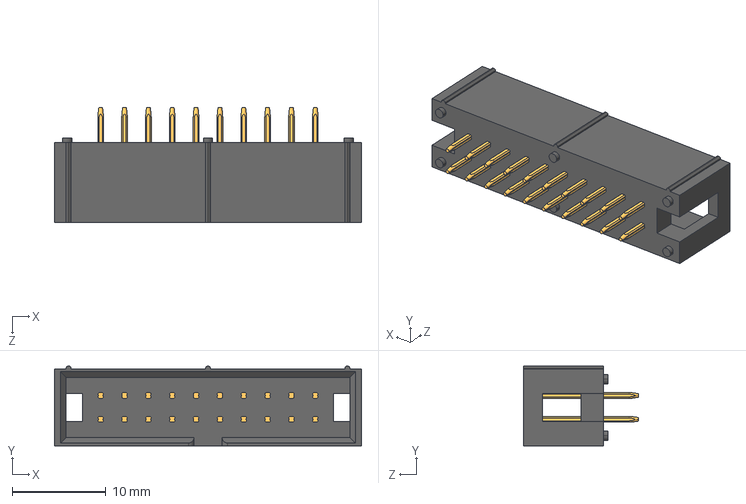
[picture p122: CAD file, 2025-06-11]
3dmodels/HEADER_2.54MM_M_2x10_box.STEP
32.7 x 8.50 x 12.2 mm
User Library-idc-20_asm_BODY
User Library-idc-20_asm_PIN x 20
