kerteszsasa/kicad_user_lib/3dmodels/LED_optical-TLP291-4(SOP16).STEP

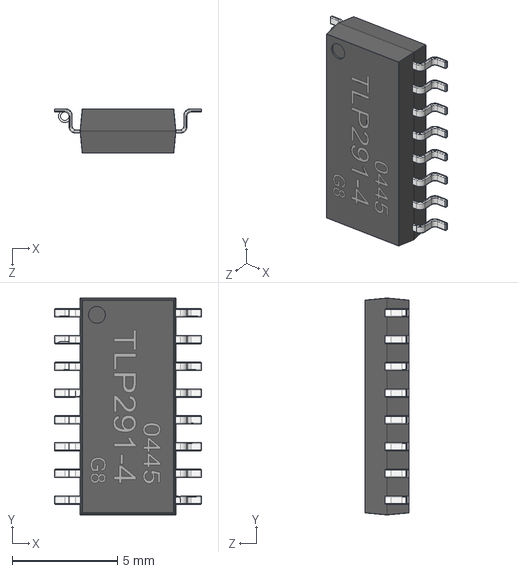
[picture p123: CAD file, 2025-06-11]
3dmodels/LED_optical-TLP291-4(SOP16).STEP
7.00 x 10.3 x 2.10 mm
User Library-TLP291-4(SOP16)_Document
User Library-TLP291-4(SOP16)__X_EB_X_B8_X_94_X_EB_X_A1_X_9D 01
