kerteszsasa/kicad_user_lib/3dmodels/SMD_header_2.00mm_f_2x6.step

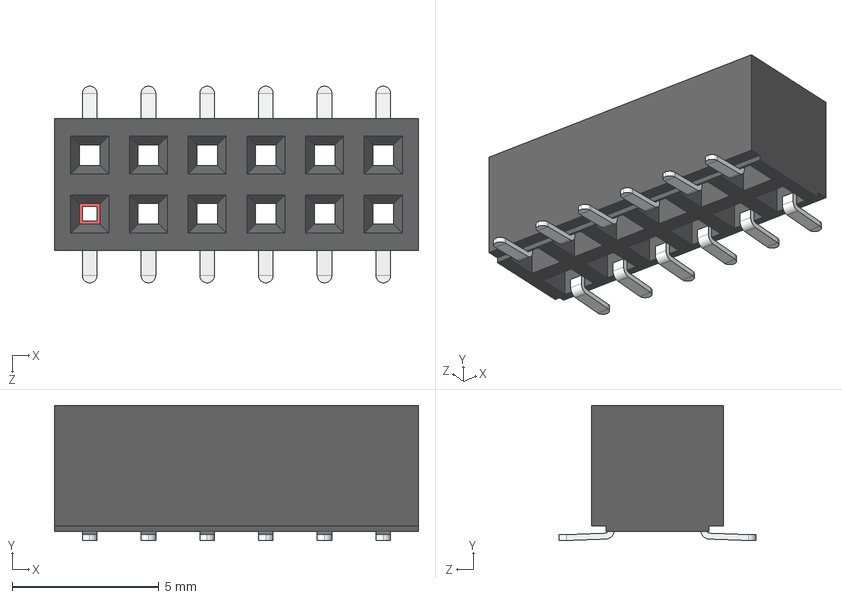
[picture p124: CAD file, 2025-06-11]
3dmodels/SMD_header_2.00mm_f_2x6.step
12.4 x 4.60 x 6.70 mm
