kerteszsasa/kicad_user_lib/3dmodels/User Library-corpo TCRT 5000.step

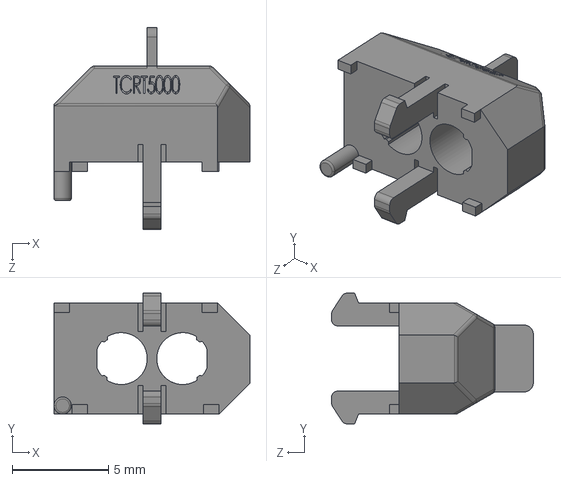
[picture p125: CAD file, 2025-06-11]
3dmodels/User Library-corpo TCRT 5000.step
10.2 x 6.80 x 10.5 mm
