kerteszsasa/kicad_user_lib/3dmodels/LED_RGB_Osram_PLCC6.step

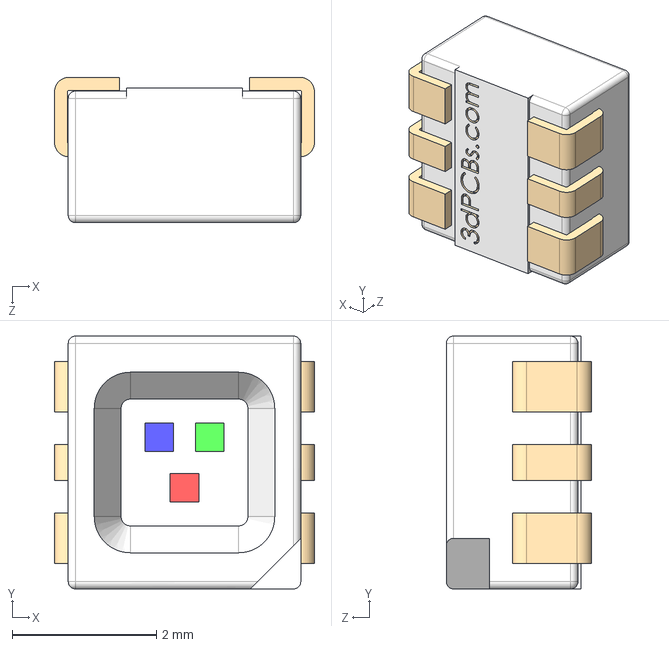
[picture p126: CAD file, 2025-06-11]
3dmodels/LED_RGB_Osram_PLCC6.step
3.60 x 3.50 x 2.01 mm
