kerteszsasa/kicad_user_lib/3dmodels/LED-optical-SOP-4L.step

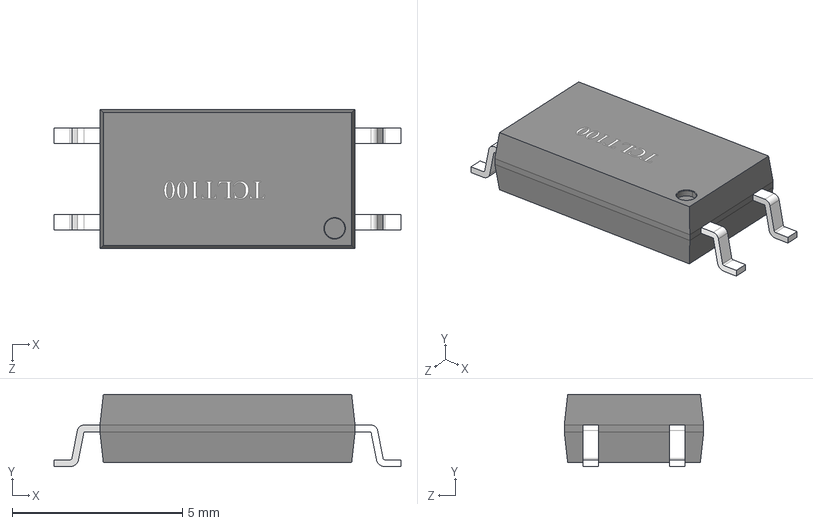
[picture p127: CAD file, 2025-06-11]
3dmodels/LED-optical-SOP-4L.step
10.2 x 2.12 x 4.10 mm
