kerteszsasa/kicad_user_lib/3dmodels/Connector_microfit_2x12_430452400.stp

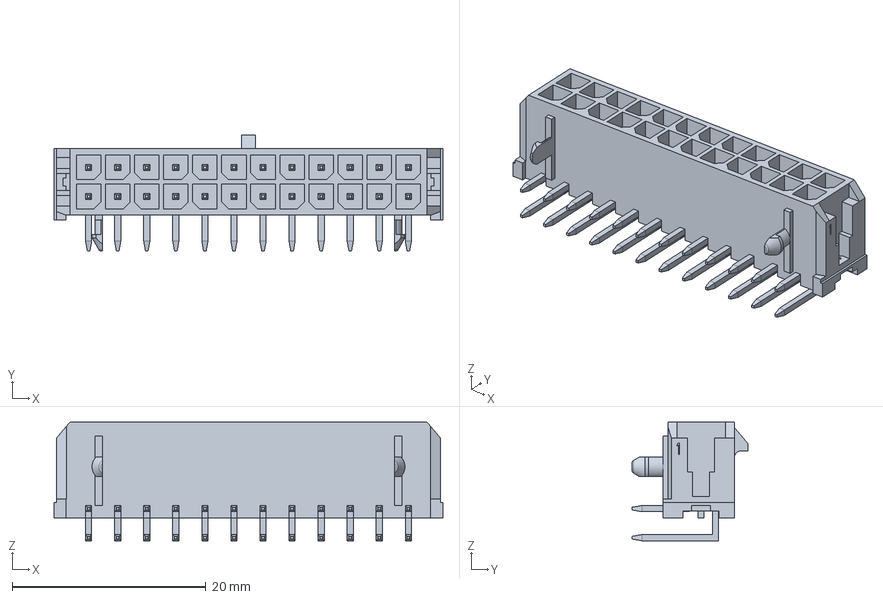
[picture p128: CAD file, 2025-06-11]
3dmodels/Connector_microfit_2x12_430452400.stp
40.1 x 11.9 x 12.2 mm
