kerteszsasa/kicad_user_lib/3dmodels/TO220_hajtott lábú.STEP

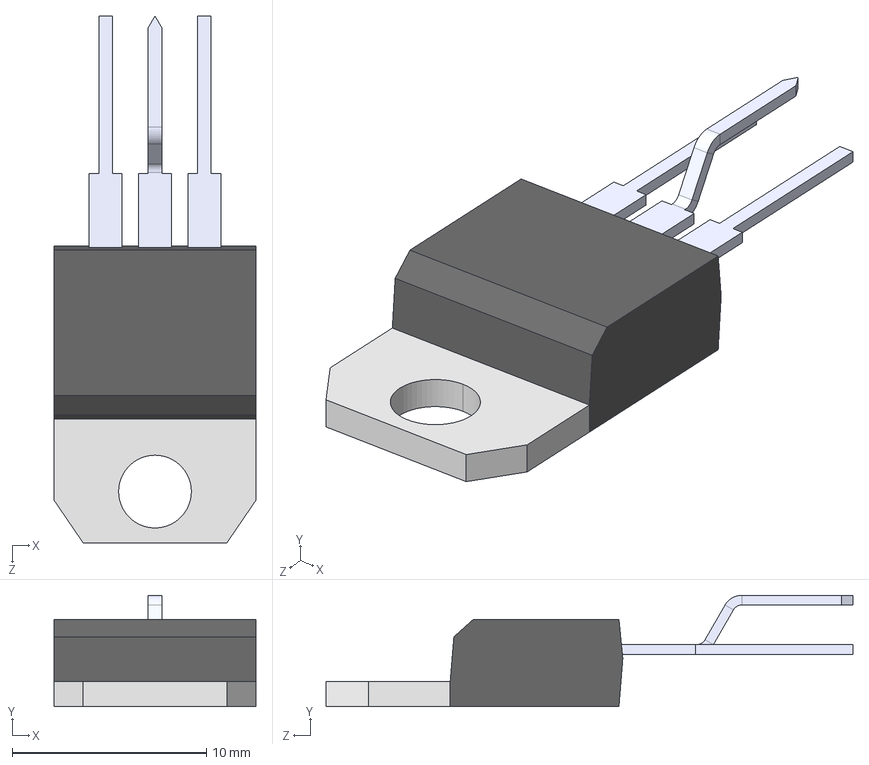
[picture p129: CAD file, 2025-06-11]
3dmodels/TO220_hajtott lábú.STEP
10.4 x 5.74 x 27.2 mm
User Library-TO220_TO220A12V_body
User Library-TO220_TO220A12V_tab
User Library-TO220_TO220A12V_pin_Diritto x 2
User Library-TO220_TO220A12V_pin_Passo 2,54
