kerteszsasa/kicad_user_lib/3dmodels/Connector_microSD_molex_473521001.stp

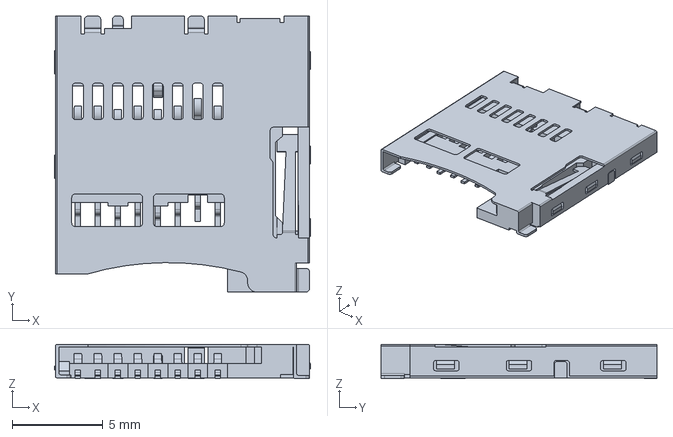
[picture p130: CAD file, 2025-06-11]
3dmodels/Connector_microSD_molex_473521001.stp
14.1 x 15.2 x 1.88 mm
