kerteszsasa/kicad_user_lib/3dmodels/Connector_molex_mfit16p_430451600.stp

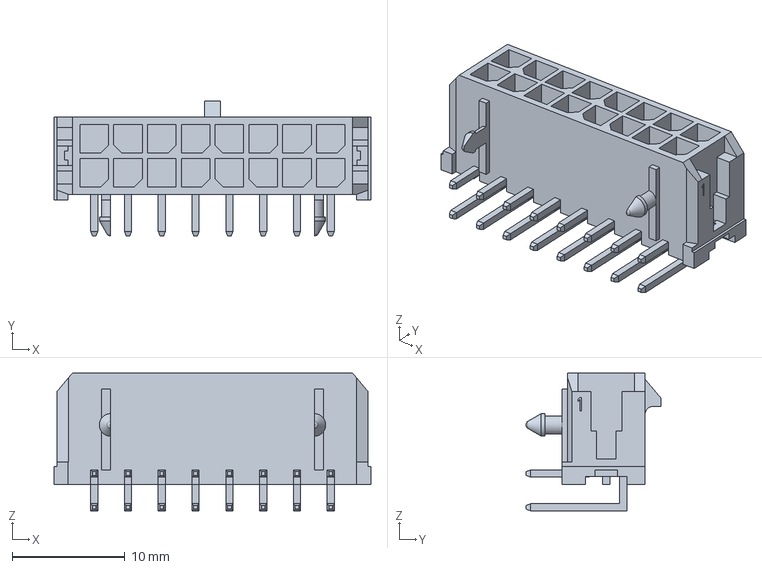
[picture p131: CAD file, 2025-06-11]
3dmodels/Connector_molex_mfit16p_430451600.stp
28.1 x 11.9 x 12.2 mm
