kerteszsasa/kicad_user_lib/3dmodels/QuartzHC49S_TH.STEP

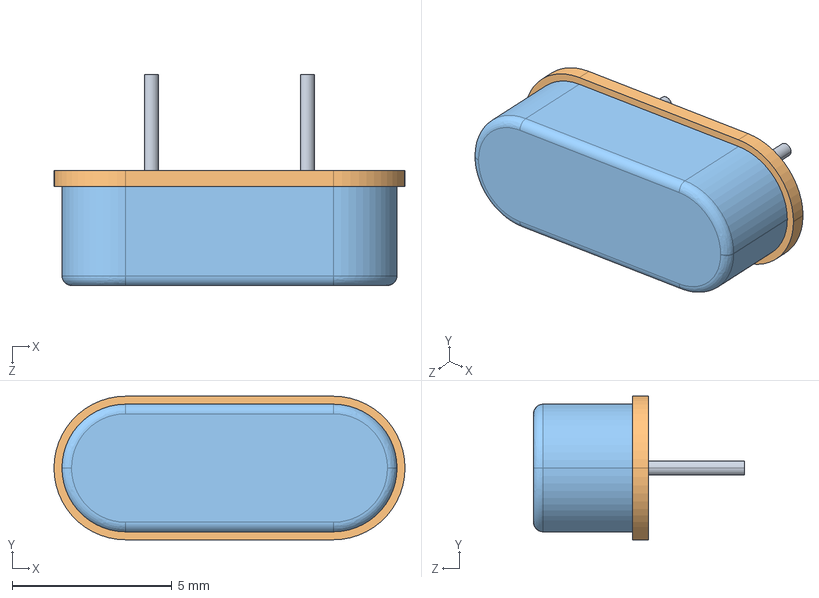
[picture p132: CAD file, 2025-06-11]
3dmodels/QuartzHC49S_TH.STEP
11.0 x 4.49 x 6.60 mm
User Library-HC49S-1_Fusion
User Library-HC49S-1_Fillet
User Library-HC49S-1_Fillet002
