kerteszsasa/kicad_user_lib/3dmodels/CR2032_holder.STEP

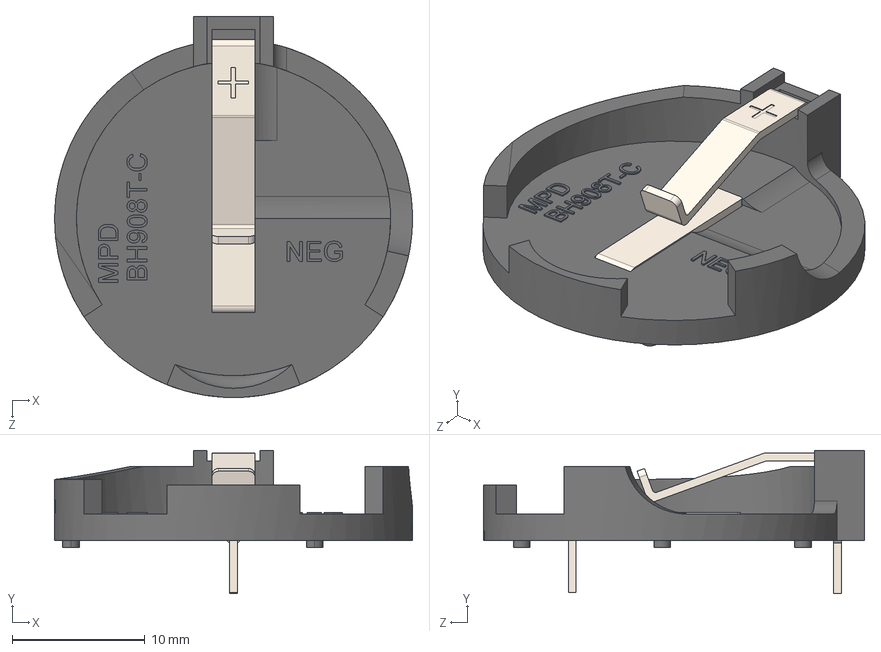
[picture p133: CAD file, 2025-06-11]
3dmodels/CR2032_holder.STEP
27.0 x 10.8 x 28.8 mm
User Library-BH908T-C_BH908T-C Bloco_Valor predeterminado
User Library-BH908T-C_BH908T-C Terminal negativo_Valor predeterminado
User Library-BH908T-C_BH908T-C Terminal positivo_Valor predeterminado
