kerteszsasa/kicad_user_lib/3dmodels/MB10S--3DModel-STEP-56544.STEP

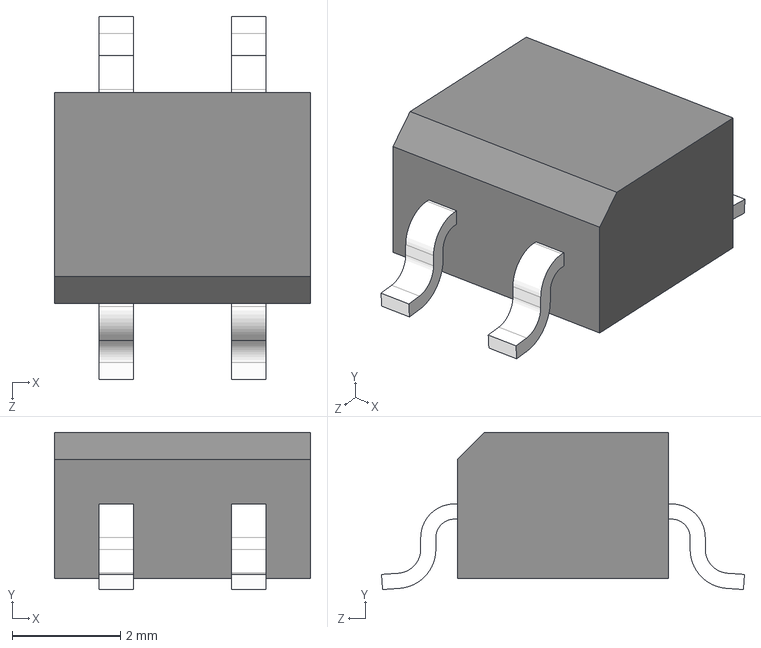
[picture p134: CAD file, 2025-06-11]
3dmodels/MB10S--3DModel-STEP-56544.STEP
4.72 x 2.90 x 6.70 mm
