kerteszsasa/kicad_user_lib/3dmodels/Digital_SSOP-28-3.STEP

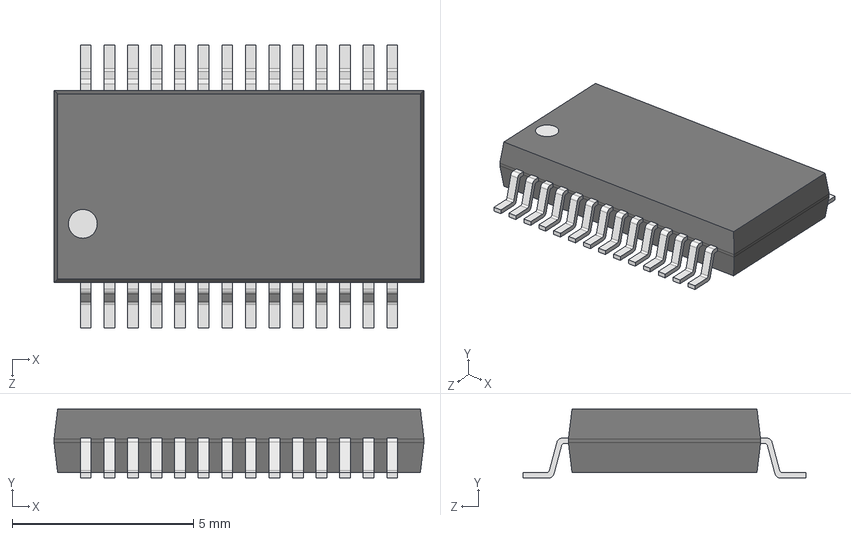
[picture p135: CAD file, 2025-06-11]
3dmodels/Digital_SSOP-28-3.STEP
10.2 x 1.90 x 7.80 mm
User Library-SSOP-28-3__X2_041A043E0440043F04430441_X0_
User Library-SSOP-28-3__X2_041C04350442043A0430_X0_
User Library-SSOP-28-3__X2_041D043E0436043A0430_X0_ x 14
