kerteszsasa/kicad_user_lib/3dmodels/SRP6540.stp

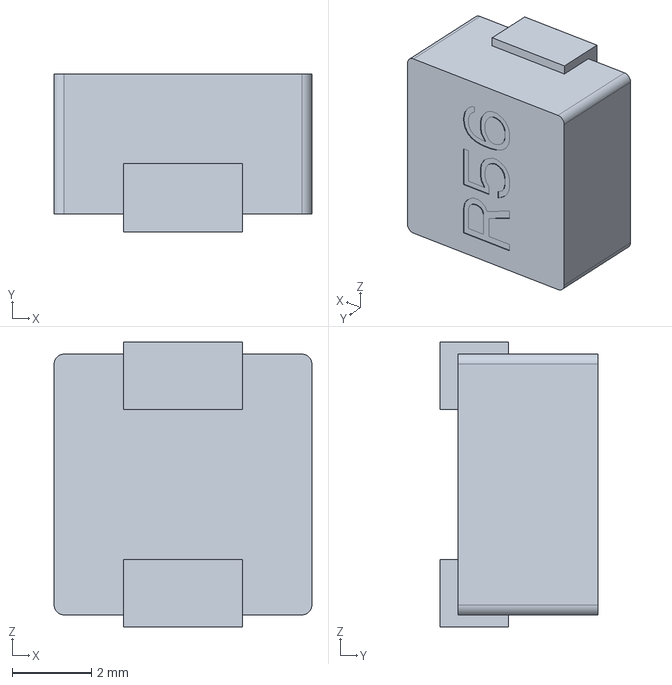
[picture p136: CAD file, 2025-06-11]
3dmodels/SRP6540.stp
6.50 x 3.99 x 7.19 mm
