kerteszsasa/kicad_user_lib/3dmodels/Other_BATTERY_CR18650.step

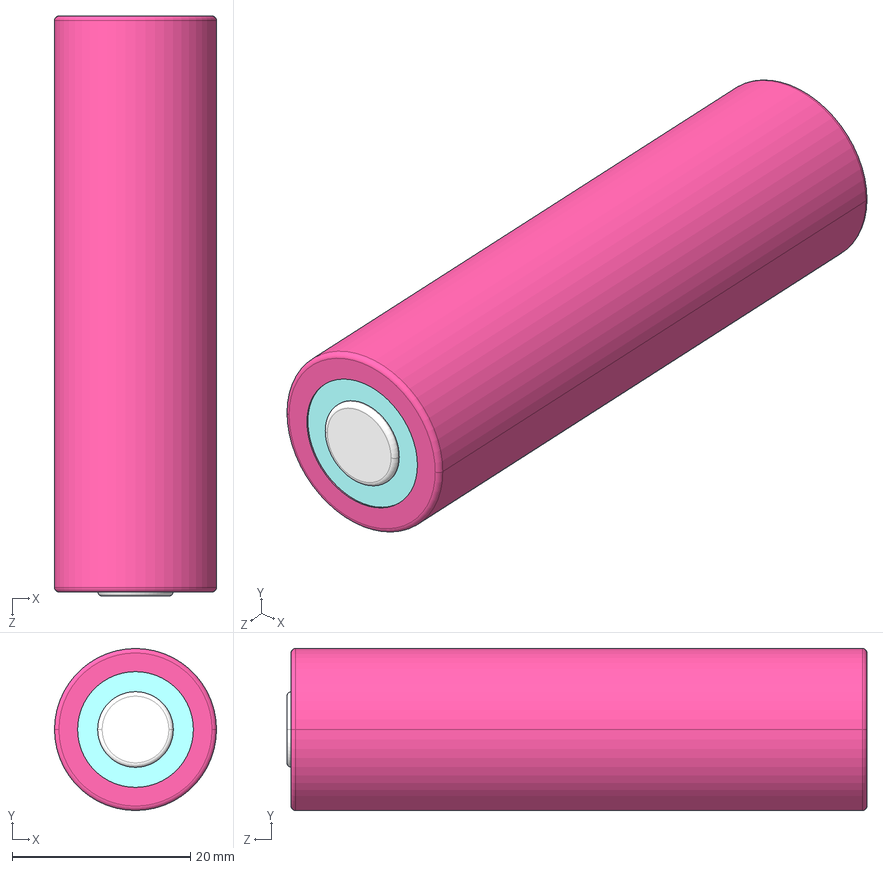
[picture p137: CAD file, 2025-06-11]
3dmodels/Other_BATTERY_CR18650.step
18.2 x 18.2 x 65.2 mm
