kerteszsasa/kicad_user_lib/3dmodels/sot23-6.step

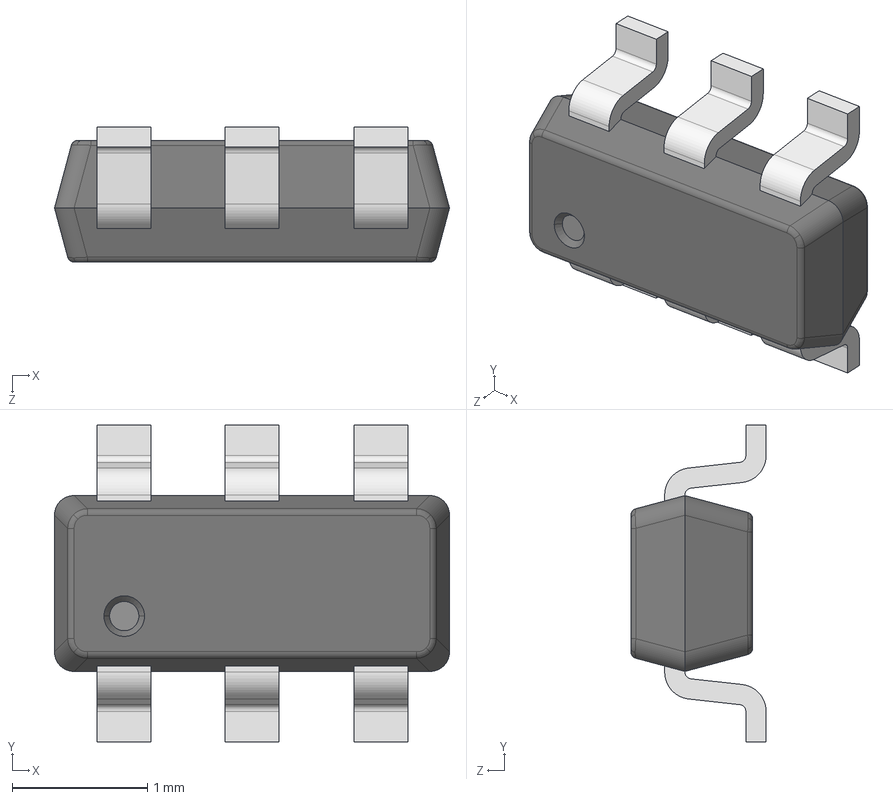
[picture p138: CAD file, 2025-06-11]
3dmodels/sot23-6.step
2.92 x 2.34 x 1.00 mm
