kerteszsasa/kicad_user_lib/3dmodels/User Library-LQFP144.STEP

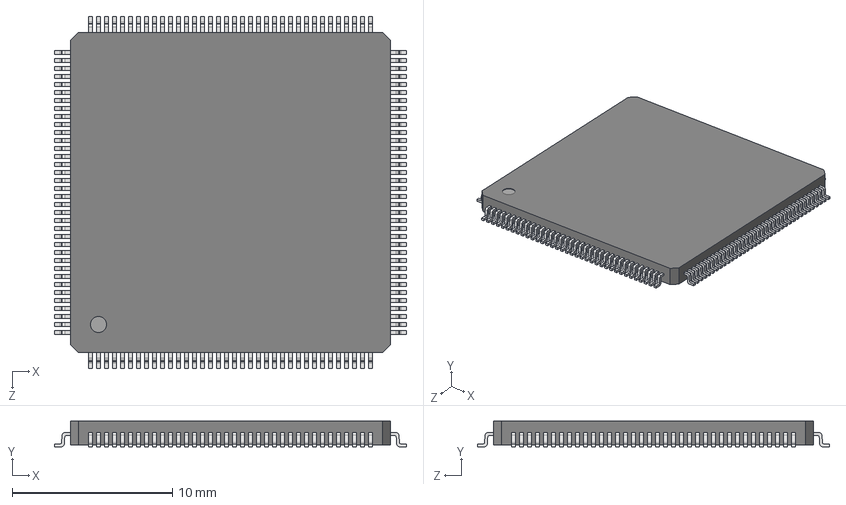
[picture p139: CAD file, 2025-06-11]
3dmodels/User Library-LQFP144.STEP
22.0 x 1.60 x 22.0 mm
Fuss_LQFP144 x 1368
Part_LQFP144_Default
