kerteszsasa/kicad_user_lib/3dmodels/BUTTON_6X6 90deg.stp

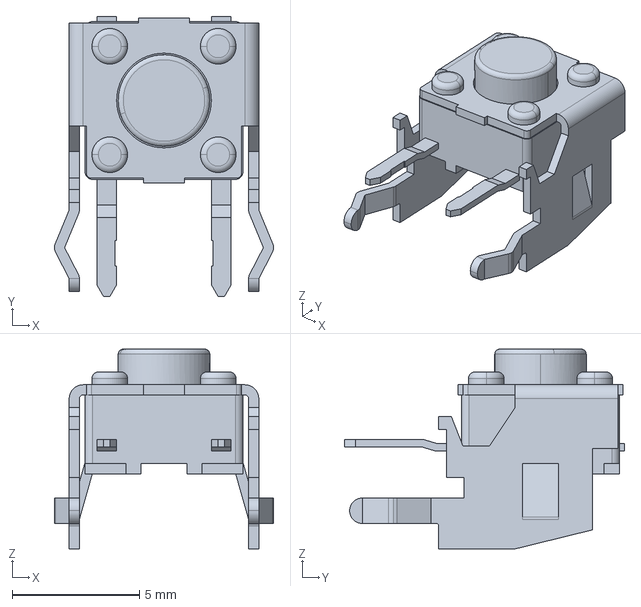
[picture p140: CAD file, 2025-06-11]
3dmodels/BUTTON_6X6 90deg.stp
8.61 x 11.0 x 7.85 mm
