kerteszsasa/kicad_user_lib/3dmodels/QUARTZ_ABS25.step

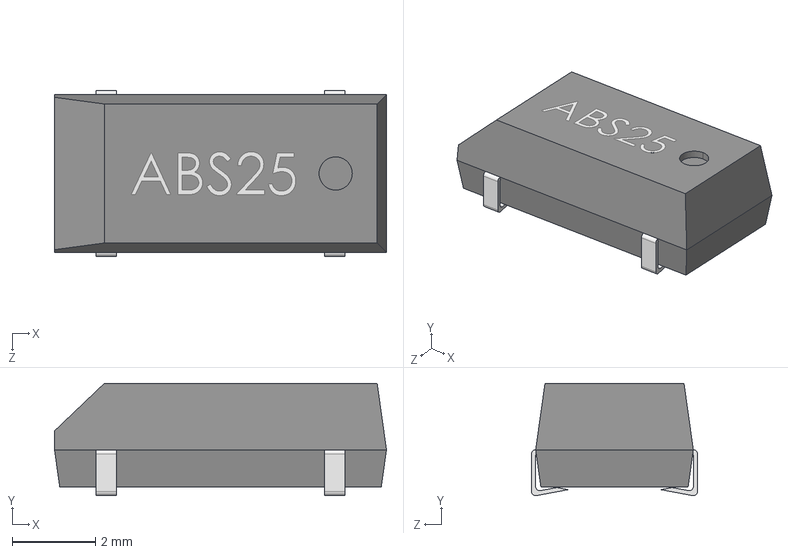
[picture p141: CAD file, 2025-06-11]
3dmodels/QUARTZ_ABS25.step
8.00 x 2.71 x 4.00 mm
