kerteszsasa/kicad_user_lib/3dmodels/Diode-DO-15-1.step

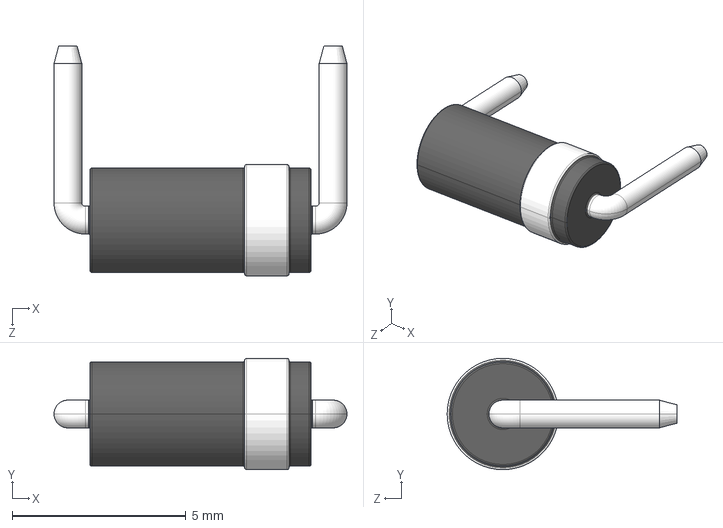
[picture p142: CAD file, 2025-06-11]
3dmodels/Diode-DO-15-1.step
8.42 x 3.20 x 6.60 mm
