kerteszsasa/kicad_user_lib/3dmodels/Diode-SOD80.step

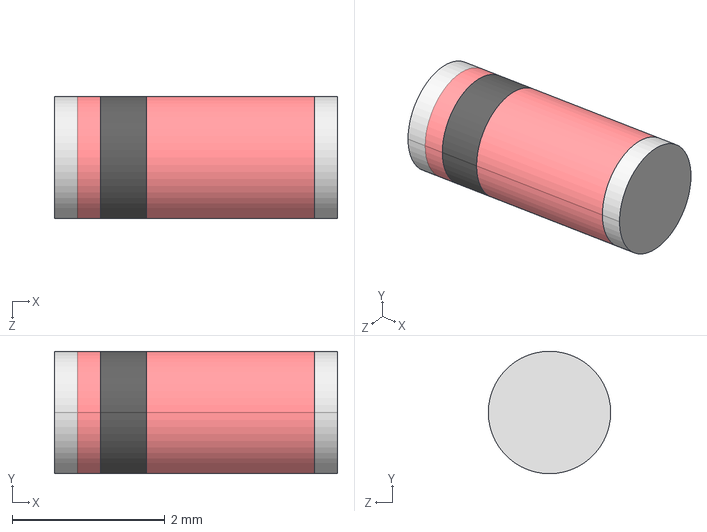
[picture p143: CAD file, 2025-06-11]
3dmodels/Diode-SOD80.step
3.70 x 1.60 x 1.60 mm
