kerteszsasa/kicad_user_lib/3dmodels/Capactitor_13,5x7,5mm.step

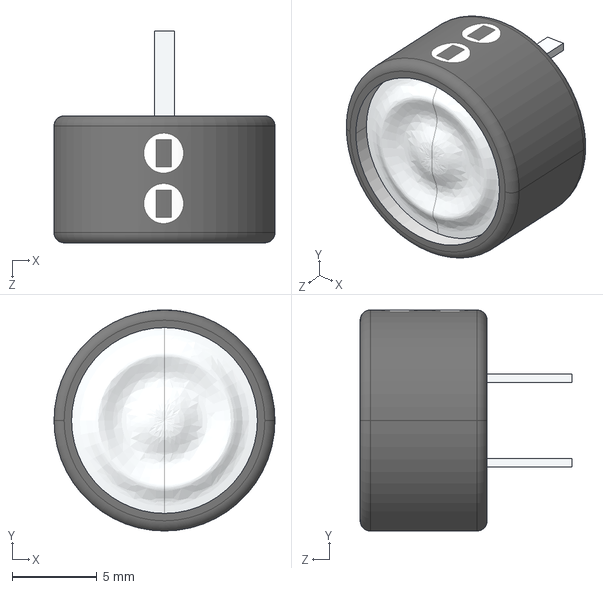
[picture p144: CAD file, 2025-06-11]
3dmodels/Capactitor_13,5x7,5mm.step
13.0 x 13.0 x 12.5 mm
