kerteszsasa/kicad_user_lib/3dmodels/molex_5050040812.stp

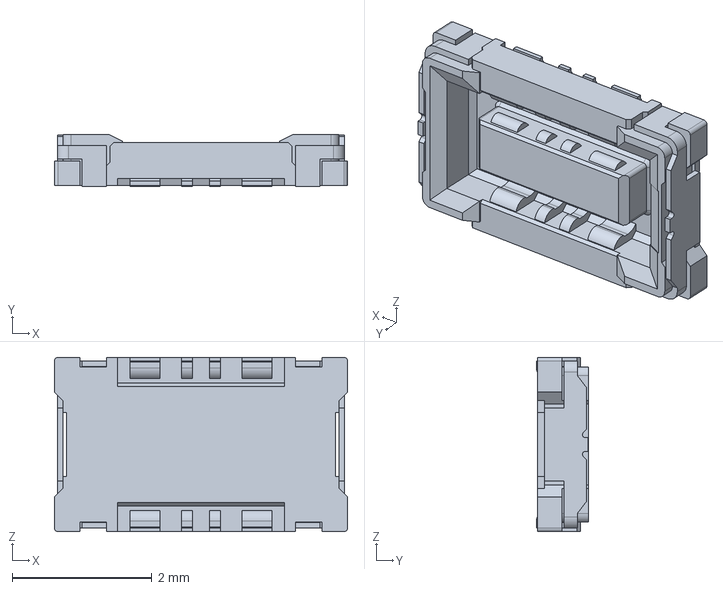
[picture p145: CAD file, 2025-06-11]
3dmodels/molex_5050040812.stp
4.20 x 0.75 x 2.50 mm
