kerteszsasa/kicad_user_lib/3dmodels/LED_d3-GRN.STEP

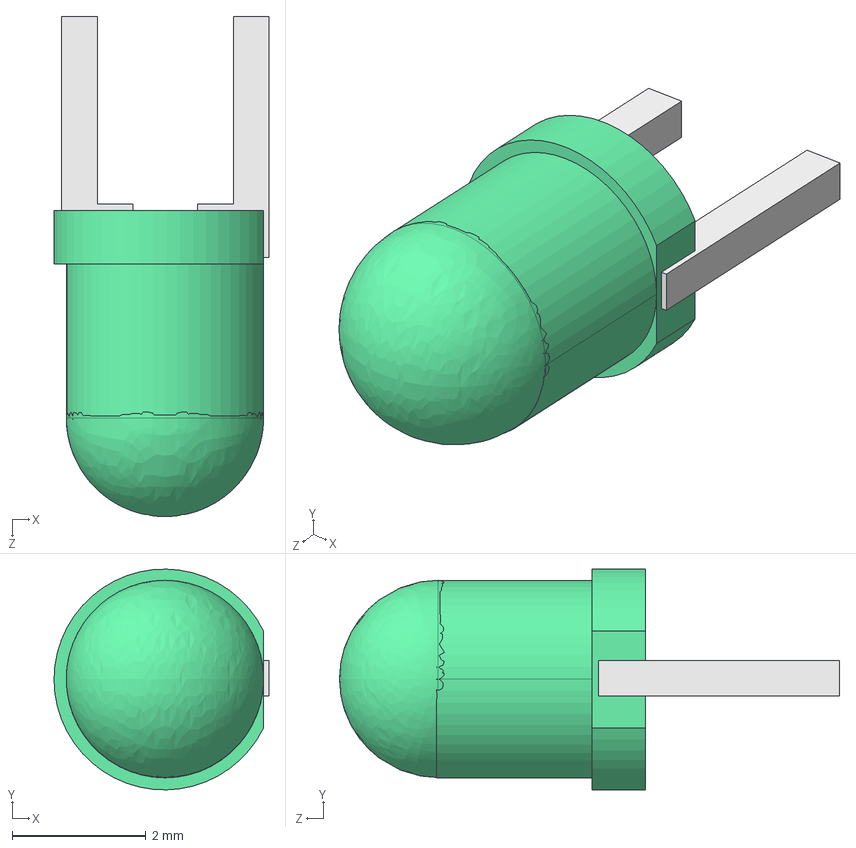
[picture p146: CAD file, 2025-06-11]
3dmodels/LED_d3-GRN.STEP
3.21 x 3.30 x 7.48 mm
User Library-LED_d3-GRN_LED_d3005
User Library-LED_d3-GRN_Cut
User Library-LED_d3-GRN_LED_d3007
User Library-LED_d3-GRN_Fusion001
