kerteszsasa/kicad_user_lib/3dmodels/User Library-Sliderswitch.step

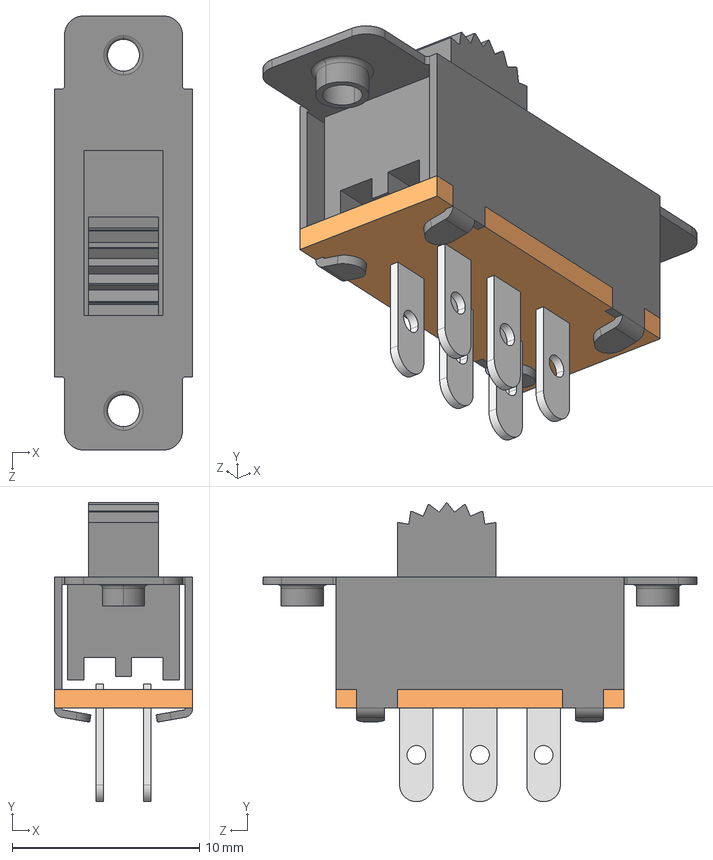
[picture p147: CAD file, 2025-06-11]
3dmodels/User Library-Sliderswitch.step
7.40 x 16.0 x 23.2 mm
