kerteszsasa/kicad_user_lib/3dmodels/Quartz_32,768_DT-26.step

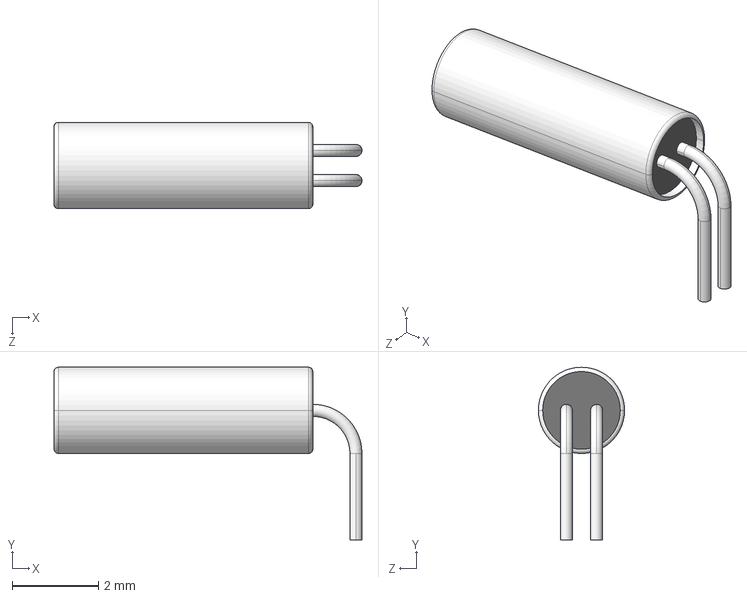
[picture p148: CAD file, 2025-06-11]
3dmodels/Quartz_32,768_DT-26.step
7.14 x 4.00 x 2.00 mm
