kerteszsasa/kicad_user_lib/3dmodels/SPD0P1.step

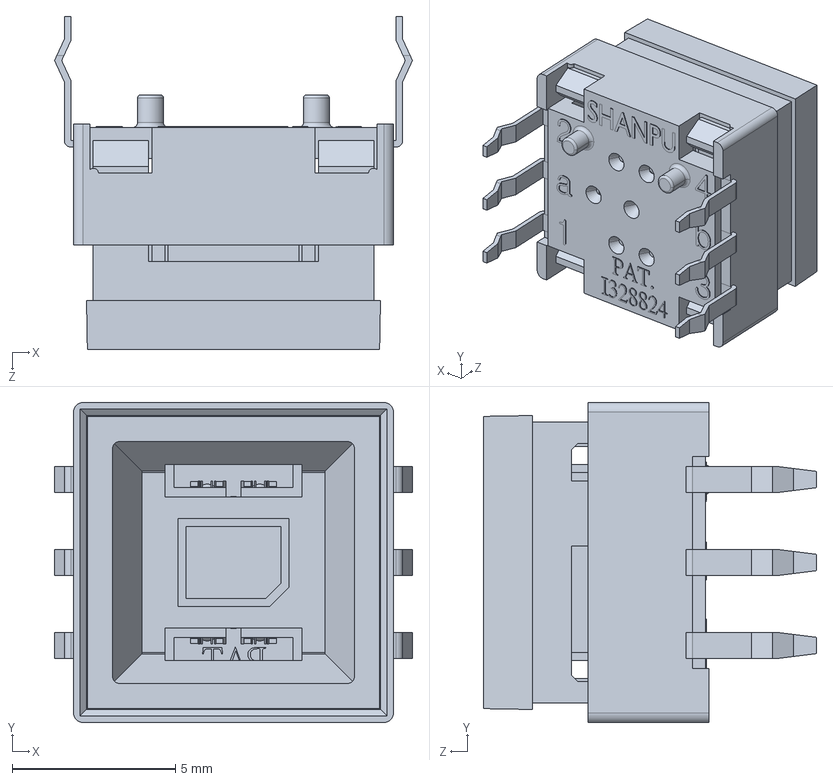
[picture p149: CAD file, 2025-06-11]
3dmodels/SPD0P1.step
11.0 x 9.80 x 10.2 mm
