kerteszsasa/kicad_user_lib/3dmodels/Connector_molex_mfit14p_430451400.stp

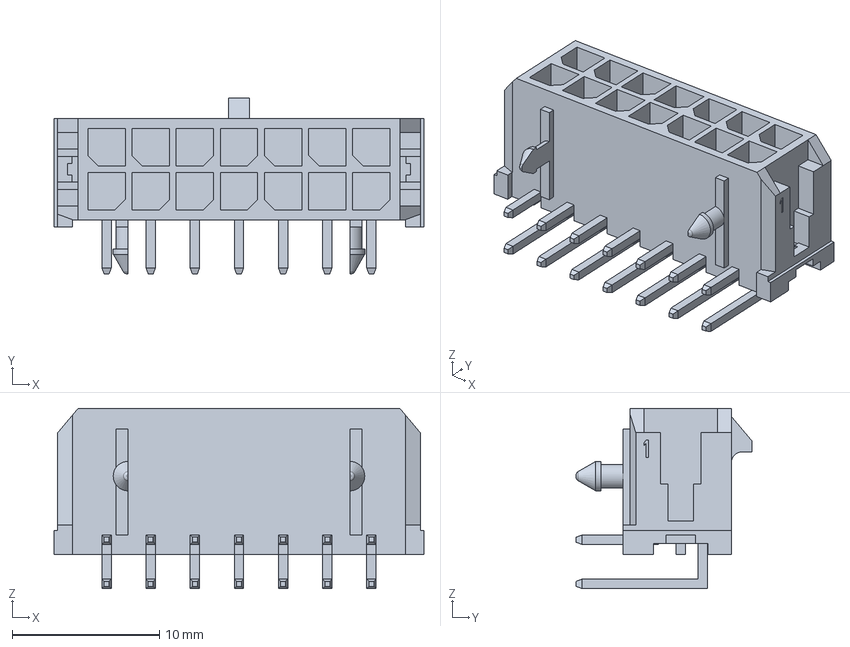
[picture p150: CAD file, 2025-06-11]
3dmodels/Connector_molex_mfit14p_430451400.stp
25.1 x 11.9 x 12.2 mm
