kerteszsasa/kicad_user_lib/3dmodels/USB3.0-1932258-1.stp

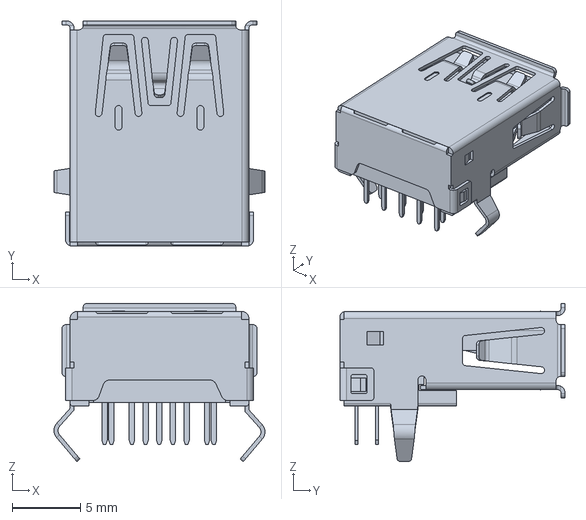
[picture p151: CAD file, 2025-06-11]
3dmodels/USB3.0-1932258-1.stp
15.5 x 16.5 x 11.6 mm
