kerteszsasa/kicad_user_lib/(list of files, cad)

Other CAD files:
3dmodels/TH_LED_3mm_G.STEP
3dmodels/10118192C.step
3dmodels/20020327c021b01lf.stp
3dmodels/20020327c031b01lf.stp
3dmodels/2410 fuse.step
3dmodels/2W_5mm_screw_282836-2.stp
3dmodels/35485.stp
3dmodels/3W_5mm_screw_282836-3.stp
3dmodels/436500403.stp
3dmodels/5510_LCD.stp
3dmodels/80154_TCRT5000_3D_Models.stp
3dmodels/ABM11.step
3dmodels/ABS.step
3dmodels/BG96.STEP
3dmodels/BM06B-SRSS-TB -LF--SN---3DModel-STEP-56544.STEP
3dmodels/Buzzet_th.step
3dmodels/CAP_TANTAL-CaseA_3216-18.step
3dmodels/CAP_TANTAL-CaseC_6032-28.step
3dmodels/CAP_TANTAL-CaseD_7343-31.step
3dmodels/CAP_TANTAL-CaseE_7260-38.step
3dmodels/CAP_TANTAL-CaseV_7343-20.step
3dmodels/CEP2242_Buzzer.step
3dmodels/CONNECTOR-USB_mini_B.step
3dmodels/CON_NC3MAH.stp
3dmodels/CR95HF-VMD5T.stp
3dmodels/CSYTAL-MC146.step
3dmodels/Cap alu elko SMD 13mmD X 14mmH.step
3dmodels/Cap alu elko SMD 16x16.step
3dmodels/Cap alu elko SMD 8mm X 10mm.STEP
3dmodels/Capacitor Radial 10x12.5.STEP
3dmodels/Capacitor Radial 10x12.step
3dmodels/Capacitor Radial 12,5x20mm.step
3dmodels/Capacitor electro 8x11_5x3_5mm.step
3dmodels/Capacitor radial 6.3x12.step
3dmodels/Capacitor-radial.STEP
3dmodels/Capacitor_1210.step
3dmodels/Capacitor_Wima_RM13x4x9,5.step
3dmodels/Capacitor_Wima_RM18x5x11.step
3dmodels/Capacitor_Wima_RM18x6x12.step
3dmodels/Capacitor_Wima_RM18x8x5.step
3dmodels/Capacitor_Wima_RM26,5x8,5x18,5.step
3dmodels/Capacitor_Wima_RM3,81x2,54.step
3dmodels/Capacitor_Wima_RM5,08x3,18.step
3dmodels/Coilcraft-MSS6132-DEFAULT.STEP
3dmodels/Connector-HR911105A.step
3dmodels/Connector_ USB-B-S-X-W-TH.STEP
3dmodels/Connector_3,96mm 2P.STEP
3dmodels/Connector_Header_Male_1Pin.STEP
3dmodels/Connector_Header_Male_RA_Low_1Pin.STEP
3dmodels/Connector_RJ45_molex_855135013.stp
3dmodels/Connector_Samtec-SMA-J-P-H-RA-TH1.step
3dmodels/Connector_USB_90_A_molex_482040001.stp
3dmodels/Connector_USB_A_th.stp
3dmodels/Connector_molex_430451609.stp
3dmodels/Connector_molex_436500812.stp
3dmodels/Connector_telefon_molex_95503-6451.stp
3dmodels/Cristal-ABM3B.STEP
3dmodels/D2PAK_TO263-2.STEP
3dmodels/D2PAK_TO263-3.STEP
3dmodels/DIODE_sub-sma.STEP
3dmodels/DIP 14 IC.step
3dmodels/DIP 16 IC.step
3dmodels/DIP SWITCH HALF PITCH SMD X2.step
3dmodels/DIode_SMC.STEP
3dmodels/Didital_TSSOP20.step
3dmodels/Digital-QFN 24 4x4.step
3dmodels/Digital_SOIC28.step
3dmodels/Digital_TSSOP-24.step
3dmodels/Diode-DO-214AA SMB.STEP
3dmodels/Diode-DO-35_300mils.STEP
3dmodels/Diode-DO-41-2.step
3dmodels/Diode-SOD-87.step
3dmodels/Diode-TSOC6.STEP
3dmodels/Diode_DO-214AB.step
3dmodels/ESP32-C3 SuperMini - Part 1.step
3dmodels/Euroblock 3.5mm 1X8P.STEP
3dmodels/Euroblock 3.5mm 2X10P.STEP
3dmodels/Euroblock 3.5mm 2X12P.STEP
3dmodels/Euroblock 3.5mm 2X8P.STEP
3dmodels/Euroblock 5.0mm 1X2P.STEP
3dmodels/FET_D2PAK-7.step
3dmodels/Flat_SMD_button.step
3dmodels/Fuse 2920.step
3dmodels/Fuse-Littlefuse-1210.STEP
3dmodels/Fuse_1206.step
3dmodels/Gate_SOT363.step
3dmodels/Header SMD 2-Pin (2x1) .STEP
3dmodels/Header_F_2.54mm_1x3.step
3dmodels/Header_euroblock-STL1550_G3_5-2-H-1.step
3dmodels/Hedar 20PIN 2_54mm.step
3dmodels/Inductor_ 0603.step
3dmodels/Inductor_1210.step
3dmodels/Inductor_12x12x6mm-4800C.step
3dmodels/Inductor_1812(4532M).step
3dmodels/Inductor_SDR0403 Series.step
3dmodels/JST-XH-R-2_5mm-6.step
3dmodels/LAN transformer_PULSE H1260FNL .step
3dmodels/LED OSRAM sideled.step
3dmodels/LED-optical-SOP-4.step
3dmodels/LED-smd_led_5050.step
3dmodels/LED_ RGB_3,2x2,7mm.step
3dmodels/LED_0603_B.STEP
3dmodels/LED_0603_G.STEP
3dmodels/LED_0603_R.STEP
3dmodels/LED_0603_W.STEP
3dmodels/LED_0603_Y.STEP
3dmodels/LED_APA3010GCCK_BLUE.step
3dmodels/LED_APA3010GCCK_GREEN.step
3dmodels/LED_APA3010GCCK_RED.step
3dmodels/LED_APA3010GCCK_YELLOW.step
3dmodels/LED_SW3dPS-Disp_SA56-11.STEP
3dmodels/LED_d3-RED.STEP
3dmodels/LGA 16 (3x3x1mm).step
3dmodels/LQFP48-7x7-0_50.step
3dmodels/MK15-x-2_WEB.step
3dmodels/MODUL-ESP-03.STEP
3dmodels/MPXHZ6400A.step
3dmodels/MSOP10-1.step
3dmodels/Mem-TSOP2-44_IS.STEP
3dmodels/Modul-UBLOX_GPS.step
3dmodels/Modul_GPS-max7.step
3dmodels/Modul_LCD_5110.stp
3dmodels/Modul_LCD_EA_DOG128-6.step
3dmodels/Modul_RFM12.step
3dmodels/Multifuse1.STEP
3dmodels/Multifuse2.STEP
3dmodels/NMJ6HFD2.stp
3dmodels/OLED-1_3-128X64.step
3dmodels/PT12-21B_TR8.STEP
3dmodels/Quartz ABRACON ABS10.STEP
3dmodels/Quartz-ABM3-1.STEP
3dmodels/RES_TrimPot_15mm.step
3dmodels/RES_Trimpot Horizontal.step
3dmodels/RES_bourns 3296 pot.step
3dmodels/RES_bourns 3296 pot_90.step
3dmodels/RES_trimmer_10mm_square.step
3dmodels/RES_trimmer_10mm_square_90.step
3dmodels/RES_trimmer_6,5mm.step
3dmodels/RJ11_GCT_MJ3205-66-1-X-X_revA.step
3dmodels/RJ11_GCT_MJ3405-64-X_revB.step
3dmodels/RJ11_GCT_MJ3410-64-X_revC.step
3dmodels/RJ11_SMD_6p4c_molex_85502_5006.stp
3dmodels/RJ45-TH_DS1128-09-S8B8X.step
3dmodels/RJ45-TH_R-RJ45R08P-A004.step
3dmodels/Resistor, 0,125W.STEP
3dmodels/Resistor, 0,5W.STEP
3dmodels/Resistor, 0.25 W.STEP
3dmodels/Resistor_1210.step
3dmodels/Resistor_2W.step
3dmodels/Resistors 5W PCB Horizontal.step
3dmodels/SMD_Inductor1.STEP
3dmodels/SMD_Quartz_SMU4.STEP
3dmodels/SMD_header_2.00mm_m_2x6.step
3dmodels/SO-20 (Wide).step
3dmodels/SO16w.step
3dmodels/SOIC-14.step
3dmodels/SOIC-16.STEP
3dmodels/SOIC8_Wide_5mmx5mm.step
3dmodels/SOT143.step
3dmodels/SOT323-sc70-3.step
3dmodels/SPPJ311500.STEP
3dmodels/SW3dPS-SD SOKET HAFIZALI.STEP
3dmodels/Sorkapocs_2 Way PCB Screw Terminal Block 5mm.step
3dmodels/Sorkapocs_3 Way PCB Screw Terminal Block 5mm.step
3dmodels/Switch_DIP switch 4 TH.stp
3dmodels/TE_1-2834015-4.stp
3dmodels/TH_LED_3mm_R.STEP
3dmodels/TO-263 5Ld.step
3dmodels/TO-92_STR.STEP
3dmodels/TO220-3 bent legs.step
3dmodels/TO220-3 bent legs_inv.step
3dmodels/TO220.STEP
3dmodels/TO252AA.STEP
3dmodels/TS-1088-AR02016.step
3dmodels/TSSOP-28_P065.STEP
3dmodels/Terminal Blocks socket right angle 3.50 mm 9.stp
3dmodels/UBLOX-MAX-M8.step
3dmodels/UBLOX_GPS_NEO-M8.step
3dmodels/USB3.0-B-692221030100.stp
3dmodels/USON_8_4x4mm.step
3dmodels/User Library-1_3_OLED.STEP
3dmodels/User Library-GF-126-0159.step
3dmodels/User Library-SOD-523F.step
3dmodels/User Library-SOD80-2.STEP
3dmodels/User Library-SWT9-1.step
3dmodels/User Library-Sw Slide DPDT 1.step
3dmodels/User Library-TCRT-5000.STEP
3dmodels/User Library-Tactile Switch 12x12x8.step
3dmodels/User Library-ss22f07g10-g.step
3dmodels/User Library-tact switch 12x12x8mm.step
3dmodels/VL53L1CXV0FY-1.step
3dmodels/WE-TPC_5818.step
3dmodels/WR-WTB 2,54mm_2p.stp
3dmodels/WR-WTB 2,54mm_3p.stp
3dmodels/WR-WTB_2_54mm_3p _90.stp
3dmodels/Xtal-ABM7.STEP
3dmodels/b4b-ph-k-s.step
3dmodels/c-1825232-1-b-3d.stp
3dmodels/connector-B4B-PH-SM4(LF)(SN).step
3dmodels/connector-IDC Socket Male 14pin_ 2_54mm.step
3dmodels/led 5mm 3 pin.step
3dmodels/molex_734120114.stp
3dmodels/quectel-L80-R.step
3dmodels/xb-ts-1103st-x-a.stp
