kerteszsasa/kicad_user_lib/(commit log)

2025-06-11 Footprints from Altium
2025-06-11 3D models from Altium
    [0402 SMD Resistor.step, 10118192C.step, 20020327c021b01lf.stp, 20020327c031b01lf.stp, 2410 fuse.step, 2W_5mm_screw_282836-2.stp, 35485.stp, 3W_5mm_screw_282836-3.stp]
2025-06-23 Add 2P and 3P screw terminals
    [CONN-TH_DB5.00-LI-2P-126.step, CONN-TH_WJ5.00-LI-3P-126.step]
2025-06-23 Add 5 way switch
    [SW-SMD_8P-L7.0-W7.0-P1.40-LS7.4-TL.step]
2025-06-24 Add oled 128x32
    [OLED-TH_L38.0-W12.0_HS91L02W2C01.step]
2025-06-24 Fix cap_3216_pol footprint
2025-06-24 Fix CR20xx footprint
2025-06-24 Add LSM6DS3TR-C
    [LGA-14_L2.5-W3.0-H0.9-P0.50.step]
2025-06-24 Add IPEX connector and SD card socket
    [IPEX-SMD_BWIPX-1-001E.step, TF-SMD_TF-02.step]
2025-06-24 Add MCP2518FDT-E_SL
    [SOIC-14_L8.6-W3.9-H1.8-LS6.0-P1.27.step]
2025-06-24 Add 40Mhz crsytal
    [CRYSTAL-SMD_4P-L3.2-W2.5-BL.step]
2025-06-24 Add MCP2562FD-E_SN
    [SOIC-8_L4.9-W3.9-H1.7-LS6.0-P1.27.step]
2025-06-24 Add 0603 R
    [R0603.step]
2025-06-24 Add CAP0603
    [C0603.step]
2025-06-25 Modify SD card socket pin names: From CD to Card_detect
2025-06-25 Bound footprints to components
2025-06-25 Add 3V RS232 transciever
2025-06-25 Add ESD diode for USB
    [SOD-523_L1.2-W0.8-LS1.6-BI.step]
2025-06-26 Add generic 0402 R and C
    [C0402.step, R0402.step]
2025-06-26 Add generic 0805 and 1206 C
    [C0805.step, C1206.step]
2025-06-26 Add generic 0805 and 1206 R
    [R0805.step, R1206.step]
2025-06-26 Add TPS54302DDCT
    [TSOT-23-6_L2.9-W1.6-H1.1-LS2.8-P0.95.step]
2025-06-26 Add CR2032 holder
    [BAT-SMD_CR2032-3V.step]
2025-06-26 Add CR1220 battery holder
    [BAT-TH_MY-1220-01.step]
2025-06-26 Add 32.768kHz smd crystal
    [OSC-SMD_L3.2-W1.5-H0.8.step]
2025-06-26 Add RTC
    [TSSOP-8_L3.0-W3.0-H1.1-LS4.9-P0.65.step]
2025-06-26 Add LBAS40 diode series
    [SOT-23-3L_L2.9-W1.6-H1.1-LS2.8-P0.95.step, SOT-23-3P_L2.9-W1.3-H1.0-LS2.4-P0.95.step]
2025-06-26 Update LBAS40 diodes
2025-06-27 Add 2x2.5mm 10uH inductor
    [IND-SMD_L2.5-W2.0-H1.2.step]
2025-06-27 Update micro SD card holder
    [TF-01A.step]
2025-07-01 Update HS91L02W2C01 3d model
    [HS91L02W2C01.stp]
2025-07-10 Add 2P and 3P screw teminals wirh 3.5mm pitch
    [CONN-TH_DB301V-3.5-2P-GN.step, CONN-TH_DB301V-3.5-3P-GN.step]
2025-07-10 Add WS2812 leds
    [LED-SMD_4P-L2.0-W1.8_CY-0807.step, LED-SMD_4P-L5.0-W5.0-H1.6-P3.2.step]
2025-07-10 Add Finder 93.11 PCB SOCKET
    [RELAY-TH_93.11.step]
2025-07-12 Add ACS712ELCTR-05B-T current sensor
2025-07-12 Add AO4292E fet
2025-07-12 Add 1N4148WS diode
    [SOD-323_L1.8-W1.3-LS2.5-RD.step]
2025-07-12 Add 1N5819WS diode
2025-07-13 Add 3d model to AG9924 poe module
    [Ag9900.step]
2025-07-13 Add 1210 50mA and 100mA resettable fuses
    [F1210_L3.2-W2.6-H0.6.step]
2025-07-17 Fix 3D models
    [CONN-SMD_4P-L6.0-W2.9-H4.3-P1.0.step, ESP32-WROOM-32D-N4.STEP, QFN50P400X400X100-25N.STEP]
2025-07-17 Fix RJ45 footprint
2025-08-15 Add components: i2c digipot, analog mux, and gate
    [SC-70-6_L2.0-W1.3-P0.65-LS2.1-BL.step, SOP-16_L9.9-W3.9-P1.27-LS6.1-BL.step, SOT-23-5_L2.9-W1.6-H1.1-LS2.8-P0.95.step]
2025-10-06 Add 6 pin connector: HC-XH-6AW-G
    [CONN-TH_6P-P2.50_HC-XH-6AW-G.step]
2025-12-03 New components: HXTS-1101-C-W, PEC11R-4215F-S0024, XL-0807RGBC-2812B_0_1
    [LED-SMD_4P-L2.0-W1.8_XL-0807RGBC-WS2812B.step, SW-SMD_HX-TS-1101-C-W.step, SW-TH_5P-L12.5-W13.4-P2.50-LS14.5.step]
2025-12-03 Adjust encoder footprint: add contour
2025-12-18 New components: MT3608, TP4056_C382139, EC12D1564402
    [ESOP-8_L4.9-W3.9-H1.6-LS6.0-P1.27.step, SOT-23-5_L2.9-W1.6-P0.95-LS2.8-BR.step, SOT-23-6_L2.9-W1.6-H1.5-LS2.8-P0.95.step, SW-TH_EC12D1564402-L12.5-W11.7-H17.5-P11.1-LS14.1.step]
2026-01-09 Add AP2111H supply and a 1x15 pint testpoint
    [KLS1-202E-06-S-B.step, SOP-16_L9.9-W3.9-H1.5-LS6.0-P1.27.step, SOT-223-4P_L6.5-W3.5-H1.6-LS7.0-P2.30.step]
2026-01-14 New test points
    [P100-E2.STEP]
2026-01-28 Update 3D models at old footprints
2026-02-13 Add fuel_probe specific footprints
    [Inductor_0805.step, SOT-23-5_L2.9-W1.6-P0.95-LS2.8-BL.step]
2026-02-24 Add MODULE_ESP32-S3-ZERO
    [ESP32-S3-Zero_v2.stp]
2026-02-25 Footprint for ublox_lea module bord shape
2026-04-13 Update libs
    [CAP-SMD_BD10.0-L10.3-W10.3-LS11.3-FD.step, CAP-SMD_BD6.3-L6.6-W6.6-FD.step, CAP-SMD_L4.3-W4.3-H5.3-LS5.1.step, DC-IN-TH_DC-005-A200.step, RJ11-TH_FRJ11008-1100K6K20.step]
2026-07-15 Update components: smd testpad, rf connector 3d model, diode
    [Rf_conn_SMB.stp]
2026-11-10 New coomponent : ESP32-C3FH4
2026-11-10 Add LCSC_importer as a Kicad plugin
2026-11-10 Move kicad import script to 'scripts' folder
2026-11-10 Update RJ11 footprint
2026-11-10 Script for release hw production files, and a kicad wrapper for starting it from the pcb editor. The release script checks errors before it creates files.
2026-11-11 Update footprints on silk layer.
